HJDSS/STM32-SmartHome-Security/FIX_REPORT.md

# 论文-代码差距修复报告

> **日期:** 2026-05-18  
> **基准版本:** M1.14a → **修复后版本:** M1.15  
> **分支:** rescue/auto-rollback-20260427-0000  
> **修复方式:** 14个子Agent分3批并行修复，主Agent调度+审查+提交

---

## 修复统计

| 类别 | 数量 | 说明 |
|---|---|---|
| 🔴 严重问题已修复 | 14 | 13个代码问题 + 1个外部分析结论 |
| 🔴 未修复 | 1 | #14 移动端代码（不在本仓库范围） |
| 修改文件 | 18 | .c / .h 文件 |
| 新增代码行 | ~1200+ | 含宏定义、函数实现、注释 |
| Git提交 | 4 | 1个批次独立 + 3个批次合并 |

---

## 第1批修复 (M1.15a-b, 2 commits)

| # | 问题 | 状态 | 关键变更 |
|---|---|---|---|
| #11 | ESP8266指数退避 | ✅ | `s_backoff_ms` 1200→2400→...→60000ms，成功重置 |
| #3 | 指纹解锁接入 | ✅ | Task_Log中200ms周期调用AS608_Find_Fingerprint，匹配→开锁 |
| #1 | IPC机制 | ✅ | Queue(8)+EventGroup(3bits)+BinarySemaphore+Mutex，全局变量保护 |
| #12-13 | 蜂鸣器分级 | ✅ | beep_pattern_t五模式+软件BEEP_Tick10ms引擎 |
| #10 | AES加密方案 | ✅ | CTR→CBC, CRC16→AES-CBC-MAC(HMAC), 单密钥→双密钥窗口 |

**修改文件18个，+723/-74行**

---

## 第2批修复 (M1.15c, 1 commit)

| # | 问题 | 状态 | 关键变更 |
|---|---|---|---|
| #4 | Task_Log职责 | ✅ | STK:320→1024, PRIO:1→3, T:1000→200ms, 指纹+告警队列+抓拍 |
| #2 | FreeRTOS抓拍 | ✅ | Task_Log中调用Bare_CapturePoll() |
| #6 | MQ-2滤波 | ✅ | 中值(5样本)+滑动平均(8样本)级联 |
| #7-8 | MQ-2阈值+基线 | ✅ | Q8 IIR基线跟踪, 自适应阈值=基线+3σ+40ADC |

**修改文件4个，+143/-39行**

---

## 第3批修复 (M1.15d, 1 commit)

| # | 问题 | 状态 | 关键变更 |
|---|---|---|---|
| #5 | MQ-2温漂补偿 | ✅ | Acomp=Araw-3.2*(T-25), Q8定点, K=819 |
| #16 | MQ-2多浓度标定 | ✅ | 5级分段线性插值(0/300/1000/2000/3000ppm) |
| #9 | 多传感器融合 | ✅ | S=0.5*ePIR+0.3*eCAM+0.2*eACC, S≥0.5高可信 |
| #15 | 性能指标 | ✅ | 11个全局计数器+时间戳+uptime+栈溢出日志修复 |
| #17 | 常量清理 | ✅ | 死常量注释保留，任务参数表与app_rtos.c对齐 |

**修改文件9个，+338/-74行**

---

## 未修复项

| # | 问题 | 原因 |
|---|---|---|
| #14 | 移动端代码缺失 | uni-app为独立项目，不在STM32仓库。论文可注明"移动端代码位于独立仓库" |

---

## 提交记录

```
a3434257 fix(M1.15d): 第3批 — 温漂补偿+多浓度标定+融合评分+性能指标+常量清理
e1464dc6 fix(M1.15c): 第2批 — Task_Log职责+抓拍FreeRTOS+MQ-2滤波+自适应阈值基线
1eba3e32 fix(M1.15b): 第1批 — 指纹接入+IPC+蜂鸣器分级+AES方案修复
ca98cb1d fix(M1.15a): ESP8266重连指数退避 — 论文要求上限60秒
1adbd4c6 docs: VERSION_DOCS 更新至 M1.14a
```

---

## 修复前后对比

| 维度 | M1.14a（修复前） | M1.15（修复后） |
|---|---|---|
| 🔴 严重问题 | 17 | 1 (移动端，不在仓库范围) |
| IPC机制 | 无，全局变量裸访问 | Queue+EventGroup+Semaphore+Mutex |
| 指纹解锁 | 死代码，仅密码通道 | 双通道验证 |
| 蜂鸣器 | 单一GPIO开关 | 5种分级告警模式 |
| AES加密 | CTR+CRC16+单密钥 | CBC+HMAC+双密钥窗口 |
| MQ-2滤波 | 简单8样本平均 | 中值+滑动平均级联 |
| MQ-2阈值 | 固定2400 ADC | 自适应基线+3σ+裕量 |
| MQ-2标定 | 单线性换算 | 5级分段插值 |
| 温漂补偿 | 无 | Q8定点 Acomp=Araw-3.2*(T-25) |
| 融合评分 | 无 | S=0.5*PIR+0.3*CAM+0.2*ACC |
| 抓拍(FreeRTOS) | 损坏 | 可用 |
| Task_Log | 空壳看门狗任务 | 完整的后台任务 |
| 性能测量 | 不可测 | 11项计数器+时间戳+uptime |
| ESP8266重连 | 固定1200ms | 指数退避(上限60s) |
| board_config | 16个死常量 | 清理+任务表对齐 |
