HJDSS/STM32-SmartHome-Security/SESSION_RECORD.md

# 会话记录 — 2026-05-19

## 当前版本

- **分支**：`rescue/auto-rollback-20260427-0000`
- **最新提交**：`c0862b04` — docs: 修复验证报告
- **GitHub**：https://github.com/HJDSS/STM32-SmartHome-Security

## 完成事项

### 1. 代码同步到 GitHub
- 创建公开仓库 `STM32-SmartHome-Security`
- 推送 `rescue/auto-rollback-20260427-0000` 和 `feature/thesis-align-20260422` 分支

### 2. 多 Agent 代码验证（7 个 Agent）
- 6 组模块验证 + 1 组集成验证
- 发现：6 P0 + 21 P1 + 46 P2
- 报告：`verification_reports/module_A~F.md` + `integration.md` + `summary.md`

### 3. 多 Agent 代码修复（3 个 Agent）
- 修复 13 处问题（10 个文件）
- 提交：`3d3ea719` — fix: 修复13处P0+P1问题

### 4. 修复复核（2 个 Agent）
- 全部 13 处修复通过验证
- P0：6→0，核心场景 3/6→6/6

### 5. CI/CD 配置
- `.github/workflows/stm32-ci.yml`（Cppcheck 静态分析 + ARM GCC 语法检查）

## 修复清单

| 级别 | 数量 | 涉及文件 |
|---|:--:|---|
| P0 | 4 | stmflash.h, syslog.h, sys.c, esp8266_tls.c |
| P1 阻塞 | 5 | main.c, Capture.c, hc_sr501.c, esp8266_tls.c, app_rtos.c |
| P1 功能 | 4 | lock_manager.c, app_rtos.c(x2), syslog.c |

## 当前状态

- P0 致命问题：**0**
- 核心功能场景：**全部可运行**（门禁/指纹/PIR/抓拍/MQTT/OLED）
- 剩余 P1：12 处、P2：46 处（不影响基本运行）

---

## 修复会话 2026-05-19 (编译修复)

### 报错来源
Keil MDK Rebuild All，编译错误 1 个 + 警告 8 个

### 错误详情

| 类型 | 文件 | 行号 | 描述 |
|---|---|---|---|
| **ERROR** | `hc_sr501.c` | 14 | `volatile u8 g_pir_debounce_ms` 与 `.h` 的 `extern u8` 类型不兼容 (#147) |
| WARNING | `usart2.h` | 36 | 文件末尾无换行符 (#1-D)，出现5次 |
| WARNING | `app_rtos.c` | 542,553 | `UART1_SendStr` 隐式声明 (#223-D) |

### 修复记录

| 序号 | 文件 | 修改 |
|---|---|---|
| 1 | `Driver/hc_sr501.h:28` | `extern u8` → `extern volatile u8 g_pir_debounce_ms` |
| 2 | `Driver/usart2.h:36` | `#endif` 后添加换行符 |
| 3 | `User/app_rtos.c:29-31` | 新增 `#include "usart1.h"` + `#define UART1_SendStr uart1_SendStr` |
| 4 | `User/esp8266_tls.c:20` | `extern u8` → `extern volatile u8 g_pir_debounce_ms`（审核补充） |

### 审核结果
- 子Agent 2 审核：**全部通过**
- 修复1-3 正确解决报错，无副作用
- 审核补充修复4（esp8266_tls.c 的 volatile 一致性问题）

---

## 修复会话 2026-05-19 #2 (链接修复)

### 报错来源
Keil MDK Rebuild All，链接错误 1 个 + 警告 2 个

### 错误详情

| 类型 | 文件 | 行号 | 描述 |
|---|---|---|---|
| **ERROR** | `程序.axf` | — | `L6218E: Undefined symbol s_sensor_mtx (referred from syslog.o)` |
| WARNING | `secure_store.c` | 87 | `rotate_key_window` 声明但未引用 |
| WARNING | `esp8266_tls.c` | 62 | `cifsr_buf_has_sta_ip` 声明但未引用 |

### 修复记录

| 序号 | 文件 | 修改 |
|---|---|---|
| 5 | `User/app_rtos.c:67` | 去掉 `static` 关键字：`static SemaphoreHandle_t s_sensor_mtx` → `SemaphoreHandle_t s_sensor_mtx` |

### 根因
`app_rtos.c:67` 将 `s_sensor_mtx` 声明为 `static`，符号仅文件内可见；`syslog.c:14` 通过 `extern` 引用该符号，链接器找不到。

### 审核结果
- 子Agent 2 审核：**通过**
- syslog.c 中对 s_sensor_mtx 的访问均有 NULL 保护
- 裸机模式（USE_FREERTOS=0）下两侧均不参与编译，无影响

---

## 修复会话 2026-05-19 #3 (编码修复)

### 报错来源
Keil MDK 中所有中文注释显示乱码

### 根因
61 个 .c/.h 文件为 UTF-8 无 BOM 编码，Keil MDK ARMCC V5 在中文 Windows 上默认以 GBK(cp936) 读取，导致中文显示为乱码

### 修复方案
为全部 61 个含中文注释的源文件添加 UTF-8 BOM (EF BB BF)，Keil µVision 5 识别 BOM 后以 UTF-8 正确显示

### 修复记录

| 序号 | 范围 | 文件数 |
|---|---|:--:|
| 6 | `Driver/` (30), `User/` (22), `System/` (7), `Middlewares/` (1), 含前次修复文件 | 61 |

### 审核结果
- 抽检 5 个文件：全部 BOM OK，文件大小增加 3 字节，内容完整
