HJDSS/STM32-SmartHome-Security/biye/代码完善提示词_含版本管理.md

# 用于完善 `biye` 代码的提示词（含版本管理，2026-04 更新版）

以下内容可直接复制到 Cursor / Copilot / ChatGPT（代码模式）中执行。

---

你现在是“广东工业大学测控技术与仪器本科毕设工程实现助手”。  
请基于我的论文实现和现有工程代码，对 `biye` 项目做**功能补全与一致性修正**，并严格执行版本管理流程。

## 1) 项目背景与总目标（最新版）

- 论文主题：家用安防与智能家居联动系统（STM32F103RCT6）
- 工程形态：以 `board_config.h` 为硬件配置基线，支持裸机调试路径，并保留 FreeRTOS 论文描述对应实现
- 目标：让代码与论文中的硬件接口、功能逻辑、测试指标、异常处理策略保持一致，形成可编译、可联调、可验收版本
- 关键新增要求：摄像头抓拍时**必须本地落盘一份到 SD 卡**（云端查看与本地留存双通道）

## 2) 必须遵循的全局约束

1. **不改变核心硬件选型与引脚事实**（以 `biye/代码/User/board_config.h` 为准）
2. **不删除现有可用功能**，仅做补全、修复、对齐
3. **所有改动必须可追踪**：按功能拆分提交，提交信息清晰，禁止一次性大杂烩提交
4. **代码风格统一**：沿用当前工程风格（标准外设库/HAL兼容方式、命名风格、注释风格）
5. **优先保证稳定性**：先修编译与关键链路，再做增强

## 3) 与论文和历史记录对齐的功能清单（按优先级）

### P0（必须完成）

1. **ESP-01S 通信链路对齐**
   - USART3: PB10/PB11
   - EN/CH_PD: PC9
   - 默认波特率与联网参数走 `board_config.h` 宏
   - 启动流程：AT连通性检查 -> 入网 -> MQTT会话
   - 异常：重连、超时、状态回执

2. **SD 卡模块对齐**
   - SPI2: PB13/PB14/PB15，CS=PB12
   - FatFs 挂载流程与容错参数按 `board_config.h`
   - 仅在 `EN_FATFS_SD` 启用时生效
   - 挂载成功后再开放 BMP/日志写入，避免未就绪访问
   - 抓拍触发时执行：`OV7670/FIFO取帧 -> BMP编码 -> SD本地落盘`
   - 网络在线：上报图片地址/抓拍时间；网络离线：本地缓存待上报记录，重连后补传
   - 写卡失败不得阻塞本地安防告警动作（降级但不中断安全链路）

3. **DHT 与 MQ-2 对齐**
   - DHT 引脚 PC5，按 `BOARD_DHT_SENSOR_TYPE` 区分 DHT11/DHT22
   - MQ-2 ADC: PB0 / ADC_Channel_8
   - 采样、滤波、阈值判定逻辑与论文一致
   - 处理传感器失效/超时/悬空边界
   - 传感器离线检测与恢复：
     - DHT：连续超时/校验失败置离线，指数退避重试，连续成功自动恢复
     - MQ-2：长时间恒定或越界置异常，异常期间禁止触发应急关阀误动作
     - PIR：非布防高频触发进入抑制窗口并记日志

4. **执行器链路对齐**
   - 门锁 PC6，燃气阀 PC7，蜂鸣器 PC10
   - 蜂鸣器触发极性由 `BOARD_BEEP_ACTIVE_HIGH` 控制
   - 异常状态进入安全态（尤其复位后）
   - 看门狗复位后：执行器默认安全态（关阀、门锁默认态、蜂鸣器关闭）

### P1（建议完成）

5. **异常工况机制补全**
   - 断网离线可运行
   - 传感器故障降级
   - 电源波动/重启恢复
   - 强干扰下去抖与恢复
   - 重连幂等：下行命令基于 `cmdId+ts` 去重，避免重复执行

6. **日志与诊断**
   - 关键链路增加统一日志标签（NET/SD/SENSOR/ACT）
   - 支持简洁日志与详细调试日志开关（宏控制）
   - 必须可追踪以下事件：挂载成功/失败、抓拍开始/结束、BMP落盘成功/失败、重连开始/成功、离线/恢复

7. **参数集中化**
   - 将可调阈值、超时、重试次数集中到配置头文件
   - 杜绝魔法数字散落

### P2（可选增强）

8. **论文测试映射辅助**
   - 导出/打印便于统计的关键计数器（成功率、重试、异常次数）
   - 为第6章测试复现提供最小脚本或操作说明
   - 支持导出以下统计字段：误报率计数、重连次数、补传次数、SD写入失败次数、72h运行异常次数

## 4) 具体实施步骤（请按顺序执行）

1. 阅读并建立“事实清单”
   - 重点文件：`User/board_config.h`
   - 补充读取：ESP、SD、DHT、MQ2、执行器相关驱动与业务文件
   - 产出：当前实现与论文要求的差异列表

2. 分模块改造（每个模块独立提交）
   - `feat/net-esp01s-align`
   - `feat/sd-spi2-fatfs-align`
   - `feat/sensor-dht-mq2-align`
   - `feat/actuator-safety-align`
   - `feat/abnormal-recovery`
   - `feat/capture-sd-local-retention`

3. 每次改动后执行最小验证
   - 编译通过
   - 关键路径无回归
   - 日志可证明功能生效

4. 产出最终文档
   - 变更摘要（改了什么、为什么）
   - 测试记录（如何测、结果如何）
   - 与论文章节对应关系（第3/4/6章）
   - 关键闭环说明（抓拍->本地落盘->上报/补传）

## 5) Git 版本管理要求（严格执行）

1. **新建功能分支**
   - 分支命名：`feature/thesis-align-YYYYMMDD`

2. **提交粒度**
   - 一个功能点一个 commit
   - 提交信息格式：
     - `feat(sd): align SPI2 pin mapping and mount flow with board_config`
     - `fix(esp): enforce EN/CH_PD boot sequence and reconnect handling`
     - `refactor(sensor): centralize DHT/MQ2 thresholds and retry params`

3. **禁止操作**
   - 禁止 `git reset --hard`
   - 禁止覆盖他人未确认改动
   - 禁止一次提交改几十个不相关文件

4. **里程碑标签**
   - 完成 P0 后打 tag：`v0.9-thesis-align-core`
   - 完成 P1 后打 tag：`v1.0-thesis-align-stable`
   - 完成“抓拍本地留存闭环”后可选 tag：`v1.1-capture-sd-retention`

5. **交付前检查**
   - `git status` 干净
   - 构建通过
   - 变更说明文档已更新
   - 抓拍触发后能在 SD 中检索到对应 BMP 文件（含时间戳）

## 6) 验收标准（必须全部满足）

1. 编译通过，无新增严重告警/错误  
2. ESP、SD、DHT/MQ2、执行器链路与 `board_config.h` 一致  
3. 关键异常场景可复现并有容错表现  
4. 提交历史清晰，能看懂每一步改动目的  
5. 代码行为与论文第3章（硬件）、第4章（软件）、第6章（测试）不冲突  
6. 抓拍场景下“云端可见 + SD本地可查”双通道同时成立  
7. 离线场景下至少保证“本地告警 + SD留存”可用

## 7) 输出格式要求（让助手按此返回）

请按以下结构输出你的工作结果：

1. 差异分析（现状 vs 目标）  
2. 改动计划（按P0/P1/P2）  
3. 实际改动文件清单  
4. 每个 commit 的摘要  
5. 验证结果与遗留问题  
6. 下一步建议

---

如果你发现论文描述与 `board_config.h` 冲突，**以代码硬件事实为准**，并在变更说明中标注“论文待同步项”。
