HJDSS/STM32-SmartHome-Security/biye/硬件/PCB硬件连线说明.md

# PCB 硬件连线说明（用于画板/对照程序）

**文档目的**：给 PCB 设计/接线使用，列出工程涉及的**全部硬件功能**（含当前未启用/未实现但已预留的功能），并确保与程序的**实际引脚分配与逻辑**一致。  
**引脚权威来源**：`biye\代码\User\board_config.h`（最终以该文件为准）。  
**行为约束来源**：`biye\代码\User\main.c`、`biye\代码\Driver\gpio.h/.c`、`biye\代码\User\linkage.*`、`biye\代码\System\usart\usart1.c` 等。

---

## 1. 核心信息（必须先看）

- **MCU**：STM32F103RCT6（LQFP64，3.3V 逻辑电平，72MHz 典型配置）
- **调试下载口**：**SWD 固定占用 PA13/PA14**；程序会**关闭 JTAG、保留 SWD**（见 `main.c` 的 `GPIO_PinRemapConfig(GPIO_Remap_SWJ_JTAGDisable, ENABLE)`）。
- **摄像头固定启用**：`board_config.h` 中 `EN_OV7670_LOCAL` 在全功能与密码调试模式都为 1（键盘 Y3/Y4 固定 PB1/PB2，且 **PA0~PA7 被 OV 数据总线占用**）。
- **关键冲突点（设计时必须二选一）**：
  - **PC8**：默认被配置成 **printf 软件串口 TX**（`BOARD_PRINTF_SOFTUART_PC8=1`，见 `usart1.c`），此时**照明继电器功能会被屏蔽**（`linkage.c` 中 `#if !BOARD_PRINTF_SOFTUART_PC8` 才驱动灯继电器）。
  - **USART1（PA9/PA10）**：既连接 **AS608 指纹模块**，又可能承载调试串口（`uart1_SendStr/printf`）。硬件上允许并联 USB‑TTL，但实际使用建议分时，避免干扰。

---

## 2. 供电与电气约束

- **3.3V 供电**：STM32、OLED、OV7670、SD（部分卡可 3.3V）、ESP8266（多数模块需稳定 3.3V、大电流峰值）、AS608、传感器等建议统一 3.3V 域。
- **5V 模块注意**：若 PIR/MQ2/继电器板为 5V，需确认其 IO 电平是否可直接与 3.3V MCU 兼容；不兼容时必须做电平转换/三极管隔离。
- **共地**：所有模块必须与 MCU **GND 共地**（外接 USB‑TTL/独立电源也必须共地）。
- **继电器/蜂鸣器驱动**：PCB 上建议预留**三极管/MOS 驱动 + 续流二极管**（若模块已带驱动则可直连信号）。

---

## 3. 接口分区与信号列表（按功能分组）

> 说明：下表中的“方向”是相对 MCU；“默认状态”是上电初始化后的预期（与驱动代码一致）。

### 3.1 下载与保留引脚

| 功能 | MCU 引脚 | 方向 | 备注 |
|---|---|---|---|
| SWDIO | PA13 | 双向 | **必须保留**，不要接外设 |
| SWCLK | PA14 | 输入 | **必须保留**，不要接外设 |
| NRST | NRST | 输入 | 建议引出到调试接口；可加 RC/按键复位 |
| BOOT0 | BOOT0 | 输入 | 建议预留跳帽/电阻位，便于量产/救砖 |

补充说明：

- **USART2（PA2/PA3）在本工程未初始化**，且 **PA0~PA7 已被 OV 数据口占用**（因此不要规划 PA2/PA3 作外设 UART）。
- **USB 功能不在本工程使用范围**：摄像头占用 **PA12**（在很多资料里 PA12 常与 USB D+ 相关），此工程以 OV 采集为主。

### 3.2 OLED 显示（I2C，软件模拟）

| 功能 | MCU 引脚 | 方向 | 连接对象 | 备注 |
|---|---|---|---|---|
| I2C_SCL | PB8 | 输出/开漏（软件） | OLED SCL | 模块必须是 **I2C 四线款**（VCC/GND/SCL/SDA） |
| I2C_SDA | PB9 | 双向/开漏（软件） | OLED SDA | 建议上拉（常用 4.7k~10k 到 3.3V，部分模块自带） |

### 3.3 4×4 矩阵键盘

**扫描方式**：行 X 上拉输入、列 Y 推挽输出（见 `board_config.h` 注释）。长杜邦线建议列端上拉并适当去抖（固件已对长线做了更保守的时序参数）。

| 键盘信号 | MCU 引脚 | 方向 | 建议 |
|---|---|---|---|
| X1 | PC0 | 输入 | 行线建议上拉；避免与强干扰走线并行 |
| X2 | PC1 | 输入 | 同上 |
| X3 | PC2 | 输入 | 同上 |
| X4 | PC3 | 输入 | **不要误接到 PC10（蜂鸣器）**；也不要接 PC13（部分核心板 LED） |
| Y1 | PC11 | 输出 | 列端建议并 4.7k~10k 上拉到 3.3V（长线抗干扰） |
| Y2 | PC12 | 输出 | 同上 |
| Y3 | PB1 | 输出 | **固定**；与 OV 数据总线无冲突 |
| Y4 | PB2 | 输出 | **固定**；与 OV 数据总线无冲突 |

### 3.4 蜂鸣器

| 功能 | MCU 引脚 | 方向 | 默认状态 | 备注 |
|---|---|---|---|---|
| BEEP | PC10 | 输出 | 默认关闭 | **低电平触发**（`BOARD_BEEP_ACTIVE_HIGH=0`：IO 拉低响） |

### 3.5 门锁继电器（电磁锁/电机锁控制）

| 功能 | MCU 引脚 | 方向 | 默认状态 | 备注 |
|---|---|---|---|---|
| DOOR_LOCK_RELAY | PC6 | 输出（开漏） | 默认关闭（上电 `GPIO_ResetBits`，逻辑以 `RELAY` 宏为准） | `gpio.h` 强制 `RELAY=PCout(6)`；**PB12 仅能做 SD_CS，不能再做门锁** |

> 继电器驱动与触点：按你的锁类型选择常开/常闭；建议预留 TVS/RC 吸收与端子。

### 3.6 燃气阀继电器（应急关阀）

| 功能 | MCU 引脚 | 方向 | 默认状态 | 备注 |
|---|---|---|---|---|
| GAS_VALVE_RELAY | PC7 | 输出 | 默认“开阀/通气” | 触发燃气报警时会**关阀**（见 `Emergency_IO_Init`/`MQ2_Emergency_Run`） |

### 3.7 照明继电器（联动）

| 功能 | MCU 引脚 | 方向 | 默认状态 | 备注 |
|---|---|---|---|---|
| LIGHT_RELAY | PC8 | 输出 | 默认关闭 | **仅当 `BOARD_PRINTF_SOFTUART_PC8=0` 时才启用照明继电器**（否则 PC8 被软件串口 TX 占用） |

### 3.8 PIR 人体红外（HC-SR501）

| 功能 | MCU 引脚 | 方向 | 备注 |
|---|---|---|---|
| PIR_OUT | PC4 | 输入 | 支持 EXTI4（程序可用中断/轮询，当前默认中断确认 + 兜底连续高电平判定） |

### 3.9 温湿度传感器（DHT11/DHT22 单总线）

| 功能 | MCU 引脚 | 方向 | 备注 |
|---|---|---|---|
| DHT_DATA | PC5 | 双向 | `board_config.h` 默认 `BOARD_DHT_SENSOR_TYPE=22`（按 DHT22 时序读） |

### 3.10 燃气/烟雾（MQ-2 模拟量）

| 功能 | MCU 引脚 | 方向 | 备注 |
|---|---|---|---|
| MQ2_AO (ADC1_IN8) | PB0 | 输入（模拟） | `ADC_Channel_8`；若 PB0 悬空会漂移误报，固件含预热/确认策略（`main.c`） |

### 3.11 SD 卡（SPI2）

| 功能 | MCU 引脚 | 方向 | 备注 |
|---|---|---|---|
| SD_CS | PB12 | 输出 | **专用**；不要复用为门锁等 |
| SPI2_SCK | PB13 | 输出 | SPI2 |
| SPI2_MISO | PB14 | 输入 | SPI2 |
| SPI2_MOSI | PB15 | 输出 | SPI2 |

### 3.12 ESP8266 WiFi（USART3 + EN）

| 功能 | MCU 引脚 | 方向 | 连接对象 | 备注 |
|---|---|---|---|---|
| ESP_TXD（MCU→ESP_RX） | PB10 | 输出 | ESP8266 RX | USART3，默认 115200 |
| ESP_RXD（ESP_TX→MCU） | PB11 | 输入 | ESP8266 TX | USART3，默认 115200 |
| ESP_EN / CH_PD | PC9 | 输出 | EN/CH_PD | 若用 NodeMCU 开发板可不由 MCU 控制（`BOARD_WIFI_USE_NODEMCU`） |

### 3.13 指纹模块 AS608（USART1 + 状态脚）

| 功能 | MCU 引脚 | 方向 | 连接对象 | 备注 |
|---|---|---|---|---|
| USART1_TX | PA9 | 输出 | AS608 RX | 默认 57600（`uart1_Init(57600)`） |
| USART1_RX | PA10 | 输入 | AS608 TX | 同上 |
| PS_Sta | PA8 | 输入 | AS608 PS_Sta | 状态检测脚（程序会初始化并读取） |

### 3.14 摄像头 OV7670 + FIFO（本地采集）

**数据总线**（占用 PA0~PA7）：

| 功能 | MCU 引脚 | 方向 | 备注 |
|---|---|---|---|
| OV_D0~D7 | PA0~PA7 | 输入 | **PA0~PA7 专用**，不要再分配给其它外设 |

**时序与 FIFO 控制**：

| 功能 | MCU 引脚 | 方向 | 备注 |
|---|---|---|---|
| VSYNC | PA11 | 输入 | 帧同步 |
| RCK | PA12 | 输出 | 读时钟（注意与 USB D+ 复用：本工程以摄像头为主） |
| WRST | PB3 | 输出 | FIFO 写复位；JTAG 已关闭所以 PB3 可用 |
| RRST | PB4 | 输出 | FIFO 读复位；JTAG 已关闭所以 PB4 可用 |
| WREN | PB5 | 输出 | FIFO 写使能 |
| OE | PB6 | 输出 | FIFO 输出使能 |

**SCCB（类似 I2C，用于配置 OV 寄存器）**：

| 功能 | MCU 引脚 | 方向 | 备注 |
|---|---|---|---|
| SCCB_SCL | PD2 | 输出/开漏（软件） | 刻意与 OE(PB6) 分离，避免复用冲突 |
| SCCB_SDA | PB7 | 双向/开漏（软件） | 建议上拉 4.7k~10k 到 3.3V（若模块未带） |

---

## 4. “功能开关/未实现功能/预留接口”清单（画板要预留）

### 4.1 已实现但可能在默认宏下关闭的功能

- **ESP8266/OneNET 云端**：硬件必须按 §3.12 预留；软件通过 `EN_ESP8266_ONENET` / `DEBUG_PASSWORD_ESP8266_ENABLE` 控制是否启用。
- **MQ-2 超限应急联动**：硬件必须预留 PB0（ADC）与 PC7（燃气阀）；软件通过 `BOARD_MQ2_ALARM_ENABLE` 控制（在密码调试模式强制为 1）。
- **照明继电器联动**：硬件可预留 PC8 继电器，但要注意与 PC8 软件串口冲突（见 §1）。

### 4.2 预留但当前版本“不包含/未分配”的功能（建议 PCB 预留扩展位）

- **通风继电器**：`board_config.h` 明确写了“本版不包含通风、空调继电器”（无引脚分配）。
- **空调继电器**：同上。
- **语音模块串口**：`linkage.h` 仅做了 `VOICE_UART_SEND_STR` 映射到 `uart1_SendStr`，没有独立 UART 引脚分配；若要加独立语音模块，建议 PCB 预留一组 UART（比如 USART2/其它 IO 软串口）与电源/音频接口。

---

## 5. PCB 设计建议（与程序强相关）

- **键盘列 Y 上拉**：若键盘走线/杜邦较长，列端（Y1~Y4）建议加 4.7k~10k 到 3.3V，上电更稳定、丢键更少（固件也启用了更保守的去抖与建立时间）。
- **PC8 冲突处理**（重要）：
  - 若你要 **照明继电器**：把 `BOARD_PRINTF_SOFTUART_PC8` 置 0（软件侧），PCB 上 PC8 接继电器驱动。
  - 若你要 **稳定调试串口输出（不占 USART1）**：保持 `BOARD_PRINTF_SOFTUART_PC8=1`，PCB 上 PC8 出一针做 **SoftUART TX**（接 USB‑TTL RX），同时 **不要把 PC8 用作继电器**（即使接了也不会被驱动）。
- **USART1 共用**：AS608 与调试串口共用同一 UART 时，PCB 上建议：
  - 给 AS608 留专用 4P/6P 插座；
  - 给 USB‑TTL 留测试点（TX/RX/GND），并在使用上注明“与指纹分时/避免同时占用”。
- **ESP8266 供电与地回流**：ESP 供电峰值电流大，PCB 走线与去耦要足，EN/CH_PD 建议上拉并可由 PC9 控制。
- **模拟量 PB0（MQ2）**：走线短、远离 SPI/UART/继电器；建议 RC 滤波/保护；模块 AO 输出需在 0~3.3V 范围。

---

## 6. 快速核对（画板后自检用）

- OLED：PB8=SCL、PB9=SDA（I2C 款屏），3.3V/GND 正确。
- 键盘：PC0~PC3 为行、PC11/PC12/PB1/PB2 为列（行列接反会完全无键）。
- 门锁：PC6；燃气阀：PC7；蜂鸣器：PC10（低电平响）。
- PIR：PC4；DHT：PC5；MQ2 AO：PB0(ADC1_IN8)。
- SD：PB12~PB15（SPI2）；ESP：PB10/11（USART3）+ PC9(EN)。
- 摄像头：PA0~PA7 + PA11/PA12 + PB3~PB7 + PD2。

---

## 7. 版本记录

- **生成依据**：`board_config.h` 的引脚分配 + `main.c/gpio/linkage/usart1` 的实际使用路径整理。
