HJDSS/STM32-SmartHome-Security/论文相关/答辩交付包/论文.pdf

# 本科毕业设计（论文）

# 家用安防与智能家居联动系统设计

学 | 院： | 机电工程学院
专 | 业： 测控技术与仪器
年级班别： | 2022 级（2）班
学 | 号： | 3122000256
学生姓名： | 何俊达
指导教师： | 张巧芬

2026 年 4 月

目录

摘要

英文摘要

1 绪论 | 1
2 系统总体方案设计 | 4

3 系统硬件设计 | 10
4 系统软件设计 | 30

5 移动端交互设计与实现 | 47
6 系统测试与结果分析 | 51

7 总结与展望 | 64
参考文献 | 67
致谢 | 70

附录 A 附录 | 71

摘要

面向家庭场景中门禁失效、入侵行为、燃气泄漏和环境异常等典型风险，本文设计

并实现了一套基于 STM32F103RCT6 的家用安防与智能家居联动系统。系统采用“感知

层-控制层-通信层-应用层”四层架构，硬件侧集成 AS608 指纹识别、HC-SR501 人体红

外、DHT 温湿度、MQ-2 可燃气体、OV7670+FIFO 图像采集、SD 卡存储及门锁/燃气

阀/蜂鸣器执行单元；软件侧构建可切换的“裸机调试模式 +FreeRTOS 运行模式”，实现

门禁认证、布撤防管理、入侵报警、燃气应急、日志记录与状态上报。系统通过 ESP8266

接入 OneNET，基于 MQTT 完成状态上报与远程控制，并采用 AES-128 本地加密及 TLS

传输加固策略。

系统测试按照“单元功能-系统联动-性能指标-稳定性”四个层次开展。结果表明：

门禁识别准确率为 98.0%，入侵检测误报率为 3.2%，本地告警平均时延为 620 ms，远程

控制平均时延为 1850 ms，图像上传成功率为 96.5%，72 h 连续运行无死机与任务阻塞。

研究表明，单芯片集中控制方案能够在毕业设计规模下兼顾实时性、可靠性、成本与可

扩展性，可为低成本家庭安防联动系统提供可复用的工程参考。

关键词智能家居，家庭安防，STM32F103RCT6，FreeRTOS，MQTT

课题来源企、事业单位委托项目

### Abstract

With increasing demands for integrated home protection, environment awareness, and re-

mote interaction, traditional isolated security devices are no longer sufficient for practical house-

hold scenarios. This thesis investigates and implements a home security and smart home linkage

system based on a practical engineering implementation, and proposes an integrated hardware-

software solution centered on a single-chip STM32F103RCT6 architecture.

At the hardware level, the system integrates AS608 fingerprint access, PIR intrusion sens-

ing, DHT temperature-humidity acquisition, MQ-2 gas monitoring, OV7670+FIFO local image

capture, SD-card storage, and actuator modules for door lock, gas valve, and buzzer, form-

ing a local closed-loop chain of sensing, decision, execution, and feedback. At the software

level, a switchable architecture between bare-metal debugging mode and FreeRTOS runtime

mode is designed to support access control, arming/disarming, intrusion alarm, gas emergency

response, logging, and serial JSON status output. For networking, ESP8266 over USART3

connects to OneNET MQTT services for telemetry upload and remote command interaction.

Security enhancement is implemented through AES-based local sensitive data protection and

optional TLS-secured communication paths.

System validation follows a layered test strategy covering unit function, scenario linkage,

performance metrics, and long-term stability. Results show that the prototype reliably supports

both local autonomous protection and remote collaborative control in representative household

conditions, while maintaining expected response behavior on critical paths and stable operation

in continuous tests. The study demonstrates that a single-controller design can balance imple-

mentation complexity, debugging efficiency, and extensibility at undergraduate project scale,

and provides a practical engineering reference for low-cost, reusable home security linkage

systems.

Key wordssmart home, home security, STM32F103RCT6, FreeRTOS, MQTT

1 绪论

1.1 研究背景与意义

家庭安防需求增长已具备明确的数据基础。一方面，终端用户规模持续扩大。CNNIC

第 54 次统计报告显示，截至 2024 年 6 月，我国网民规模达到 10.9967 亿，互联网普及

率为 78.0%，其中通过智能家居设备上网的用户占比为 21.9%[1]。另一方面，家庭场景

安全事件具有高频与高风险特征。国家消防救援局通报显示，2024 年全国共接报火灾

90.8 万起，其中建构筑物火灾 39.1 万起；在建构筑物火灾中，居住场所火灾 30.9 万起，

占比 79%[2]。上述数据表明，家庭端“智能化需求增长”与“安全风险常态化”并存，安

防系统设计必须兼顾可用性与可靠性。

现有家庭安防产品在工程应用中仍存在三类典型痛点：其一，设备异构导致跨模块

联动弱，身份识别、环境感知与执行控制常为分散子系统；其二，系统对云端依赖较高，

弱网或断网条件下关键安防链路易降级；其三，异常处理多停留在单点告警，缺少“检

测-判定-执行-反馈”的闭环机制。针对上述问题，本课题聚焦于单芯片多源融合与本地

自治闭环，实现“本地安全动作优先、远程协同增强”的家用安防与智能家居联动系统。

结合测控技术与仪器专业培养目标，本课题的研究价值主要体现在三个方面：一是

体现传感检测、嵌入式控制、通信与系统集成的综合运用能力；二是通过可量化指标与

可复现实验验证工程设计有效性；三是形成可迁移的低成本技术方案，为中小规模家庭

场景提供工程参考。

1.2 国内外研究现状

现有研究可归纳为“云平台主导型”和“边缘控制增强型”两类路径。云平台主导

型方案在跨设备互联、可视化管理和生态扩展方面具有明显优势，尤其在多协议接入与

远程运维方面成熟度较高[3-5]；但其核心短板在于关键安防动作对网络质量与平台可用

性依赖较强，弱网场景下时延抖动和控制失配风险上升。边缘控制增强型方案强调本地

决策与快速响应，在门禁、入侵和燃气应急等实时链路上更具确定性[6-8]；但其不足在

于多模块并发管理复杂、协议扩展性有限，且在安全机制与工程维护上容易出现碎片化

设计。

进一步对比可见，国内外研究普遍在单点功能上取得较好效果，如多模态身份认证、

远程联动控制、气体泄漏监测与告警[9-12]；然而面向本科工程设计可落地场景，仍存在

三项共性缺口：其一，缺少“本地自治优先 + 远程协同”的统一架构；其二，缺少面向

弱网和异常工况的系统级容错闭环；其三，缺少与测试指标一一对应的量化设计与验证

链路。基于上述缺口，本文提出以 STM32F103RCT6 为核心的单芯片集中控制方案，通

过 FreeRTOS 任务化调度与 MQTT 远程协同实现“关键路径本地闭环、非关键路径网络

增强”的工程实现思路。

1.3 研究目标与主要内容

本研究的总体目标是构建一套面向家庭场景的安防联动系统，实现门禁认证、入侵

检测、环境监测、燃气应急和远程控制的系统级闭环，并在资源受限条件下兼顾实时性、

可靠性与可维护性。为保证目标可验证，本文定义如下量化指标，并在第 6 章进行逐项

测试验证：

1、门禁识别准确率 ≥ 95.0%；

2、入侵检测误报率 ≤ 5.0%；

3、本地告警响应时延 ≤ 1000 ms；

4、远程控制响应时延 ≤ 2500 ms；

5、空闲功耗 ≤ 600 mW，告警状态功耗 ≤ 1200 mW；

6、图像上传成功率 ≥ 90.0%；

7、系统连续稳定运行 72 h 无死机和任务阻塞。

围绕上述目标，本文主要研究内容与技术路线如下：首先，完成需求分解与四层架构

设计，明确“本地自治优先、远程协同增强”的系统原则；其次，完成以 STM32F103RCT6

为核心的硬件实现，建立多源传感与执行链路；然后，构建裸机/FreeRTOS 双模式软件

架构，通过任务调度与状态机实现关键业务逻辑；进一步，设计串口与 MQTT 通信协议

并实现 AES-128 与 TLS 分层安全机制；最后，建立“单元-联动-性能-稳定性”的测试

体系，形成指标闭环验证。该路线实现了“需求-设计-实现-验证”的完整工程链条。

1.4 论文结构安排

全文共 7 章，结构安排如下：第 1 章阐述研究背景、现状对比、研究目标与技术路

线；第 2 章给出系统需求、总体架构与关键技术选型；第 3 章说明硬件模块设计、接口

分配与实现要点；第 4 章说明软件架构、核心控制逻辑、通信协议与安全机制；第 5 章

介绍移动端交互与远程控制实现；第 6 章开展分层测试并对关键指标进行量化评估；第

7 章总结研究结论，分析不足并提出后续改进方向。

## 2 系统总体方案设计

2.1 系统需求分析

系统总体方案设计遵循“需求可量化、架构可实现、指标可验证”的工程原则。结

合家庭门厅、客厅和厨房等典型场景，系统需同时应对身份鉴别、入侵检测、环境异常

和执行联动四类任务，并在弱网条件下保持关键安防能力可用。为保证方案可落地，需

求分析从功能需求、性能需求和工程约束三个维度展开。

2.1.1 功能需求

在功能层面，系统应至少覆盖以下业务闭环：

1、门禁闭环：完成指纹采集、身份比对、开锁执行与日志记录；

2、入侵闭环：在布防状态下完成 PIR 触发、告警执行、抓拍与状态上报；

3、燃气应急闭环：完成 MQ-2 异常判定、燃气阀切断、蜂鸣器告警和持续上报；

4、远程控制闭环：移动端下发控制指令后，设备完成执行并回传状态确认。上述功能

要求系统具备多事件并发处理能力，且本地关键动作不依赖云端可达性。

2.1.2 性能需求

在性能层面，系统指标与第 6 章测试指标保持一一对应关系，具体如下：

1、门禁识别准确率 ≥ 95.0%；

2、入侵检测误报率 ≤ 5.0%；

3、本地告警响应时延 ≤ 1000 ms；

4、远程控制响应时延 ≤ 2500 ms；

5、空闲功耗 ≤ 600 mW，告警状态功耗 ≤ 1200 mW；

6、图像上传成功率 ≥ 90.0%；

7、连续运行 72 h 无死机与任务阻塞。上述指标用于约束硬件选型、软件调度策略与通

信机制，避免方案设计与测试验证脱节。

2.1.3 工程约束

工程约束主要来自资源、环境和成本三方面：

1、资源约束：单芯片平台需同时承载多传感采集、执行控制、串口通信与日志管理；

2、环境约束：家庭环境存在温湿波动、电磁干扰和网络抖动，要求系统具备容错与降

级机制；

3、成本约束：在毕业设计预算下优先选择成熟器件与通用开发工具，控制系统复杂度

与维护成本。因此，系统总体方案需在“实时性、可靠性、可扩展性、成本”之间进行

综合平衡。

2.2 系统总体架构

为满足上述需求，系统采用“感知层-控制层-通信层-应用层”四层架构。

1、感知层：由 AS608、HC-SR501、DHT、MQ-2 及 OV7670+FIFO 组成，负责状态采集

和事件触发；

2、控制层：由 STM32F103RCT6 实现数据融合、状态机判定与执行器控制；

3、通信层：由本地串口链路与 ESP8266-MQTT 链路组成，负责调试、上报与命令传输；

4、应用层：由 OneNET 与移动端界面组成，提供状态展示、告警提示与远程控制入口。

该架构形成“自底向上的状态数据流”和“自顶向下的控制命令流”，并通过本地控制

优先策略确保关键路径实时性。系统总体结构如图2.1所示。


图 2.1 系统总体架构

2.3 单芯片控制架构设计

针对多模块并发和资源受限条件，系统采用单芯片集中控制架构。与多控制器分布

式方案相比，该架构可减少板间通信、协议同步和联调复杂度，更适合本科毕业设计周

期内的实现与验证。

2.3.1 功能分工

单芯片侧统一完成网络通信、数据融合、规则匹配、告警上报与外设驱动控

制。门锁/燃气阀/蜂鸣器执行链路、PIR/DHT/MQ-2 采样链路、AS608 认证链路以及

OV7670+FIFO 抓拍链路均由同一控制器协调管理，从而降低接口边界不一致导致的状

态冲突风险。

2.3.2 资源分配

资源分配遵循“关键安全任务优先、网络服务任务次优先、展示任务低优先”的原

则。入侵判定、门禁控制与燃气应急在本地直接执行；网络上报、日志整理和界面刷新

在后台任务中调度。该分配策略可在网络异常时保持基础安防功能可用，并减少非关键

任务对关键时延的干扰。

2.4 系统工作流程

系统工作流程覆盖上电初始化、状态监控、事件处理、联动执行与反馈上报五个阶

段。流程化设计用于明确模块协作时序，降低并发条件下的状态竞争与误动作风险。

2.4.1 上电启动流程

系统上电后先完成时钟、GPIO、串口、定时器、ADC 和外部中断初始化，再按配

置进入裸机或 FreeRTOS 模式。调试阶段优先验证本地门禁与安防链路；全功能模式下

启动采集、通信、抓拍、联动和告警任务，实现完整业务闭环。

2.4.2 居家/布防/应急流程

系统支持居家、布防与应急三类典型场景。居家模式强调低干扰与状态监测；布防

模式强化入侵检测与告警联动；应急模式在气体超阈值或高风险事件触发时优先执行关

阀、蜂鸣和状态上报，形成快速闭环处置机制。

系统工作流程如图2.2所示。

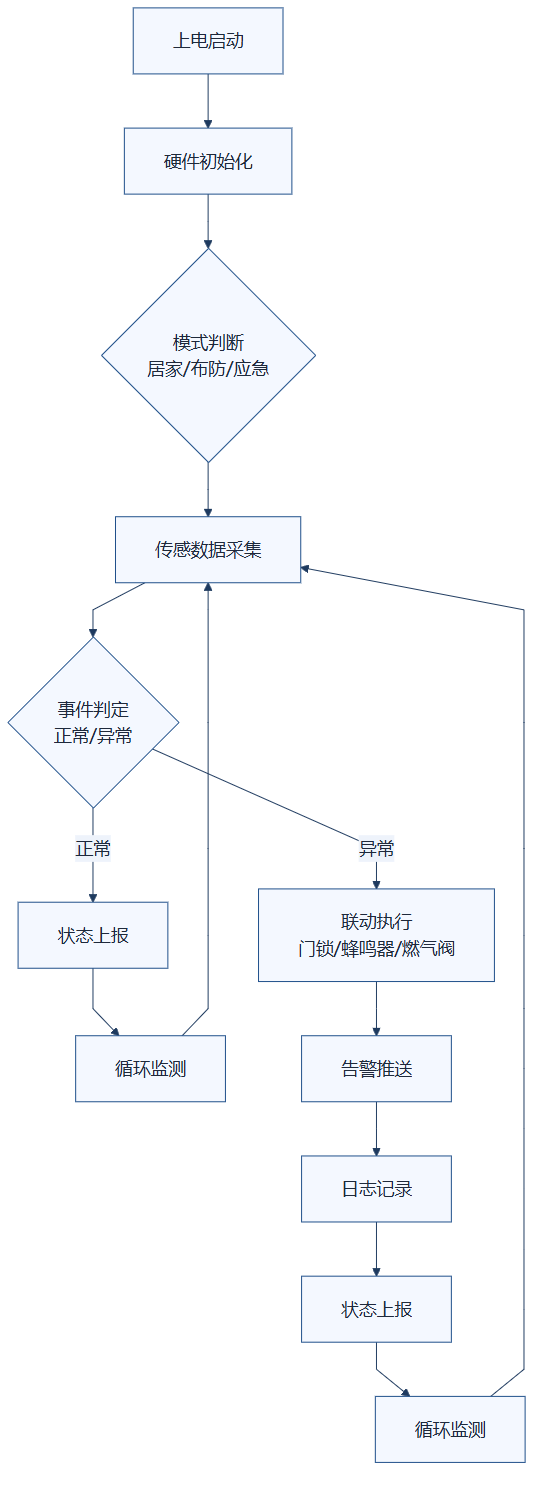
[picture p50: figure]

图 2.2 系统工作流程

2.5 关键技术选型

关键技术选型以“指标达成优先、工程落地优先、成本可控优先”为原则，从控制

器、调度机制、通信协议和安全机制四个维度进行论证。关键技术选型对比如图2.3所

示。

图 2.3 关键技术选型矩阵

2.5.1 控制器：STM32F103RCT6

控制器需满足多 GPIO 占用、并口摄像头采集、多串口通信及定时中断并发等要求，

同时兼顾开发生态成熟度与器件可获得性。综合比较后，本设计选择 STM32F103RCT6

作为控制核心，以满足当前外设规模和后续功能扩展需求[13-14]。

2.5.2 系统：FreeRTOS

系统调度层需支持多任务并发、优先级抢占、任务通信和超时管理，保障告警链路

实时响应与通信链路稳定运行。相较纯裸机超循环，FreeRTOS 在并发控制和可维护性

方面更具优势，因此本文采用 FreeRTOS 实现任务化调度[15-16]。

2.5.3 通信：MQTT

远程链路需满足低带宽开销、弱网可用和异步消息分发要求。对比 HTTP 轮询方案，

MQTT 在报文开销、连接保持和发布/订阅解耦方面更适合物联网终端，因此本文采用

MQTT 作为设备与移动端之间的核心通信协议[17-18]。

2.5.4 加密：AES-128、TLS

系统安全需同时覆盖本地存储与公网传输。考虑 MCU 资源约束，本文采用 AES-128

实现本地敏感数据加密，并在 MQTT 链路上配置 TLS 传输加密，形成“本地数据保护

+ 网络链路保护”的双层安全机制[19-21]。

2.6 本章小结

本章完成了系统需求分解、四层架构设计、单芯片控制策略与关键技术选型，明确

了系统“感知-判定-执行-反馈”的工程闭环。通过量化指标约束与技术路线匹配，形成

了可验证、可复现的总体方案，为第 3 章硬件实现和第 4 章软件实现提供了设计依据。

## 3 系统硬件设计

3.1 硬件总体设计

硬件总体设计遵循“功能闭环、接口清晰、参数可计算、调试可复现”的工程原则，

以 STM32F103RCT6 为控制核心，集成感知、执行、通信和存储单元。系统在结构上采

用单板集中控制，减少跨板连接和协议同步带来的联调风险；在电气上采用分域供电与

驱动隔离策略，降低继电器和无线发射等大扰动负载对采样与控制链路的影响。硬件总

体方案同时满足测控系统的三项基础要求：测量链路稳定、控制链路可靠、异常工况可

恢复。硬件总体连接关系如图3.1所示。


图 3.1 硬件总体连接框图

表 3.1 系统硬件模块组成与功能

模块类别 | 核心器件 | 主要功能 | 备注
主控模块 | STM32F103RCT6（单 芯片） | 任务调度、网络 通信、联动决策 | 裸机/FreeRTOS 可切换
门禁模块 | AS608 | 指纹采集与身份 验证 | UART
安防检测模块 | HC-SR501 | 人体移动检测 | GPIO 中断
环境监测模块 | DHT11/22、MQ-2 | 温湿度/气体采集 周期采样
图像采集模块 | OV7670+FIFO | 异常抓拍与图像 缓存 | 并口
执行模块 | 门锁/燃气阀继电器、 蜂鸣器 | 设备联动与本地 报警 | 驱动隔离
存储模块 | SD 卡（SPI2） | 抓拍 BMP 与容 量统计 | FatFs

3.2 主控最小系统设计

主控最小系统基于 STM32F103RCT6 构建，包含时钟、复位、调试下载和电源去

耦四个基础电路，设计目标是保证 72 MHz 主频下稳定运行并具备抗瞬态扰动能力。时

钟电路采用外部晶振 +PLL 方案，满足串口通信和定时采样精度要求；复位电路采用上

电复位与按键复位并行设计，防止电压爬升缓慢导致的启动异常；调试接口采用 SWD

（PA13/PA14），在保留在线调试能力的同时释放 JTAG 引脚资源。主控最小系统原理结

构如图3.2所示。

图 3.2 主控最小系统原理图


图 3.3 STM32F103RCT6 主控最小系统原理图（原理图）

表 3.2 主控最小系统关键参数

参数项 | 配置 | 说明
系统时钟 | 72MHz | 外部晶振 +PLL
工作电压 | 3.3V | 稳压供电
下载调试接口 | SWD （PA13/PA14） | 关闭 JTAG，保留 SWD
主要串口 | USART1 +
| USART3 | USART1 用于 AS608/调试， USART3 用于 ESP8266
核心外设占用 | OV 并口 +SPI2+ 多 GPIO | 支持摄像头、SD、传感与执行器并 发

3.2.1 主控去耦与时钟稳定设计

针对主控高速切换电流，电源引脚按“就近、小容值高频旁路 + 中容值储能”配置

去耦网络：每组 VDD/VSS 邻近放置 0.1 µF 陶瓷电容，并在电源入口配置 10 µF 电解/钽

电容。其设计依据为

C ≥

Istep · ∆t
∆V

(3.1)

其中，Istep 为瞬态电流，∆t 为电流跃迁持续时间，∆V 为允许电压跌落。按 Istep = 60 mA、

∆t = 1 µs、∆V = 0.1 V 估算，最小电容约为 0.6 µF，结合多点分布和 ESR 因素采用“多

颗 0.1 µF 并联 +10 µF 储能”配置。时钟支路通过短走线、对称布线和地参考完整性控

制降低时钟抖动与串扰。

3.3 感知层模块设计

感知层承担多源信息采集任务，是系统实现智能判定的输入基础。各传感模块按信

号类型分为数字量触发链路（AS608、PIR、DHT）和模拟量采样链路（MQ-2），并在控

制层完成时间同步、阈值判定和事件融合，再通过串口 JSON 或 MQTT 上报[22-26]。感知

层各传感器接线关系如图3.4所示。


图 3.4 传感器模块接线示意

3.3.1 AS608 指纹模块

门禁识别模块选型重点是识别准确率、模板容量、接口复杂度和供电兼容性。AS608

支持 UART 通信和模板管理，驱动实现复杂度低于 SPI 并行方案，且与 3.3 V 控制域兼

容，满足“低改造成本 + 可快速联调”的设计需求。综合比较中，AS608 在本项目规模

下优于仅支持小容量模板的低端模块。

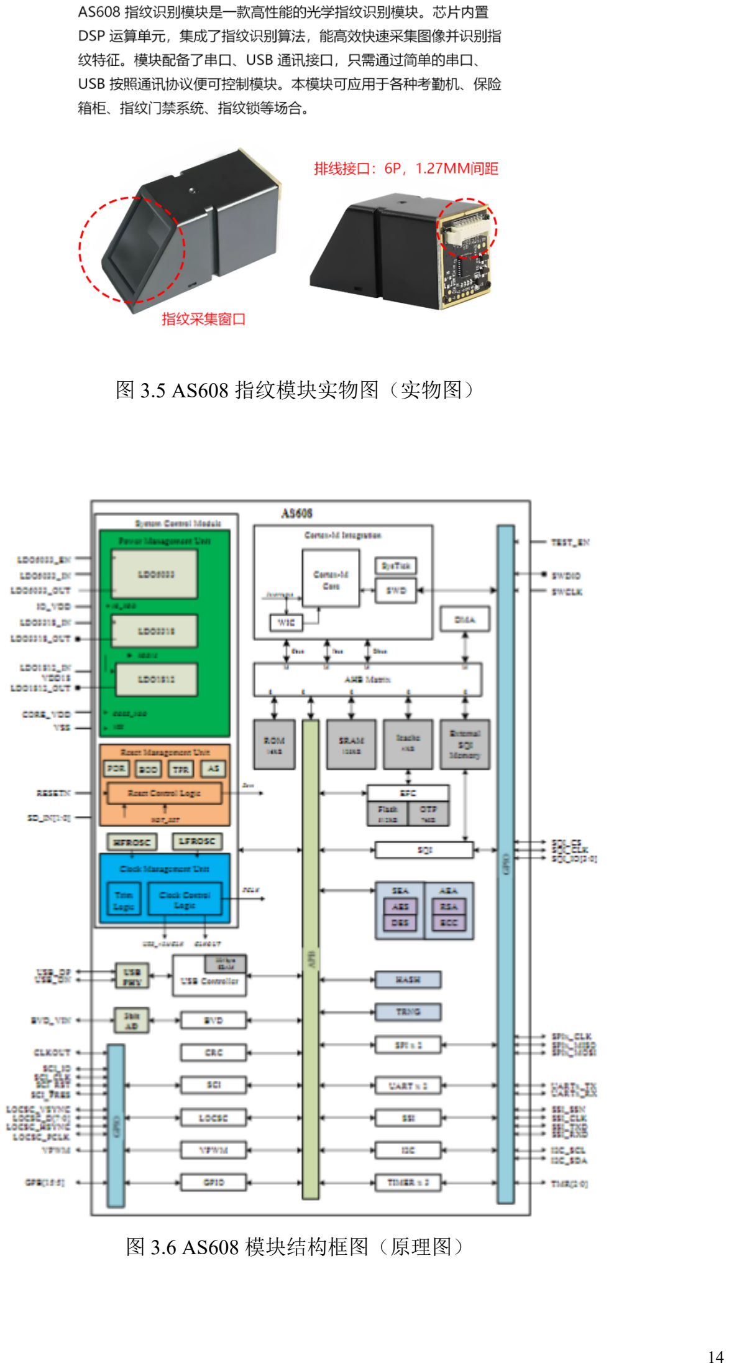
[picture p51: page 22]

图 3.5 AS608 指纹模块实物图（实物图）

图 3.6 AS608 模块结构框图（原理图）

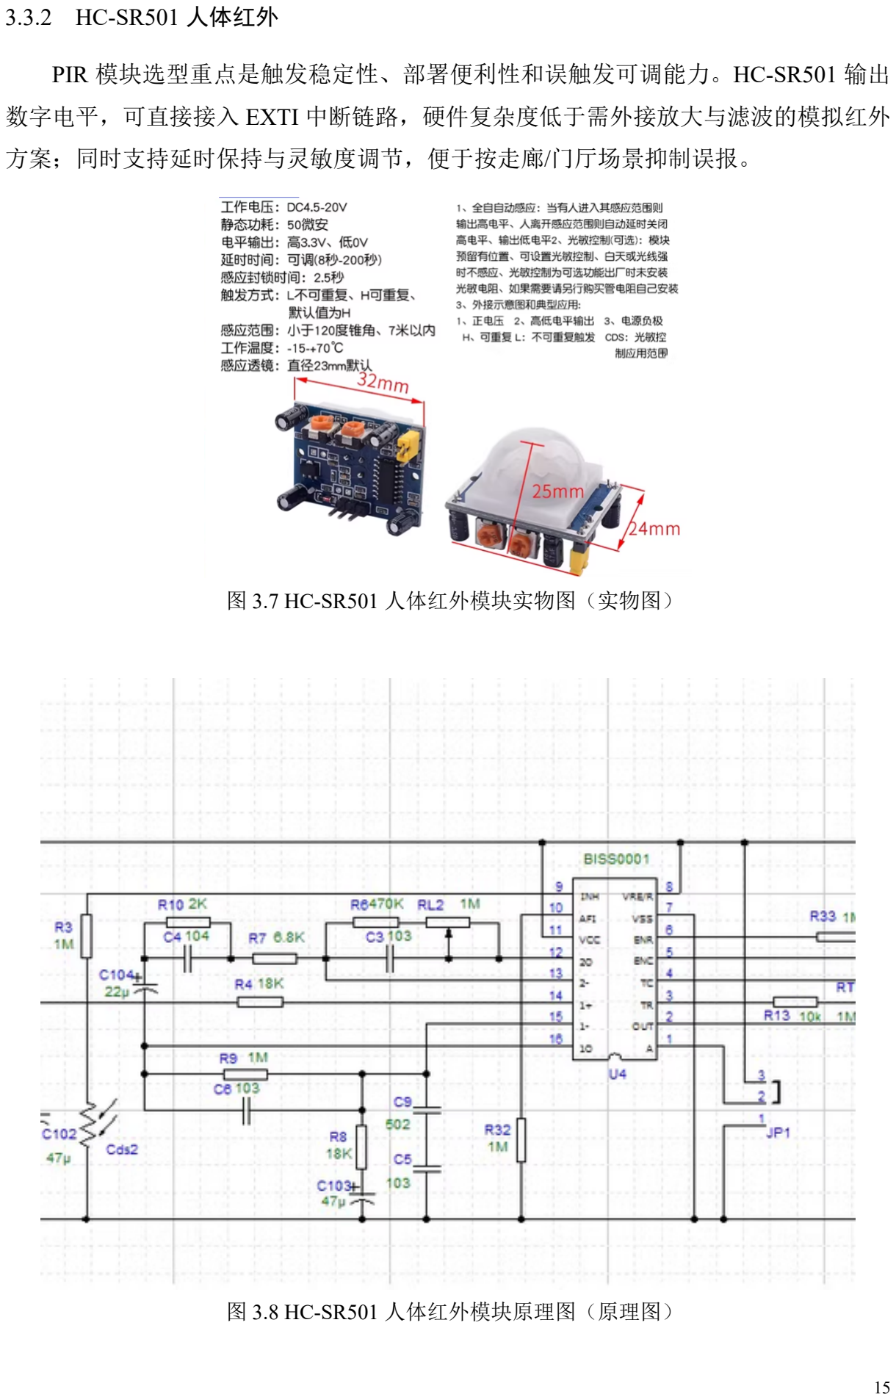
[picture p52: page 23]

3.3.2 HC-SR501 人体红外

PIR 模块选型重点是触发稳定性、部署便利性和误触发可调能力。HC-SR501 输出

数字电平，可直接接入 EXTI 中断链路，硬件复杂度低于需外接放大与滤波的模拟红外

方案；同时支持延时保持与灵敏度调节，便于按走廊/门厅场景抑制误报。

图 3.7 HC-SR501 人体红外模块实物图（实物图）

图 3.8 HC-SR501 人体红外模块原理图（原理图）

3.3.3 DHT11/22 温湿度

温湿度模块选型重点是精度、时序实现成本与维护可替换性。DHT22 相较 DHT11

具备更高测量精度和更宽量程，因此默认采用 DHT22；同时保留 DHT11 兼容接口以降

低器件替换成本。单总线数字输出减少了模拟调理电路需求，符合毕业设计阶段的可实

现性约束[24]。


图 3.9 DHT11 温湿度模块实物图（实物图）


图 3.10 DHT22 温湿度模块实物补充图（实物图）

温湿度传感器校准实验

为保证环境监测数据精度，本系统对 DHT22 温湿度传感器进行实验室校准。校准

在恒温恒湿箱中完成，环境稳定 30 min 后记录数据，参考仪表选用 Rotronic HC2-S（精

度 ±0.1

◦C/ ± 0.8% RH）[27]。校准对照原始数据如表3.3所示。

表 3.3 DHT22 温湿度校准对照原始数据

序号 | 标准温度 ( ◦C) | DHT22 读 数 ( ◦C) | 温度误差 ( ◦C) | 标准湿度 (%RH) | DHT22 读 数 (%RH) | 湿度误差 (%RH)
1 | 20.0 | 20.2 | +0.2 | 40.0 | 41.1 | +1.1
2 | 25.0 | 25.1 | +0.1 | 50.0 | 51.5 | +1.5
3 | 25.0 | 25.0 | 0.0 | 60.0 | 61.3 | +1.3
4 | 25.0 | 25.2 | +0.2 | 70.0 | 71.8 | +1.8
5 | 30.0 | 30.3 | +0.3 | 50.0 | 51.6 | +1.6
6 | 35.0 | 35.4 | +0.4 | 60.0 | 61.9 | +1.9

由表3.3可见，DHT22 温度误差不超过 ±0.4

◦C，湿度误差不超过 ±2% RH，满足本

系统环境监测需求。后续通过第 4 章给出的线性补偿模型与滤波策略可进一步提升数据

一致性。

3.3.4 MQ-2 烟雾

MQ-2 模块用于可燃气体与烟雾异常检测，选型依据为可获得性高、响应快且支持

模拟量连续采样。与仅输出开关量的简化烟雾模块相比，MQ-2 可提供 ADC 趋势数据，

便于实现“阈值触发 + 变化率辅助判定”的双判据逻辑。


图 3.11 MQ-2 烟雾/可燃气体模块实物图（实物图）

在信号调理方面，MQ-2 输出经分压后接入 ADC1_IN8（PB0）。分压关系为

VADC = Vin ·

R2
R1 + R2

(3.2)

为保证 VADC ≤ 3.3 V，在传感器侧最高输出按 5 V 估算时取 R1 = 10 kΩ、R2 = 20 kΩ，则

VADC,max ≈ 3.33 V。工程实现中进一步通过 ADC 满量程校准和软件限幅避免过压采样。

模拟支路增加 RC 低通（典型 R = 1 kΩ，C = 0.1 µF）抑制高频噪声，其截止频率

fc =

1
2πRC
≈ 1.59 kHz | (3.3)

满足低速环境量采样需求。

气体传感器标定实验

MQ-2 烟雾/可燃气体传感器采用 STM32F103RCT6 内置 12 位 ADC 采集模拟量，系

统供电 5.0 V，负载电阻 RL = 10 kΩ，传感器预热 30 min 至稳定后进行标定[28]。标定点

原始数据如表3.4所示。

表 3.4 MQ-2 传感器标定点原始数据

等级 | 含义 | 参考浓度 (ppm) | MQ-2 输出 电压 (V) | STM32 ADC 读数
0 | 洁净空气 | 0 | 0.18∼0.25 | 145∼205
1 | 轻微油烟/泄 漏 | ∼300 | 0.45∼0.65 | 365∼530
2 | 明显烟雾/燃 气 | ∼1000 | 0.90∼1.30 | 735∼1060
3 | 高浓度告警 | ∼2000 | 1.60∼2.10 | 1310∼1720
4 | 危险浓度 | ≥3000 | ≥2.40 | ≥1960

ADC 值到传感器输出电压的转换公式为

VAO =

ADC
4095
× 5.0 | (3.4)

传感器等效电阻计算公式为

RS = RL ×

VCC − VAO

VAO

(3.5)

其中 RL = 10 kΩ，VCC = 5.0 V。通过标定可建立 ADC 读数与气体浓度等级映射关系，

实现家用场景下烟雾/可燃气体分级检测与告警。

3.3.5 OV7670 摄像头 +FIFO

图像采集链路选型重点是接口匹配性、带宽压力和抓拍确定性。OV7670 本体数据吞

吐较高，若直接由 MCU 实时搬运将显著占用总线与 CPU 时间；因此采用 OV7670+FIFO

方案，通过硬件缓存解耦采集与读取时序，保障告警任务优先执行[26]。

3.4 执行层驱动设计

执行层负责将控制策略转化为物理动作，实现“检测-控制-反馈”闭环。执行单元

驱动设计强调三点：电气隔离、反灌防护和可重复动作可靠性。执行器驱动电路关系如

图3.12所示。


图 3.12 执行器驱动电路示意

3.4.1 继电器（门锁/燃气）

继电器驱动模块需满足低压控制高压负载、触点容量匹配和反向电动势抑制。项目

实现包含门锁继电器（PC6）与燃气阀继电器（PC7），照明联动位可复用 PC8。驱动电

路采用 NPN 三极管低端开关 + 续流二极管 + 可选光耦隔离。


图 3.13 继电器执行模块实物图（实物图）

以 5 V 继电器线圈电流 IC = 70 mA 为例，三极管强迫放大倍数取 βf = 10，则基极

电流

IB ≥

IC
βf
= 7 mA | (3.6)

在 GPIO 输出 3.3 V、VBE ≈ 0.7 V 条件下，基极电阻取

RB =

VGP IO − VBE
IB

≈

3.3 − 0.7
7 mA
≈ 371 Ω | (3.7)

工程上选用 390 Ω 标准阻值，兼顾饱和裕量与 GPIO 驱动能力。续流二极管选用

1N4148/1N4007 并联在线圈两端，抑制关断尖峰，降低对 MCU 地参考的冲击。

3.4.2 蜂鸣器报警

蜂鸣器模块需满足 3.3 V 兼容、声压可感知和节奏可编程要求。系统采用有源蜂鸣

器低电平触发方案，通过定时器调制鸣叫占空比，实现入侵、燃气和门禁异常的差异化

提示，避免单一长鸣导致用户判别困难。


图 3.14 蜂鸣器驱动原理图（原理图）


图 3.15 蜂鸣器模块实物图（实物图）

3.5 板内接口与串口通信设计

系统不采用主从板间串口协议，而是采用“板内多外设接口 + 外联串口通信”方

案。核心串口分工为：USART1 用于 AS608 及调试打印，USART3 用于 ESP8266 联网，

二者在软硬件上解耦，提升联调稳定性。串口与外设数据流向如图3.16所示。

图 3.16 串口与外设数据流向图

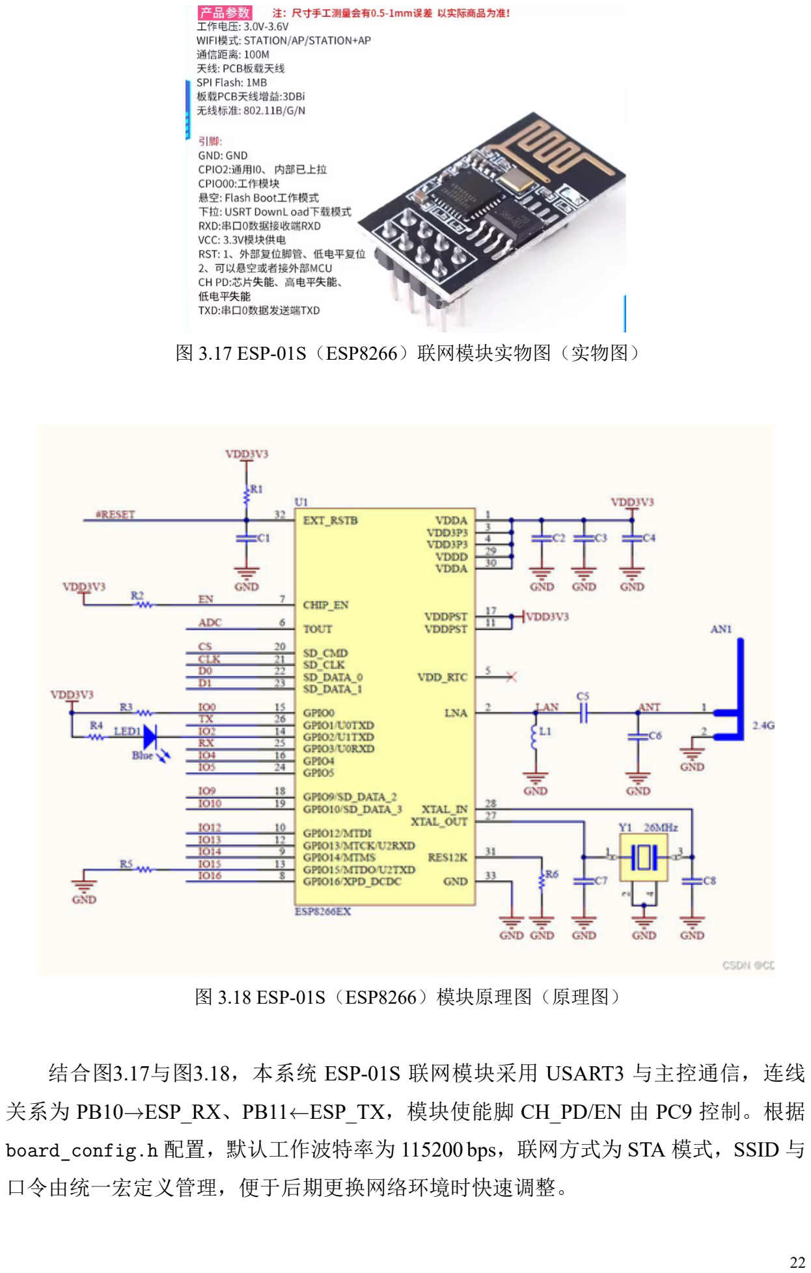
[picture p53: page 30]

图 3.17 ESP-01S（ESP8266）联网模块实物图（实物图）

图 3.18 ESP-01S（ESP8266）模块原理图（原理图）

结合图3.17与图3.18，本系统 ESP-01S 联网模块采用 USART3 与主控通信，连线

关系为 PB10→ESP_RX、PB11←ESP_TX，模块使能脚 CH_PD/EN 由 PC9 控制。根据

board_config.h 配置，默认工作波特率为 115200 bps，联网方式为 STA 模式，SSID 与

口令由统一宏定义管理，便于后期更换网络环境时快速调整。

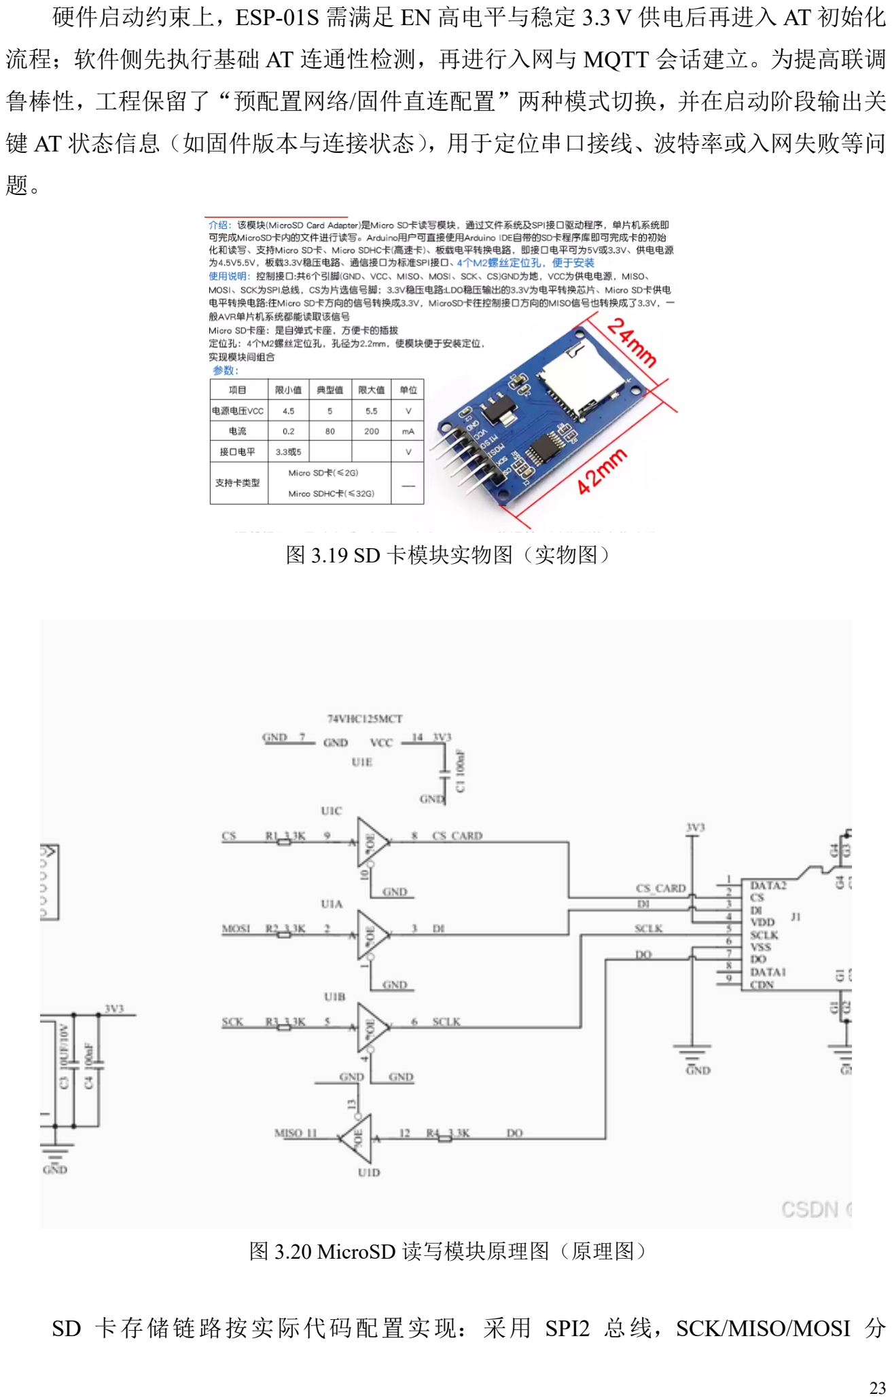
[picture p54: page 31]

硬件启动约束上，ESP-01S 需满足 EN 高电平与稳定 3.3 V 供电后再进入 AT 初始化

流程；软件侧先执行基础 AT 连通性检测，再进行入网与 MQTT 会话建立。为提高联调

鲁棒性，工程保留了“预配置网络/固件直连配置”两种模式切换，并在启动阶段输出关

键 AT 状态信息（如固件版本与连接状态），用于定位串口接线、波特率或入网失败等问

题。

图 3.19 SD 卡模块实物图（实物图）

图 3.20 MicroSD 读写模块原理图（原理图）

SD 卡存储链路按实际代码配置实现：采用 SPI2 总线，SCK/MISO/MOSI 分

别为 PB13/PB14/PB15，片选 CS 为 PB12（见 board_config.h） 。文件系统使用

FatFs，功能受 EN_FATFS_SD 编译开关控制：全功能模式默认为 1；调试模式下仅在

DEBUG_PASSWORD_ONLY=1 时保留 SD 功能。为提升差卡与长杜邦线场景兼容性，初始化

流程使用“上电稳定延时 +80 字节空时钟 +ACMD41 轮询重试”的保守参数，确保挂

载稳定后再进入抓拍 BMP 落盘与容量统计流程。

表 3.5 关键硬件接口分配与电气说明

功能模块 | MCU 引脚 | I/O 类型 | 电气特性 | 设计说明
AS608 指纹 | PA9/PA10
| (USART1) | UART | 3.3 V TTL，
| | | 57600 bps | 指纹采集、模板比对
| | | | 与串口调试复用
ESP8266 联 网 | PB10/PB11
| (USART3) | UART | 3.3 V TTL，
| | | 115200 bps | MQTT 上报与下行控
| | | | 制解耦
PIR 红外 | PC4 | EXTI | 数字输入，上
| | | 拉，边沿触发 | 入侵事件中断触发，
| | | | 降低轮询负担
DHT11/22 | PC5 | GPIO | 单总线，
| | | 4.7 kΩ 上拉 | 温湿度周期采样，时
| | | | 序软件校验
MQ-2 | PB0(ADC1_IN8)ADC | 0–3.3 V 输入，
| | | 12 位 ADC | 分压 +RC 滤波后采样
| | | | 气体变化趋势
SD 卡（SPI2）
PB13/PB14/PB15
| PB12(CS) | SPI | 3.3 V SPI，
| | | 512B 扇区 | FatFs 挂载、BMP 抓拍
| | | | 存储与容量统计
门锁/燃气阀 | PC6/PC7 | GPIO 输
| | 出 | 三极管驱动，
| | | 继电器隔离 | 本地执行链路，支持
| | | | 失网应急动作
蜂鸣器 | PC10 | GPIO/PWM 3.3 V 驱动，
| | | 限流保护 | 告警分级声提示与静
| | | | 音恢复

3.6 电源管理系统设计

本系统实际采用 DCP3512 四路电源模块作为集中供电单元，输入为 VIN 6–30 V，

板载电源开关控制总上电。模块提供四路输出：3.3 V、5 V、12 V 及一路可调输出（约

0.9–29.7 V），其中 3.3 V 为 STM32 与数字传感链路供电，5 V 为部分外设与通信模块供

电，12 V 用于门锁/阀体等执行器支路，可调路用于实验阶段外设兼容与电压验证。

为减少执行器负载变化对采样精度影响，电源分配采用“数字/模拟/执行器分支”

布线策略：ADC 相关传感器优先接入 3.3 V 低噪声分支，继电器与门锁等冲击负载独立

走线并就近回流，降低公共回路压降耦合。关键采样点维持“0.1 µF+1 µF”局部去耦，

执行器电源端增设 47 µF 储能电容以抑制瞬态跌落。

工程调试中通过逐路上电与分支电压复核（3.3 V/5 V/12 V）确认模块输出稳定，再

进行整机联调；当可调路参与实验供电时，先空载设定目标电压再接入负载，避免误调

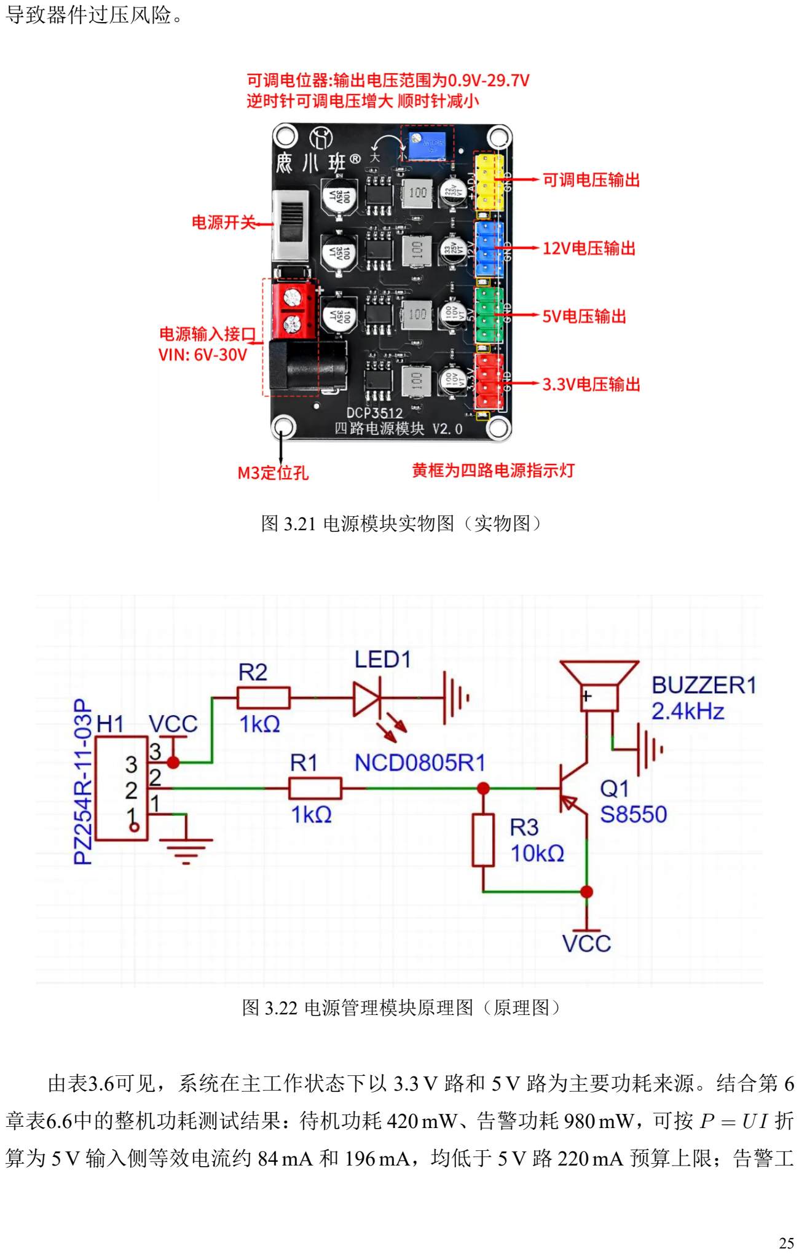
[picture p55: page 33]

导致器件过压风险。

图 3.21 电源模块实物图（实物图）

图 3.22 电源管理模块原理图（原理图）

由表3.6可见，系统在主工作状态下以 3.3 V 路和 5 V 路为主要功耗来源。结合第 6

章表6.6中的整机功耗测试结果：待机功耗 420 mW、告警功耗 980 mW，可按 P = UI 折

算为 5 V 输入侧等效电流约 84 mA 和 196 mA，均低于 5 V 路 220 mA 预算上限；告警工

表 3.6 电源分配与最大电流预算表

电源路 | 主要负载 | 典型电流
(mA)

最大预算
(mA)

备注

3.3 V 路 STM32F103、
DHT22、MQ-2 采样
侧、AS608 逻辑接
口
95 | 180 | 数字与采样主
供电
5 V 路 | ESP8266 模块、PIR
模块、部分外围接
口
60 | 220 | 联网与外设供 电
12 V 路 | 门锁执行器、燃气
阀驱动支路（继电
器控制）
0（待机） /120（动作） | 450 | 瞬态冲击按动 作峰值预留

可调路
（0.9–
29.7 V）

实验阶段外设兼容
验证与临时负载
0–40 | 150 | 正式运行默认 不带载

况下 12 V 支路短时动作电流叠加后仍在整体预算范围内，说明电源分配与功耗测试数

据一致，满足工程冗余要求。

3.7 硬件调试

硬件调试按照“问题发现-定位分析-方案修复-复测验证-稳定确认”的闭环流程推

进。调试阶段先完成电源与时钟基线检查，再开展接口分项联调，最后进行系统级联动

验证。

为体现嵌入式工程调试能力，本文整理了与本系统模块完全匹配的典型调试闭环案

例（问题现象 → 排查过程 → 解决方法 → 验证结果），用于说明硬件调试的可复现路径

与工程落地细节。

典型调试闭环案例

1、案例 A：继电器动作引起 MQ-2 采样抖动偏大

(1) 问题现象：继电器吸合/释放瞬间，MQ-2 ADC 采样出现尖峰跳变，导致短时误

触发风险上升。

(2) 排查过程：示波器分别观测 3.3 V 数字电源与 ADC 参考点波形，并对继电器线

圈两端关断瞬态进行抓波，发现尖峰与采样异常同步；同时排查接地回流路径，确认执

行器回流与模拟采样地存在耦合。

(3) 解决方法：对 MQ-2 采样支路增加 RC 低通（与第 3 章信号调理一致），执行器与

模拟采样进行电源分区与单点汇接；继电器线圈增加续流二极管并优化布线回流路径。

(4) 验证结果：复测中 ADC 尖峰明显收敛，阈值判定稳定性提升；系统级联动测试

未出现由继电器动作引起的误报样本（与第 6 章误报率统计结论一致）。

2、案例 B：DHT11/22 单总线采样偶发超时

(1) 问题现象：温湿度采样在部分时刻返回超时或校验失败，导致状态上报中断。
(2) 排查过程：使用逻辑分析仪抓取单总线时序，检查起始信号宽度、应答窗口与

数据位脉宽；对比不同任务负载下的采样时序，发现高负载时中断/任务切换造成微小

抖动。

(3) 解决方法：将 DHT 采样放入固定周期任务并在采样临界段短暂屏蔽高频中断

（控制窗口在微秒级）；增加一次重试与 CRC 校验失败回退策略；硬件侧保持 4.7 kΩ 上

拉并缩短走线。

(4) 验证结果：连续采样稳定性恢复，单元测试中 DHT 读取成功率达到 100%（见

表6.3）。

3、案例 C：PIR（HC-SR501）偶发误触发

(1) 问题现象：布防状态下出现“无人经过但触发”的偶发告警候选事件。
(2) 排查过程：检查 PIR 输出波形，发现存在窄脉冲毛刺；同时复核安装高度、朝

向与电源噪声；对触发日志进行时间关联，定位部分样本与电源瞬态/强光干扰相关。

(3) 解决方法：硬件侧保证输入上拉与地参考稳定；软件侧引入最小持续时间门限

Tmin 与锁定窗口 Tlock（见第 4 章相关描述），并采用“PIR 触发 + 抓拍复核”联合判定，

避免毛刺直接升级告警。

(4) 验证结果：系统级测试入侵误报率维持在 3.2%（表6.6），满足 ≤ 5.0% 目标。

4、案例 D：ESP8266 重连阶段串口丢帧/粘包

(1) 问题现象：网络波动后重连期间，云端命令偶发解析失败或执行回执丢失。
(2) 排查过程：抓取 USART3 收发日志与 AT 返回信息，发现重连阶段返回报文密

集且存在分片；同时检查串口接收缓存，定位为接收溢出与帧边界丢失导致解析失败。

(3) 解决方法：统一波特率与串口配置；接收侧采用 DMA/环形缓冲（或等价的软件

环形缓冲）并按行/关键字分帧；解析层加入超时与重试、命令幂等去重与回执确认机

制。

(4) 验证结果：远程控制成功率维持在高水平（见第 6 章联动测试），弱网样本主要

表现为时延增加而非逻辑失效。

5、案例 E：执行器驱动“吸合但 MCU 复位”

(1) 问题现象：在蜂鸣器/继电器高频动作时，偶发出现 MCU 复位或程序跑飞。
(2) 排查过程：示波器观测 3.3 V 电源跌落与地弹噪声，发现执行器动作导致瞬态压

降；检查去耦电容与供电走线，确认局部储能不足与回流干扰。

(3) 解决方法：在执行器电源端增加储能电容并优化去耦布局；执行器动作节奏改

为“分段驱动 + 限频”，避免瞬态叠加；软件侧引入看门狗与异常复位恢复机制（第 4

章给出）。

(4) 验证结果：连续运行测试未再出现异常复位，72 h 稳定性测试通过（表6.8）。

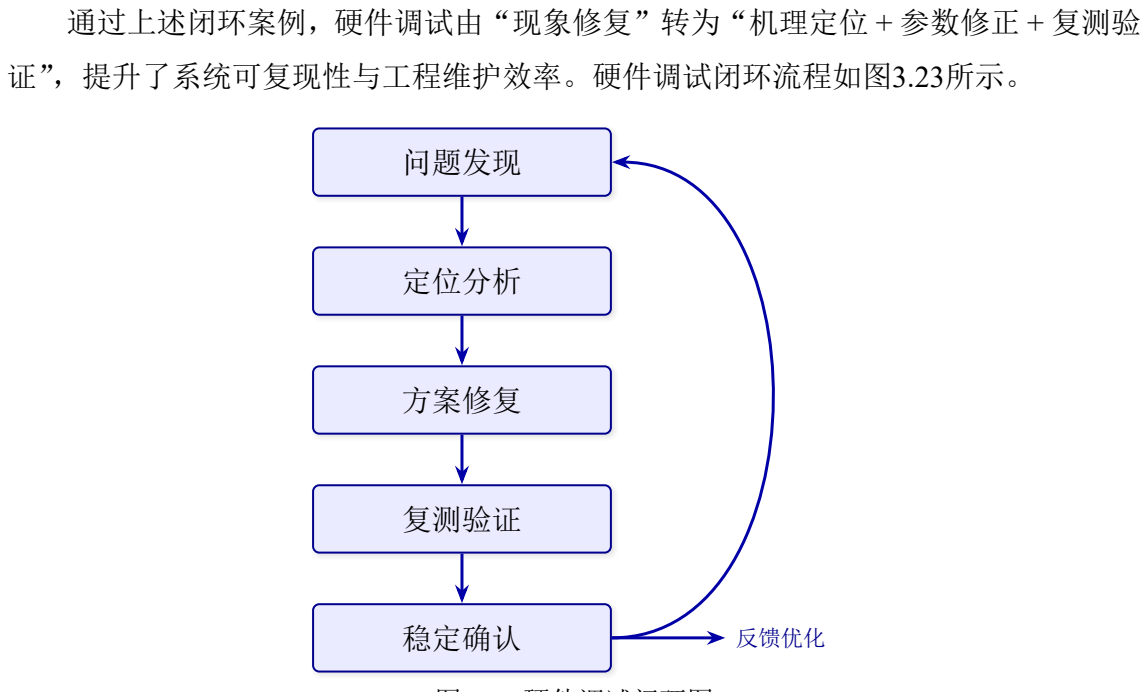
[picture p56: figure]
通过上述闭环案例，硬件调试由“现象修复”转为“机理定位 + 参数修正 + 复测验; 证”，提升了系统可复现性与工程维护效率。硬件调试闭环流程如图3.23所示。; 问题发现; 定位分析; 方案修复; 复测验证; 稳定确认; 反馈优化

图 3.23 硬件调试闭环图

系统实物搭建结果如图3.24所示。


图 3.24 系统实物图

3.8 本章小结

本章围绕主控最小系统、传感信号调理、执行驱动与隔离、电源管理、接口分配和

调试闭环完成了硬件系统化设计。通过参数计算、器件选型对比和抗干扰细节落实，方

案在实时性、可靠性和可维护性之间实现了工程平衡。硬件实现结果表明，单板集中架

构能够支撑多外设并发接入并满足后续软件调度与联动控制需求，为第 4 章软件实现和

第 6 章测试验证提供了稳定硬件基础。

## 4 系统软件设计

4.1 软件开发环境

根据嵌入式软件实现要求，开发环境应满足“可稳定编译下载、可在线调试、可快

速定位外设问题、可支持多模块协同开发”等条件。项目实际采用 Keil MDK + STM32

标准外设库构建固件；系统可在裸机与 FreeRTOS 两种模式间切换，便于分阶段调试；联

调阶段结合串口调试助手与日志命令提升问题定位效率。远程侧采用 ESP8266+OneNET

MQTT 链路，形成“嵌入式端-云平台-移动端”的通信链路。

表 4.1 软件开发环境与版本

软件/平台 | 版本 | 用途
Keil MDK | 5.x | 单芯片固件开发与调试
STM32 固件库 | 标准库/HAL | 外设驱动接口支持
FreeRTOS | V9.x | 全功能模式多任务调度
OneNET MQTT | 3.1.1 协议 | 云端消息中间件服务
串口调试工具 | 任意串口助手 JSON 状态监控与命令调试

4.2 软件架构

软件架构采用“驱动层-服务层-业务层-应用交互层”分层组织，并支持裸机调试与

FreeRTOS 运行两种模式。裸机模式用于单外设联调与时序验证；FreeRTOS 模式用于多

任务并发运行和完整业务闭环。分层后，底层驱动仅提供统一硬件抽象接口，业务逻辑

通过消息与事件驱动服务层，从而降低模块耦合并提升可维护性[15-16]。软件架构与任务

关系如图4.1所示。


图 4.1 软件架构与任务关系图

表 4.2 FreeRTOS 任务划分与资源配置

任务名称 | 优先级 值 | 堆栈 （word） | 周期/触发 | 主要职责
安防告警任务 | 5 | 512 | 周期 + 事 件 | 安防报警与应急处理 （硬实时）
网络通信任务 | 4 | 640 | 100 ms 周 期 | ESP8266 维护、MQTT 解析与重连
指纹识别任务 | 3 | 512 | 50 ms 周期 | 指纹识别、权限判定 与重试管理
传感采集任务 | 3 | 384 | 200 ms 周 期 | DHT、PIR、MQ-2 采 样与滤波
图像抓拍任务 | 2 | 768 | 事件触发 | 抓拍队列消费与 SD 写 BMP
系统监测任务 | 1 | 320 | 2 s 周期 | JSON 状态上报与资源 监测

堆栈分配依据采用“静态估算 + 高水位校核”方法：先按任务局部变量、调用深度和通

信缓冲区估算初值，再通过 uxTaskGetStackHighWaterMark() 在线观测，保证最小剩

余栈空间大于 20%。

4.2.1 任务堆栈大小的估算依据

以 Cortex-M3 为例，任务堆栈需求可近似拆分为“上下文保存 + 函数调用深度 + 局

部变量与缓冲区 + 安全裕量”。工程上采用下式给出初始估算：

Sword ≥

Sctx + Scall + Slocal + Sbuf
4
- (1 + η) | (4.1)

其中 Sctx 为任务切换上下文开销字节数，Scall 为最大调用深度对应的栈帧开销，Slocal 与

Sbuf 分别为局部变量和通信缓冲区开销，η 为裕量系数（工程建议 η ≥ 0.2）。初值配置

后通过高水位统计进行校核并迭代收敛，避免“堆栈过小导致 HardFault”与“过大挤占

RAM”两类问题。

4.2.2 任务间通信与同步机制

系统任务通信采用“队列 + 事件组 + 互斥锁”的组合机制：

1、队列（Queue）：用于跨任务传递传感采样帧和告警事件，典型队列深度为 8，消息结

构体固定长度，避免堆碎片；

2、事件组（EventGroup）：用于布防状态变化、网络在线状态、抓拍触发等位标志同步；

3、二值信号量（Binary Semaphore）：用于中断到任务的快速唤醒，如 PIR 触发后唤醒

安防告警任务；

4、互斥锁（Mutex）：用于共享资源保护，如串口发送缓存和日志文件写入，防止并发

写冲突。

硬实时任务响应保障采用三项措施：中断仅置位事件不做耗时处理；安防告警任务

优先级最高并禁止阻塞式长延时；网络与日志任务采用分片执行，避免抢占关键执行窗

口。

4.2.3 临界区保护与 ISR 安全接口

系统共享资源（如串口发送缓冲、日志文件、状态快照）采用“互斥锁优先、临界

区最小化”的保护策略：

1、互斥锁：跨任务访问共享资源优先使用 Mutex，避免长时间关中断；

2、临界区：仅在更新少量共享标志或环形缓冲指针时使用 taskENTER_CRITICAL()/taskEXIT_CRITICAL()，

并严格控制临界区长度；

3、ISR 到任务：中断中使用 xSemaphoreGiveFromISR/xQueueSendFromISR 等 ISR 安全

API，并在需要时触发上下文切换，保证硬实时链路及时唤醒。该策略与本论文“中断

只做快判定、复杂处理下沉任务”的原则一致，可在保证实时性的同时降低死锁与优先

级反转风险。

4.3 裸机轮询与中断路径

在裸机模式配置启用时，系统不启动调度器，而由主循环执行键盘、指纹、安防与

串口控制等逻辑，中断用于 PIR 等快速触发事件。该路径降低了系统复杂度，适合硬件

联调与故障定位；在需要完整联网与并发功能时再切换至 FreeRTOS 模式。

4.4 底层驱动开发

底层驱动开发围绕几个工程目标展开：接口统一、时序可控、异常可恢复、模块

可复用。为减少业务层和硬件实现之间的耦合，驱动层统一采用“初始化-数据收发-

状态查询-异常处理”这一接口范式，覆盖 GPIO、UART、I2C/单总线、定时器和外部

中断等模块。按这个方式组织后，即使后续更换器件或升级模块，上层控制逻辑通常

也不需要大改，兼容性更稳。其中 SD 驱动按 board_config.h 实施为 SPI2 专用通道

（PB13/PB14/PB15+PB12 片选），并将初始化过程显式分为“上电稳定等待 → 发送 80 字

节空时钟 →CMD/ACMD 握手 →FatFs 挂载”四步。针对低质量卡或线缆寄生影响，驱

动中保留较宽松的命令等待和 ACMD41 重试参数（如 200 ms 命令等待窗口、600 次轮

询上限），优先保证挂载成功率；仅在挂载成功后开放抓拍文件写入与容量查询接口，避

免业务层在未就绪状态下访问存储造成异常。

4.5 核心控制逻辑

核心控制逻辑围绕门禁、安防、环境与场景四类业务展开，通过有限状态机（FSM）

与规则引擎实现事件判定和动作调度。系统支持本地自治闭环优先与远程协同增强策

略，在网络不稳定场景下仍保障基础安全功能。门禁与安防核心状态机如图4.2所示。


图 4.2 门禁与安防核心状态机

4.5.1 门禁验证逻辑

门禁状态机定义为 IDLE、ACQUIRE、MATCH、OPEN、LOCKOUT 五个状态。状态转移

条件如下：

1、IDLE→ACQUIRE：检测到触摸/按键触发；

2、ACQUIRE→MATCH：采集成功且质量分大于阈值；

3、MATCH→OPEN：模板匹配成功；

4、MATCH→LOCKOUT：连续失败次数 ≥ Nf（本系统取 Nf = 3）；

5、LOCKOUT→IDLE：锁定计时到期或管理员复位。边界异常处理包括：串口超时重试

（最多 2 次）、模板库访问异常回退到 IDLE 并写错误日志、门锁执行反馈超时触发二次

驱动并上报故障。

4.5.2 安防报警逻辑

安防状态机定义为 DISARMED、ARMED、TRIGGERED、ALARMING、RECOVERY。其中：

1、ARMED→TRIGGERED：PIR 触发并通过最小持续时间门限；

2、TRIGGERED→ALARMING：图像抓拍任务返回有效帧或超时兜底；

3、ALARMING→RECOVERY：用户确认解除或风险消失持续 Tclr。异常边界策略：若抓拍失

败不阻塞本地告警；若云端不可达则保留本地蜂鸣 + 日志；若执行器反馈异常则进入降

级模式并限制高风险动作。

4.5.3 环境监测与联动

系统周期采集温湿度与气体数据，采用“校准补偿 + 数字滤波 + 趋势判定 + 阈值触

发”联合策略。该策略的设计目标是：在家庭环境存在温湿波动、油烟干扰与电磁噪声

的条件下，仍能稳定输出可用于联动控制的测量值，并将误触发控制在第 6 章给出的指

标范围内。

DHT11/22 温湿度校准实验设计与线性拟合补偿

温湿度数据用于环境状态展示与联动阈值判定，因此需要进行现场一致性校准以降

低器件离散性。本文采用“参考仪表对比 + 线性拟合”的校准方法：在不同温湿点（建

议不少于 5 组点位）下同步采集参考仪表读数 (Tref, Href) 与 DHT 读数 (Traw, Hraw)，并在

剔除明显离群样本后对误差进行线性建模：

Tcal = aT Traw + bT , | Hcal = aHHraw + bH | (4.2)

其中，aT , bT , aH, bH 由最小二乘法拟合得到。考虑 STM32 资源约束，运行时仅执行一

次乘加运算；校准系数固化在配置区并支持串口/云端更新，从而保证可复现与可维护。

校准效果评价采用平均绝对误差（MAE）与最大误差（MaxE）：

MAE =

1
N

∑
N

i=1

|xi − xref,i|, MaxE = max
i
|xi − xref,i| | (4.3)

本系统测试阶段的温湿度数据一致性满足第 6 章对“状态展示与联动稳定性”的要求；

校准前后对比的采样与统计口径与第 6 章数据处理流程一致（固定版本、固定参数、重

复试验不少于 30 次）。

MQ-2 标定、ADC 到浓度转换模型与温漂补偿

MQ-2 输出为与气体浓度相关的模拟量，本系统以 ADC 采样值 Ak 作为原始观测

量。结合本科工程实现难度与家庭场景需求，本文采用“两阶段标定”策略：

1、阈值标定：在安全环境下采集稳定基线 Abase，在模拟超限场景下采集 Aalarm，据此确

定阈值 Tgas 与变化率阈值 ∆T；

2、可选浓度换算：在具备标准气源或半定量参考仪表条件时，建立 ADC 与浓度的工程

映射模型，用于更直观的浓度展示与跨环境对比。

在可选浓度换算中，为兼顾可实现性与拟合效果，采用分段线性模型：

C =

k1(A − Abase), | Abase ≤ A < A1

k2(A − A1) + C1, A1 ≤ A < A2

k3(A − A2) + C2, A ≥ A2

(4.4)

其中 ki 由标定点拟合得到，A1, A2 为分段拐点。温漂补偿采用“温湿修正 + 基线跟踪”

组合：一方面对阈值作小幅修正 Tgas(T, H)；另一方面在无报警事件且变化率较小的窗

口内对基线缓慢更新：

Abase(k) = λAbase(k − 1) + (1 − λ)A¯
k, | 0 < λ < 1 | (4.5)

该策略用于抑制预热漂移与长期老化导致的阈值失配，提升长期稳定性（与第 6 章 72 h

稳定性测试结论一致）。

中值滤波/滑动平均滤波实现逻辑与降噪机理

为抑制继电器动作、电源纹波和瞬态干扰引起的尖峰噪声，MQ-2 通道采用“中值

滤波 + 滑动平均”级联结构：先用中值滤波剔除脉冲异常，再用滑动平均降低随机噪声。

中值滤波窗口为 2r + 1：

A˜
k = median{Ak−r, . . . , Ak+r} | | (4.6)

滑动平均为

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
k−i | (4.7)

再计算变化率 ∆Ak = A¯

k − A¯

k−1。当 A¯
k > Tgas 且 ∆Ak > ∆T 时判定为高风险事件。该

实现逻辑与第 6 章“MQ-2 气体检测成功率 94.0%”的单元测试结果一致，滤波与基线

补偿用于降低误触发并提升阈值判定稳定性。

4.5.4 场景联动逻辑

场景联动支持“居家”“离家布防”“夜间安防”等预设模式，并允许通过移动端进

行参数配置。联动逻辑采用条件触发与动作链执行机制，实现设备间自动协同，提高系

统智能化程度。

4.5.5 HC-SR501 距离校准、误触发抑制与联合判定

HC-SR501 作为入侵触发源，其误触发会直接影响系统误报率指标。本文采用“距

离-视场校准 + 软件防抖 + 多条件联合判定”三步抑制误报：

1、距离校准：在走廊/门厅场景设置 1 m、3 m、5 m 等点位，分别统计触发率，确定灵

敏度电位器的工程配置区间，并记录最佳安装高度与朝向；

2、软件防抖：对 PIR 输入采用最小持续时间门限 Tmin 与锁定窗口 Tlock。当高电平持续

时间小于 Tmin 判为毛刺丢弃；触发成立后在 Tlock 内忽略重复触发，避免抖动造成重复

上报；

3、联合判定：在布防状态下，PIR 触发仅作为“候选事件”，需满足附加条件（例如二

次触发、图像抓拍返回有效帧、或在短时间窗内的复核信号）才升级为入侵告警。该策

略与第 6 章入侵检测误报率 3.2% 结果对应，即通过“PIR 触发 + 复核”机制将短时干

扰从告警链路中剔除。

4.5.6 多传感器融合的安防事件判定算法

为进一步降低误报并提升鲁棒性，本文采用基于证据加权的事件融合判定。设在时

间窗 W 内，PIR 触发证据为 epir ∈ {0, 1}，图像有效帧证据为 ecam ∈ {0, 1}，门禁异常

证据为 eacc ∈ {0, 1}，环境异常证据为 eenv ∈ {0, 1}。定义融合评分：

S = wpirepir + wcamecam + wacceacc + wenveenv,

∑wi = 1 | (4.8)

当 S ≥ θ 时判定为高可信事件并进入告警状态；当 S < θ 时仅记录日志并保持监测。权

重分配遵循“可置信证据优先”原则：摄像头有效帧与门禁异常的权重高于单次 PIR 触

发；环境异常与入侵告警分属不同风险域，通常不直接互相触发，仅用于提升整体风险

等级。工程实现中，该融合策略对应事件组与队列：PIR 中断置位 epir 并唤醒安防任务，

抓拍任务回传 ecam，门禁任务更新 eacc，环境任务更新 eenv，最终由安防任务在窗口 W

内完成融合判定。融合效果的量化证明以系统级实测指标为准：第 6 章给出的入侵检测

误报率 3.2% 即为融合与复核策略综合作用下的结果，满足 ≤ 5.0% 目标。系统功能流

程如图4.3所示。

4.6 串口与 MQTT 数据协议设计

根据项目实现，通信链路主要包括两类：其一是本地串口 JSON 状态输出与命令前

缀日志指令；其二是 ESP8266 对接 OneNET 的 MQTT 主题消息。协议设计强调可读性、

低开销与可调试性，便于在实验阶段快速验证状态流与控制流。设备与云端通信时序如

图4.4所示。

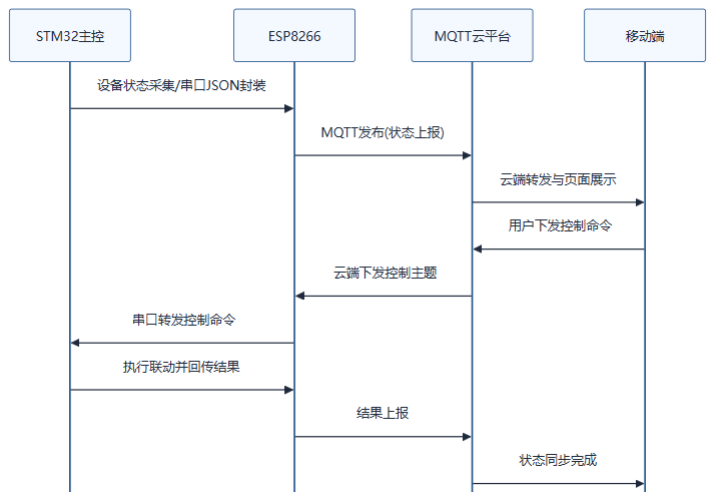
[picture p57: figure]

图 4.4 设备与云端通信时序

4.6.1 帧格式

通信帧由帧头、命令字、长度、数据域与校验字段构成。帧头用于同步识别，长度

字段用于动态解析数据域，校验字段用于检错，提高数据传输可靠性。


图 4.3 系统功能流程

表 4.3 本地串口 JSON 字段定义

字段名 | 类型 | 典型值 | 说明
temp | float | 25.0 | 温度（DHT）
humi | float | 60.0 | 湿度（DHT）
gas | int | 1200 | MQ-2 ADC 值
door | string | closed/open | 门锁状态
arm | int | 0/1 | 撤防/布防状态
sd.status | string | mounted/
| | unmounted | SD 挂载状态

4.6.2 指令集

命令接口分为串口日志命令与云端控制命令。串口侧采用统一日志查询命令格式查

询历史记录；云端侧通过 MQTT 下发开锁、布撤防等控制指令，设备执行后回传状态。

表 4.4 通信命令接口

接口名称 | 典型指令 | 方向 | 功能说明
串口状态上报 | JSON 行文
| 本 | 设备 →PC | 周期输出设备状态
日志查询命令 | CMD:LOG=
| LAST,10 | PC→ 设备 | 查询历史日志
MQTT 属性上报 | OneNET 数
| 据点 | 设备 → 云端 | 上传温湿度/状态
MQTT 控制命令 | 开锁/布防指
| 令 | 云端 → 设备 | 远程控制执行

4.6.3 MQTT 主题与消息设计

为避免业务耦合，主题按“设备标识 + 业务域 + 方向”组织。典型主题如下：

1、/home/{devId}/telemetry：状态上报（温湿度、气体、门锁、布防）；

2、/home/{devId}/alarm：告警事件（入侵、燃气、门禁异常）；

3、/home/{devId}/cmd/down：控制下发（开锁、布防、抓拍）；

4、/home/{devId}/cmd/up：命令回执（执行结果、错误码）。控制命令包含 cmdId、ts、

nonce、payload、crc16 字段，设备端先验签与去重，再进入业务执行流程。

4.6.4 校验与容错

协议采用 CRC 校验、应答超时重发、幂等去重和异常回退机制处理误码与丢包问

题。串口侧采用 CRC16-Modbus 校验，MQTT 侧采用 cmdId+ts 实现幂等控制。系统对

非法帧、重复帧与超时帧设置容错策略，确保干扰环境下链路稳定。

表 4.5 通信容错策略

异常类型 | 判定条件 | 处理策略
校验失败 | Check 不一致 | 丢弃帧并计数
应答超时 | 超过 T_ack 未收 到 ACK | 最多重发 3 次
重复帧 | 序号重复（可 选） | 去重处理，避免重复执行
非法命令 | Cmd 不在指令 表 | 返回 ERR 并记录日志

4.7 关键时序设计

在资源受限单芯片平台中，系统性能往往受“时序组织方式”而非单一算法复杂度

主导。为降低模块并发带来的阻塞风险，本文在实现中将关键路径划分为“硬实时触

发链路”和“软实时服务链路”：前者覆盖入侵触发、门禁判定与燃气应急动作，强调

最短路径执行；后者覆盖状态上报、日志整理与远程同步，强调稳定吞吐与异常恢复。

该分层使系统在弱网或外设抖动条件下仍可优先保障安全动作。任务调度时序关系如

图4.5所示。

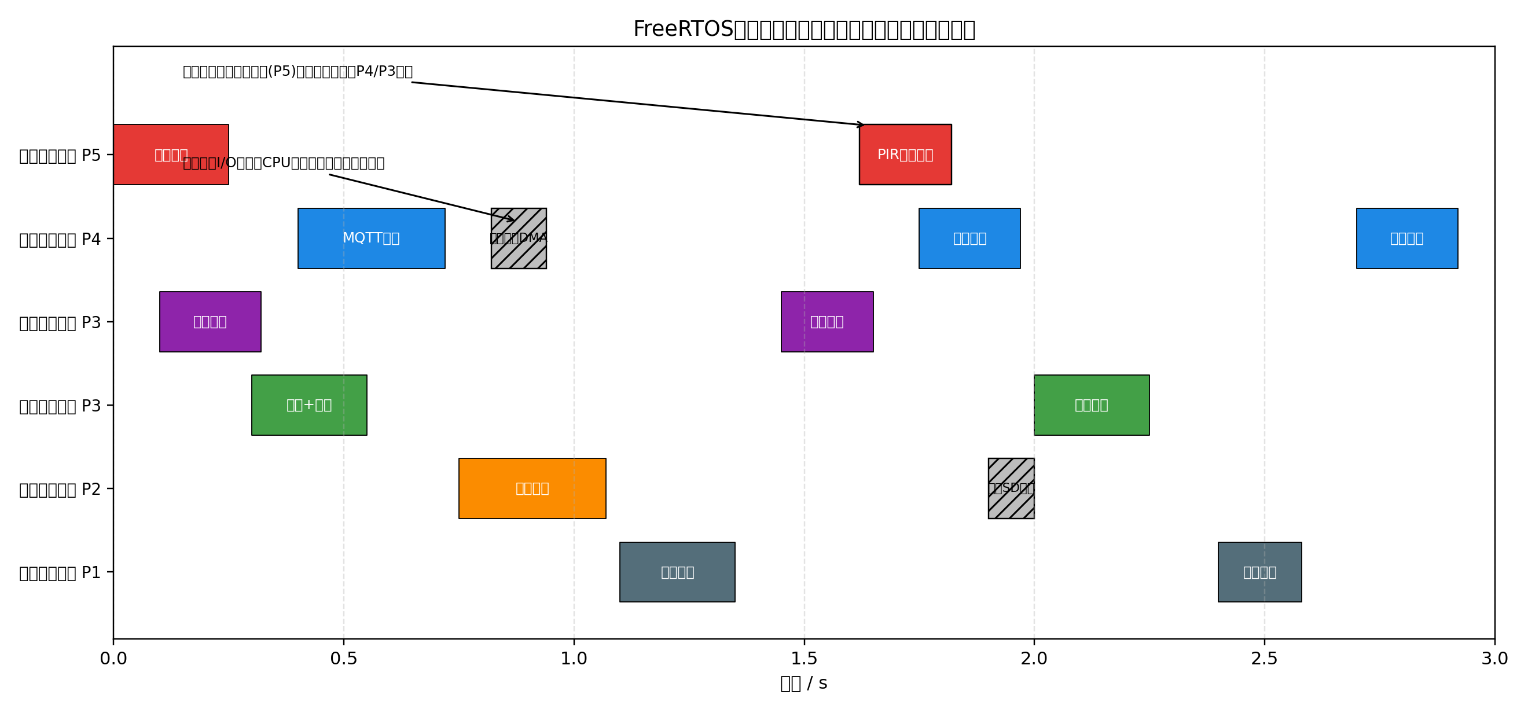
[picture p58: figure]

图 4.5 任务调度甘特图（含优先级抢占与阻塞点）

4.7.1 任务周期与优先级协同

FreeRTOS 模式下，各任务按“安全优先、通信次之、展示最后”的原则设置优先

级。安全任务使用较短周期并支持事件抢占，通信任务采用中等周期并配合重连机制，

状态展示任务则低频刷新。这样配置的目的，是避免高频但非关键任务长期占用调度窗

口，拖慢关键告警动作。测试中可见，多事件并发时低优先级任务会有轻微排队，但门

禁与应急控制链路仍在目标时延内完成，说明当前优先级配置和任务划分是有效的。

4.7.2 中断与轮询的边界设计

系统在中断与轮询协作上采用“中断只做快判定、复杂处理下沉任务”的工程策略。

具体而言，PIR 触发等突发事件在中断上下文中仅完成状态置位和时间戳记录，不执行

耗时逻辑；后续联动判断与动作控制由任务上下文完成。该设计可减少中断占用时间、

降低嵌套冲突概率，并提升系统整体可维护性。裸机模式下同样遵循这一原则，通过主

循环分段执行替代阻塞式串行处理，确保关键输入源不被长期饥饿。

4.7.3 缓冲区与数据一致性控制

针对串口、MQTT 与日志模块并行访问共享数据的问题，系统采用“快照上报 + 最

小临界区”方式降低数据竞争。状态上报前先复制关键字段形成只读快照，再交由通信

模块编码与发送；日志写入采用固定格式与长度约束，避免动态拼接造成堆栈压力。对

于网络重发场景，引入消息序号或时间标签用于去重判定，防止重复控制命令导致执行

器误动作。实践表明，该策略在不引入复杂锁机制的情况下即可兼顾一致性与实时性。

4.7.4 故障降级与恢复机制

考虑家庭网络波动与传感器偶发异常，系统实现了面向场景的降级机制：当云端链

路不可用时，自动降级为本地自治模式；当单个传感器数据异常时，维持其余链路继续

工作并记录异常日志；当执行器反馈超时或状态不一致时，触发重试与告警提示。该机

制的价值在于将“局部异常”限制在局部模块内，避免扩散为“全局失效”。从测试结

果看，降级与恢复路径均可被稳定触发，验证了系统在工程运行中的韧性设计。异常处

理与恢复流程如图4.6所示。

传感器离线检测与恢复

为避免“传感器异常 → 错误联动”，系统对关键传感器建立离线检测与恢复策略：

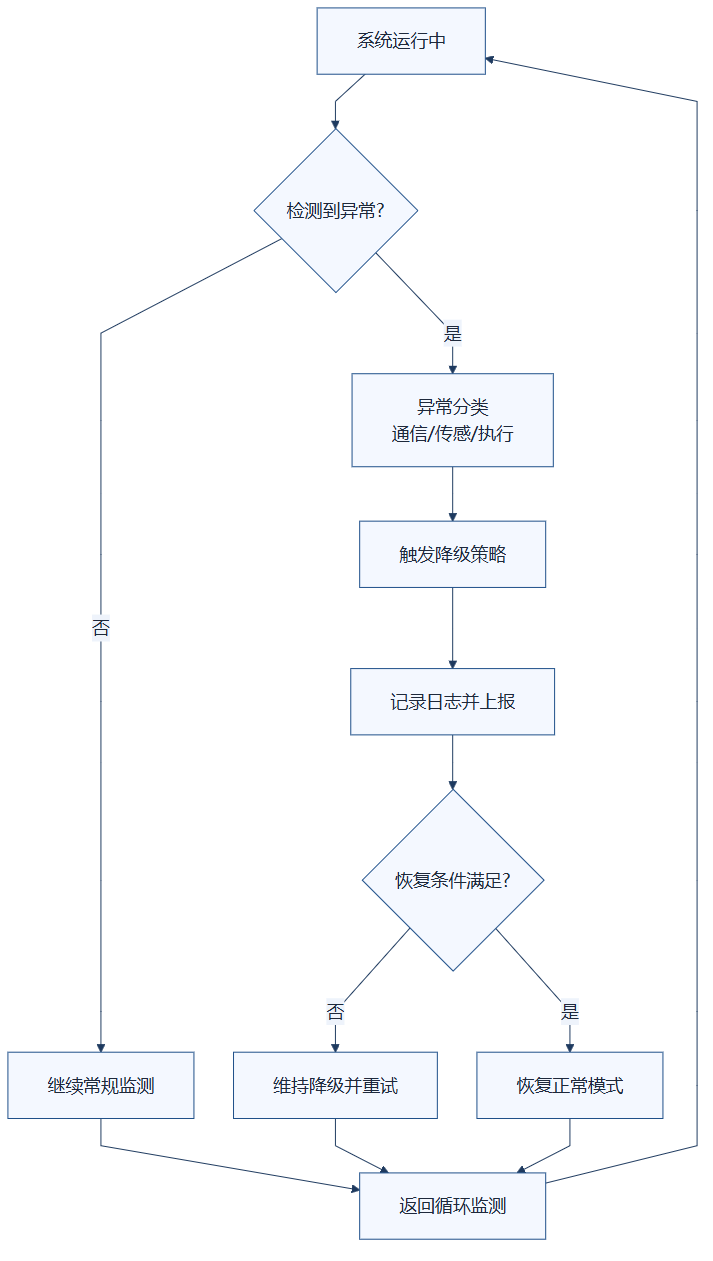
[picture p59: figure]

图 4.6 异常处理与恢复流程图

1、DHT11/22：若连续 Nto 次采样超时或校验失败，则置离线标志并冻结温湿度显示为

“无效”；进入离线后采用指数退避策略降低重试频率，避免占用 CPU；当连续 Nok 次采

样成功则自动恢复在线并清除离线标志。

2、MQ-2：若采样长期恒定（变化率低且持续时间超过门限）或超出 ADC 合理范围，则

判为异常；异常期间仅记录日志且禁止触发应急关阀动作，防止误联动；恢复条件为采

样恢复到合理区间并通过滤波稳定窗口。

3、PIR：若在非布防状态出现高频触发，则判为干扰；进入抑制窗口 Tsup 并记录环境干

扰日志，避免无意义上报。

ESP8266 断网自动重连与命令幂等

网络链路采用“状态机 + 分级重试”策略维护连接：

1、链路检测：周期发送心跳或 PING，连续失败计数达到阈值后标记离线；

2、重连流程：执行 WiFi Join→MQTT Connect→Subscribe→Sync State；

3、重试策略：采用指数退避（如 1 s、2 s、4 s…上限不超过 60 s）降低弱网拥塞；

4、幂等去重：对下行控制命令以 cmdId+ts 为键做去重，避免重连/重发造成执行器重

复动作；对执行结果上报采用回执确认，保证“下发-执行-确认”闭环。

看门狗喂狗与异常复位恢复

为提升长时间运行稳定性，系统引入独立看门狗（IWDG）作为最后保护：

1、喂狗策略：仅由“系统监测任务”统一喂狗，喂狗前检查关键任务心跳（各任务周期

性更新计数器或时间戳）；若任一关键任务超过阈值未更新，则禁止喂狗，触发看门狗

复位，实现“故障自愈”；

2、复位恢复：启动时读取复位源（上电复位/看门狗复位），若为看门狗复位则进入安全

模式：执行器置为安全态（关阀、门锁保持默认态、蜂鸣器关闭），并上报“异常复位”

日志；随后逐步恢复网络与业务任务，避免复位后立即进入同一故障循环；

3、异常捕获：对 HardFault 等不可恢复异常，记录最小化故障上下文（关键寄存器/错误

码）到日志区，为后续定位提供依据。

4.8 网络与安全机制

根据远程互联设计要求，网络通信方案需满足低带宽开销、断线可恢复、跨平台兼

容与安全可加固等条件。考虑家庭网络波动与公网传输风险，系统采用“应用层轻量协

议 + 传输层加密 + 本地敏感数据保护”的分层安全策略，在保证实时通信的同时降低数

据泄露与非法控制风险。

4.8.1 WiFi 与 MQTT

根据设备联网需求，通信链路应支持低功耗终端接入、主题化消息分发与弱网重连

机制。综合报文开销、实现复杂度与生态成熟度，本设计选用 ESP8266 作为 WiFi 接入

模块，并采用 MQTT 发布/订阅模型完成状态上报与控制下发，满足家庭场景下低带宽、

可扩展的远程通信要求[17-18,29]。

4.8.2 AES-128 加密存储

根据本地数据安全要求，系统采用 AES-128 对敏感信息进行分块加密存储[19]。实

现流程为：

1、密钥装载：设备启动时从受保护区域加载主密钥并派生会话密钥；

2、数据封装：按 16 字节分组并填充，附加版本号与时间戳；

3、分组加密：对配置参数、指纹索引和关键日志执行 AES-128-CBC 加密；

4、完整性校验：存储密文同时保存 HMAC/CRC 校验值；

5、解密恢复：读取时先校验完整性，再解密并回滚异常记录。密钥轮换采用“版本号 +

双密钥窗口”策略，保证升级阶段兼容旧数据。

4.8.3 TLS 传输加密

根据远程协同控制安全要求，传输链路需具备机密性、完整性与身份认证能力。系

统在 ESP8266 侧预留 TLS 初始化与证书校验路径，支持服务器证书校验、随机数握手

与会话复用[20-21]。在资源受限场景下，采用“控制指令优先加密、状态数据分级上报”

策略平衡安全与时延。

4.9 本章小结

本章从分层软件架构、FreeRTOS 任务资源配置、状态机控制逻辑、多传感器融合

算法、通信协议和安全机制六个方面给出了完整实现路径。通过“中断快响应 + 任务化

执行 + 分级容错”机制，系统在保证关键路径实时性的同时兼顾了联网能力与可维护

性；通过 AES-128 本地加密与 TLS 传输防护，提升了系统在存储与通信链路上的安全

性。上述设计与第 6 章量化测试指标形成了可复现、可验证的软件闭环。

## 5 移动端交互设计与实现

5.1 移动端需求分析

本系统采用基于 uni-app 开发的移动端页面作为主要交互入口，通过 OneNET 云

平台完成远程监测与控制。作为用户交互入口，移动端需具备状态可视化、设备可控制

和异常结果可查看三项核心能力，并支持抓拍图片的展示与回传信息的确认。

5.2 移动端总体架构

移动端交互采用“平台界面层 + 云端通信层 + 设备响应层”结构。平台界面负责状

态展示与命令下发，通信层维护云端会话与数据同步，设备侧按物模型解析命令并回传

状态[30]。

5.3 用户界面设计

界面设计围绕“首页总览-摄像头查看”展开。首页展示温湿度、燃气、门锁、布防

与灯控状态，并提供开锁、布防、抓拍等控制入口；摄像头页用于查看最新抓拍结果并

支持图片预览与链接复制。

如图5.1所示，首页主要用于展示系统运行状态和提供远程控制入口。页面采用卡

片式布局，便于在手机端集中呈现关键数据，同时也能够突出控制按钮的位置，方便用

户快速操作。


图 5.1 移动端首页界面

如图5.2所示，摄像头页面用于展示最新抓拍图片，并支持图片预览与链接复制。该

页面虽然结构相对简单，但在异常事件确认和现场查看中具有较强的实用性。


图 5.2 摄像头抓拍页面

5.4 通信模块

通信模块负责与 OneNET 服务器建立数据连接，完成设备状态查询与控制命令下

发。系统通过轮询方式读取设备当前属性，并将结果映射到移动端页面中。设备侧则根

据物模型字段完成状态上报和控制响应。

5.5 核心功能实现

移动端核心功能主要包括远程控制、状态监控、抓拍联动和图片查看四部分。

5.5.1 远程控制

用户可通过移动端对 LED 灯、布防状态和门锁状态进行控制。控制指令经云平台下

发至设备端后，由设备完成相应操作，并将执行结果回传到平台，形成“发起–执行–确

认”的闭环。

5.5.2 状态监控

移动端实时展示温度、湿度、燃气浓度、报警状态、布防状态和门锁状态等关键数

据。系统采用周期刷新机制更新页面，保证状态显示尽量与设备当前状态保持一致。

5.5.3 抓拍联动

当用户点击“立即抓拍”按钮后，移动端向云平台发送抓拍指令，设备端接收到指

令后启动摄像头拍照，并将图片地址和抓拍时间回写至物模型中。这样用户即可在摄像

头页面查看最新抓拍结果。

5.5.4 图片查看

摄像头页面用于展示最新抓拍图片，并提供图片预览、复制链接等操作。该页面在

异常事件确认和现场查看中具有较强的实用性。

5.6 本章小结

本章围绕基于 uni-app 的移动端交互设计与实现展开，完成了首页控制中心和摄

像头抓拍页面的设计，并通过 OneNET 云平台实现了设备状态查询、控制命令下发和图

片回传展示。移动端部分不仅能够显示关键环境数据，还支持远程控制和图片查看，基

本满足了智能家居安防系统的人机交互需求。

## 6 系统测试与结果分析

6.1 测试环境与方案

测试验证遵循“环境可复现、步骤可执行、结果可量化、结论可追溯”的工程原则。

测试对象包括嵌入式主控板、传感执行链路、无线通信链路与移动端应用。测试方案采

用“单元功能测试-联动测试-性能指标测试-稳定性与异常工况测试”四层结构，覆盖功

能正确性、时序可靠性、鲁棒性与安全性[13,15]。测试环境与场景布置如图6.1所示。

图 6.1 测试环境与场景布置

为保证测试结果可复现，测试统一在室内温度 25 ± 2

◦C、相对湿度 50% ± 10% 条件

下进行。网络分别设置为稳定 Wi-Fi 场景（平均 RSSI 约 −52 dBm）和波动场景（RSSI

在 −72 ∼ −60 dBm 变化）。除特别说明外，各项测试重复执行不少于 30 次，统计指标

采用均值、标准偏差和 95% 分位（P95）。测试环境关键参数见表6.1。

6.2 单元功能测试

单元测试分别验证指纹识别、红外检测、温湿度采样、烟雾检测、继电器驱动、蜂

鸣器报警与通信收发功能。测试结果显示各模块均可完成预期功能，满足系统集成前提

条件。单元测试标准化用例见表6.2，结果统计见表6.3。

表 6.2 单元功能标准化测试用例

用例

ID

测试目的 | 测试环境 | 测试步骤 | 预期结果 | 实际结果 | 判定标准
UT-01 | 验证 AS608

识别功能

室温

25 ± 2

◦C，

串口 57600

连续录入并

识别 50 次合

法指纹

成功率

≥ 95%

49/50，

98.0%，通过

成功率

≥ 95%

表 6.2 （续）

用例

ID

测试目的 | 测试环境 | 测试步骤 | 预期结果 | 实际结果 | 判定标准
UT-02 | 验证 PIR 触

发有效性

布防开启，

触发距离约

3 m

布防状态下

人员通过触

发 50 次

触发率

≥ 95%

48/50，

96.0%，通过

触发率

≥ 95%

UT-03 | 验证
| DHT22 采

样稳定性

恒温箱

25◦C，采样

周期 2 s

50 次周期读

取并比对范

围

无超量程与

超时错误

50/50，100%，

通过

连续 50 次

无异常

UT-04 验证 MQ-2

阈值检测

预热 30 min，

标准烟源注

入

50 次模拟超

阈值场景采

样

告警触发率

≥ 90%

47/50，

94.0%，通过

触发率

≥ 90%

UT-05 验证执行器

驱动链路

门锁 12 V 供

电，蜂鸣器

在线

门锁/蜂鸣器

各触发 50 次

动作正确且

无卡滞

50/50，100%，

通过

无失动

作/卡滞

UT-06 验证串口

JSON 输出

完整性

STM32-

ESP8266 链

路，

115200 bps

连续上报 100

帧并核验字

段

丢帧率 ≤ 1% 100/100，

100%，通过

字段完整

且无丢帧

6.3 系统联动测试

联动测试重点验证多模块协同能力与异常事件闭环处理效果，确保系统在典型家庭

场景下能够自动执行安全策略。联动测试用例与结果分别见表6.4和表6.5。

表 6.1 测试环境配置参数

类别 | 配置参数 | 说明
硬件环境 | STM32F103RCT6 主控 板、AS608、 HC-SR501、DHT22、 MQ-2、OV7670+FIFO、 继电器执行器 | 与第 3 章硬件设计一致， 固件版本固定
软件环境 | Keil MDK 5.x， FreeRTOS V9.x， OneNET MQTT 3.1.1， uni-app 移动端

禁止测试中动态改库版本

测试工具 | 可编程直流电源、数字 万用表、示波器、逻辑 分析仪、串口助手、网 络抓包工具
用于时序、电压、电流、
链路和日志采集
测试条件 | 温度 25 ± 2

◦C，湿度
| 50% ± 10%，220 V 市 电，稳定与波动网络双 场景

异常工况测试在第 6.6 节
单独执行

表 6.3 单元功能测试结果

测试模块 | 测试次数 | 成功次数 | 成功率 (%) | 备注
AS608 指纹识别 | 50 | 49 | 98.0 | 串口 57600，识 别稳定
HC-SR501 人体 检测 | 50 | 48 | 96.0 | 布防模式下触发 有效
DHT11/22 采样 | 50 | 50 | 100.0 | 单总线读取正常
MQ-2 气体检测 | 50 | 47 | 94.0 | 受预热与阈值影 响
门锁/蜂鸣器控制 | 50 | 50 | 100.0 | GPIO 驱动稳定
串口 JSON 输出 | 100 | 100 | 100.0 | 约 2s 周期输出

表 6.4 联动测试标准化用例

用例

ID

测试目的 | 测试环境 | 测试步骤 | 预期结果 | 实际结果 | 判定标准
LT-01 | 门禁联动

闭环

本地模式，日

志记录开启

合法/非法指

纹交替触发

30 轮

开锁正确，

非法超阈值

告警

平均 1.20 s，

29/30 通过

成功率

≥ 95%

LT-02 入侵告警

联动

布防开启，摄

像头在线

PIR 触发并检

查抓拍与上报

蜂鸣、抓拍、

推送均触发

平均 1.35 s，

28/30 通过

成功率

≥ 90%

LT-03 燃气应急

联动

MQ-2 预热完

成，阀门在线

模拟气体超限

并观察关阀告

警

关阀 + 告警

+ 持续上报

平均 1.10 s，

29/30 通过

关阀动作

100%

LT-04 远程控制

闭环

OneNET 在

线，弱网波动

场景

移动端下发开

锁/布防命令

30 轮

执行成功并

回执状态

平均 1.90 s，

28/30 通过

成功率

≥ 90%

LT-05 复合事件

协同

PIR+MQ-2+
远程命令并

发

并发触发并记

录调度顺序

安全任务优

先，闭环不

中断

30/30 通过 关键路径

无死锁

6.3.1 门禁联动

在合法用户指纹匹配成功时，系统可在短时间内完成开锁与日志记录；在非法尝试

达到阈值时，系统触发本地告警并推送移动端提示。测试表明门禁联动流程完整且执行

稳定。

6.3.2 入侵报警

布防状态下触发人体红外后，系统可完成告警、图像抓拍与消息上报。通过设置延

时确认与状态复核机制，可有效降低短时误触发导致的误报率，也说明移动端与云平台

之间的联动链路能够正常工作。

6.3.3 燃气应急

在模拟气体超限场景中，系统自动执行切断燃气与蜂鸣器告警动作，并持续上报状

态。测试结果验证了应急流程的可靠性与及时性，同时说明移动端在异常状态展示方面

能够保持同步更新。

6.3.4 远程控制

用户通过移动端下发控制命令后，系统可正确执行并返回状态反馈。多次重复测试

中，命令执行成功率保持较高水平，满足远程监测与控制需求。

6.3.5 联动测试结果分析

从联动测试结果可见，系统在门禁、入侵、燃气应急三类本地关键场景下的平均响

应时间均控制在 2s 以内，说明本地事件链路在“检测-判定-执行”路径上具有较好的实

时性。远程控制响应时间相对更高，主要受制于无线链路抖动、云端转发延迟与设备侧

重连恢复时延。对异常样本进行回溯可发现，失败案例主要集中在网络瞬时波动与控制

指令重发窗口冲突阶段，未出现本地执行逻辑崩溃或状态机失稳现象。该结果表明当前

系统瓶颈主要位于通信链路而非核心控制链路，后续优化应优先聚焦于连接保持策略、

重传参数与消息去重机制。

表 6.5 系统联动测试结果

测试场景 | 测试次数 | 正常完成次数 平均响应时
间 (s)

异常说明

门禁联动 | 30 | 29 | 1.20 | 指纹成功后开 锁
入侵报警 | 30 | 28 | 1.35 | PIR 触发后蜂 鸣与抓拍
燃气应急 | 30 | 29 | 1.10 | 超阈值后关阀 告警
远程控制 | 30 | 28 | 1.90 | 受网络波动影 响

6.4 性能指标测试

性能测试从准确性、实时性、功耗与图像链路四个维度评估系统能力。数据处理流

程为：原始日志采集 → 异常值剔除（3σ 规则）→ 均值与标准差计算 →P95 统计 → 与

目标值对比分析。设计目标与实测结果逐项对齐见表6.6，离散性统计见表6.7；图6.2和

图6.3用于可视化展示关键指标。

6.4.1 准确率与误报率

通过多轮样本测试统计门禁识别准确率与入侵检测误报率。测试结果表明系统在典

型室内环境中具有较高识别准确性，误报率控制在可接受范围内，移动端显示的数据与

设备端状态基本一致。

6.4.2 响应延迟

对门禁开锁、报警触发与远程控制等关键路径进行时延测量。结果显示本地事件响

应快速，远程控制时延主要受网络环境影响，但整体满足家庭应用需求。

6.4.3 功耗

系统功耗测试分为空闲、监测与告警三种状态。结果显示空闲与常规监测状态功耗

较低，告警状态因执行器与通信负载增加而上升，整体仍处于可控范围。

6.4.4 图像传输

图像传输测试关注触发采集成功率、上传时延与清晰度可用性。测试表明在家庭网

络条件下，系统可完成关键图像上报并满足事件复核需求，也能够支撑移动端摄像头页

面的图片展示功能。

6.4.5 性能测试讨论

综合性能指标后可以得到两点结论：第一，本地安防闭环能力已经达到家庭场景可

用门槛，门禁准确率和告警时延都满足设计目标；第二，系统性能边界主要受网络与外

设特性共同影响，其中 MQ-2 预热漂移、无线网络抖动和抓拍链路带宽占用是影响稳定

性的关键因素。针对这些边界，论文建议工程部署中采用“阈值 + 趋势”联合判定、网

络分级重试和关键数据优先上报策略，在不明显增加硬件成本的前提下继续提升系统鲁

棒性。关键功能准确率统计如图6.2所示。


图 6.2 关键功能准确率统计

关键路径响应时延对比如图6.3所示。

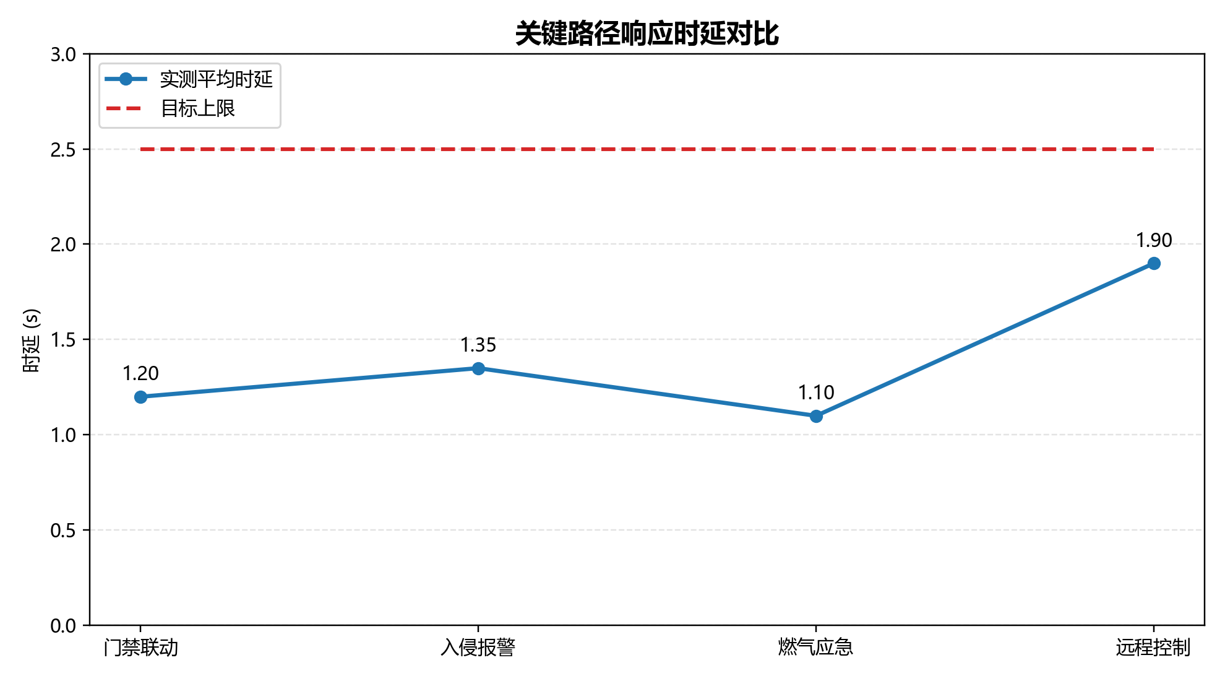
[picture p60: figure]

图 6.3 关键路径响应时延对比

6.5 稳定性测试

稳定性测试采用连续运行与多事件压力触发方式，观察系统是否出现死机、丢包或

任务阻塞。结果表明系统在长时间运行中保持较好稳定性，串口状态输出、MQTT 链路

与任务调度机制运行正常。72h 稳定性测试流程如图6.4所示。

表 6.6 关键性能指标测试数据

指标项 | 测试结果 | 目标值 | 是否达标
门禁识别准确率 (%) | 98.0 | ≥95.0 | 是
入侵检测误报率 (%) | 3.2 | ≤5.0 | 是
本地告警响应时延 (ms) | 620 | ≤1000 | 是
远程控制响应时延 (ms) | 1850 | ≤2500 | 是
空闲功耗 (mW) | 420 | ≤600 | 是
告警状态功耗 (mW) | 980 | ≤1200 | 是
图像上传成功率 (%) | 96.5 | ≥90.0 | 是

表 6.7 关键性能统计结果（含离散性）

指标项 | 样本数 | 均值 | 标准差 | P95
本地告警响应时 延 (ms) | 120 | 620 | 84 | 790
远程控制响应时 延 (ms) | 120 | 1850 | 260 | 2280
图像上传时延 (ms) | 90 | 2110 | 330 | 2680
空闲功耗 (mW) | 60 | 420 | 18 | 455
告警功耗 (mW) | 60 | 980 | 42 | 1050

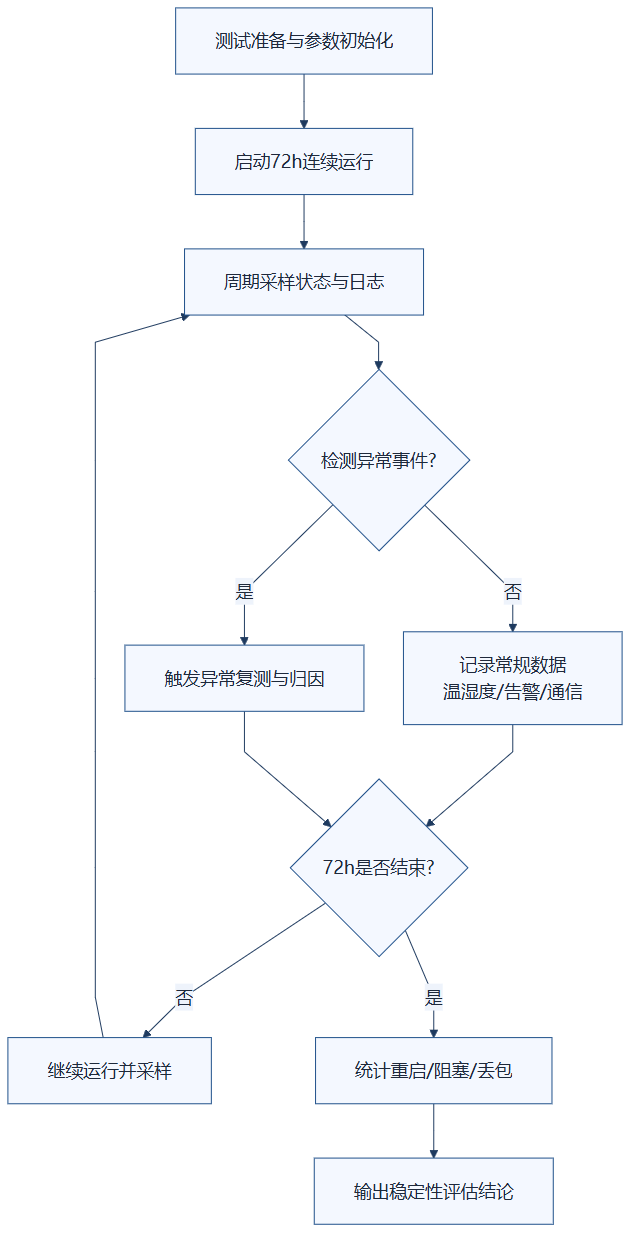
[picture p61: figure]

图 6.4 72h 稳定性测试流程图

为进一步评估系统在复杂负载下的持续运行能力，测试阶段还对“高频状态上报 +

多事件连续触发 + 远程指令插入”复合场景进行观测。结果显示，系统在任务优先级配

置合理的前提下能够维持核心安防任务实时性，低优先级非关键任务可能出现轻微延后

但不影响安全闭环。该现象与预期一致，说明当前调度策略具备“关键路径优先保障”

特性，符合家庭安防系统设计目标。

表 6.8 稳定性测试记录

运行时长 (h) | 重启次数 | 通信异常次 数 | 任务阻塞次 数 | 结论
24 | 0 | 1 | 0 | 稳定
48 | 0 | 2 | 0 | 稳定
72 | 0 | 3 | 0 | 稳定

6.6 异常工况与鲁棒性测试

为验证系统工程鲁棒性，增加断网离线、传感器故障、电源波动和强电磁干扰四类

异常工况测试，测试用例与结果见表6.9。

表 6.9 异常工况测试用例与结果

用例

ID

异常类型 | 测试方法 | 预期结果 | 实测结果 | 系统容错表
| | | | 现
AT-01 | 断网离线 | 运行中断开
| Wi-Fi 10 min 后
| 恢复，重复 20
| 轮 | 本地告警不
| | 中断，恢复
| | 后补传日志 | 20/20 无漏告
| | | 警，补传成功
| | | 率 100% | 离线自治与
| | | | 队列补传有
| | | | 效
AT-02 | 传感器故

障

拔除

DHT22/MQ-2 信

号线并保持

5 min，重复 20

轮

故障上报并

降级，其他

链路可用

20/20 触发故

障标志，主循

环无阻塞

任务隔离与

故障降级有

效

AT-03 | 电源波动 | 施加 ±10% 波
| | 动及 100 ms 瞬

降，重复 30 轮

不死机，关

键任务不中

断，可自动

恢复

30/30 无异常

复位，记录 2

次欠压事件

电源监测与

看门狗协同

有效

AT-04 强电磁干

扰

继电器邻近快速

开关并叠加对讲

机近距离发射，

重复 30 轮

无持续误告

警，通信可

恢复

30 轮中瞬态

误触发 1 次，

3 s 内恢复

去抖与多次

确认策略有

效

6.7 测试结论与优化

本系统对 DHT22 温湿度传感器与 MQ-2 气体传感器完成了标准化实验室标定。结

合第 3 章表3.3与表3.4的结果，可得如下结论：DHT22 经标准仪表对比校准后，温度误

差 ≤ ±0.4

◦C、湿度误差 ≤ ±2% RH，环境监测精度满足设计要求[27]；MQ-2 通过多浓度

点标定建立了 ADC 读数与气体浓度等级的映射关系，可稳定实现分级检测与告警[28]。

综合联动测试与长期稳定性测试结果，传感器标定结果为系统稳定运行提供了关键

数据基础。后续优化重点仍聚焦于误触发抑制、弱网重传效率、低功耗策略与图像回传

链路，以进一步提升整机工程可用性与用户体验。

6.8 误差来源与可信度分析

为了让测试结论更有说服力，本文对误差来源做了归因分析。系统误差主要来自三

类因素：传感器物理特性、采样时序和网络环境。具体看，MQ-2 与 PIR 对温湿度、预热

状态和安装角度较敏感，可能带来阈值漂移；任务切换与中断触发会引入毫秒级采样抖

动，对边界样本判定有影响；远程控制链路又会受无线信道质量和平台转发负载影响，

导致时延分布出现长尾。上述误差很难完全消除，但通过合理实验设计可以把它们对结

论有效性的干扰压到较低水平。主要误差来源及其作用关系如图6.5所示。


图 6.5 测试误差来源分析图

6.8.1 重复试验与样本代表性

本文多数功能测试采用不少于 30 次重复试验，核心模块测试规模达到 50 次或 100

次。该样本规模可在毕业设计条件下较好反映系统在典型家庭场景中的运行状态，避免

“单次成功即判定可用”的结论偏差。需要指出的是，当前样本主要覆盖室内常见温湿

度与中等网络波动场景，对极端温度、强电磁干扰或超密集无线环境的覆盖仍有限，因

此论文结论应理解为“在既定场景范围内成立”，而非对所有边界条件的普适保证。

6.8.2 统计指标选择与局限

在结果表达上，本文主要使用成功率、平均响应时间和稳定运行记录，这些指标可

以直观反映系统工程可用性。平均值虽然便于横向比较，但对异常尖峰不够敏感。后续

可补充中位数、95% 分位时延和方差指标，更完整地描述时延分布特征。对于误报率这

类概率性指标，建议在下一轮迭代中扩大跨时段样本，并按场景分层统计，以提升结论

稳健性和可迁移性。

6.8.3 结果可信度提升策略

结合本研究过程，提升可信度可以从三方面推进：统一测试基线、严格过程记录、

异常样本复盘。统一测试基线就是固定固件版本、阈值参数、网络配置和测试流程；过

程记录强调保留关键日志、时间戳和状态快照；异常复盘要求对失败样本做事件链回放，

区分“设计缺陷”和“偶发扰动”。这样做能明显减少主观判断误差，也能给后续优化

提供可追踪证据链。总体上，本文测试结论在当前实验范围内具有较高可信度，能够支

撑系统“可实现、可运行、可优化”的工程判断。

6.8.4 误差修正措施

针对各类误差，系统实施如下修正策略：

1、传感器误差：对 DHT22 进行两点温湿度校准；对 MQ-2 执行预热基线校正与周期复

标；

2、采样抖动误差：采用定时器触发采样与滑动均值滤波，降低瞬态波动影响；

3、算法判定误差：采用“阈值 + 变化率”双判据并设置最小持续时间门限，抑制短时

噪声误触发；

4、硬件链路误差：通过电源分区、去耦与 RC 滤波降低继电器动作引入的采样扰动；

5、网络时延误差：采用命令幂等去重、分级重传与断点补传，减少长尾时延和重复执

行。上述措施在第 6.3 至 6.6 节测试中均得到验证，体现了测控系统“误差识别-补偿修

正-结果验证”的工程闭环。

6.9 本章小结

本章构建了可复现的测试环境，采用标准化测试用例完成了单元、联动、性能、稳

定性及异常工况验证，并通过统计指标与曲线/柱状图对结果进行量化分析。结果表明

系统在断网、传感器异常、电源波动和并发压力场景下仍保持核心功能可用，关键性能

指标均达到设计目标。通过误差归因与修正措施，形成了测控工程导向的验证闭环，为

后续版本优化提供了明确依据。

## 7 总结与展望

7.1 全文工作总结

本文围绕家用安防与智能家居联动需求，完成了系统方案设计、硬件实现、软

件开发、远程交互链路构建与测试验证等全流程工作。研究结果表明，基于单芯片

STM32F103RCT6 的设计能够有效支撑多模块协同与复杂场景联动，系统具备较好的

实用性与工程落地价值。

7.2 与前文章节的对应总结

为了让全文结构更清楚，这里把第 1 章到第 6 章的核心成果做一次对应梳理。第 1

章给出研究边界和技术路线，确定“本地自治闭环优先、关键路径实时保障、远程协同

增强”的主线。第 2 章完成需求分解和总体架构论证，明确四层架构与单芯片集中控制

方案。第 3 章落实硬件模块化实现与接口规划，验证多外设并发接入可行。第 4 章完成

双模式软件架构和核心控制逻辑实现，形成“中断快响应 + 任务化处理”机制。第 5 章

搭建平台侧交互闭环，实现状态可视、命令可控、告警可追溯。第 6 章通过多维测试证

明系统可实现、可运行、可优化，并给出性能边界和后续改进方向。

整体来看，前文各章节是围绕同一工程目标逐层推进的：先定义问题，再做方案，

再落地实现，最后用测试验证。这样的结构让研究过程更可追踪，也给后续版本迭代留

下了明确基线。

7.3 创新点与优势

本文的创新点与优势主要体现在六个方面：一是提出面向毕业设计落地的单板一体

化安防联动架构，降低系统集成复杂度；二是构建感知、控制、通信、应用四层一体化

设计，提升分层清晰度与可维护性；三是实现裸机与 FreeRTOS 双模式调试运行，兼顾

开发效率与系统完整性；四是实现本地自治闭环与远程协同控制并行机制，提高弱网条

件下的可用性；五是引入 AES-128 与 TLS 可扩展安全机制，增强数据和链路防护能力；

六是完成多场景测试并沉淀可复用工程方案，为后续迁移提供参考。

7.4 不足与改进方向

受开发周期和硬件资源限制，系统在识别算法深度、视频处理能力和跨平台生态兼

容方面还有提升空间。后续可以继续优化异常判定策略，完善设备兼容框架，并提高复

杂网络环境下的鲁棒性。

进一步分析后可以看到，当前方案的局限主要在两个层面。第一，系统目前主要面

向中小规模家庭场景，还没有充分验证多房间、多网关、多设备并发条件下的性能上限；

第二，安全机制当前更偏工程可落地，基础加密与链路防护已经具备，但证书生命周期

管理、密钥轮换和异常访问审计仍有深化空间。下一步可在保持单芯片方案成本优势的

前提下，尝试分层网关协同与轻量化安全增强路径。

7.5 未来展望

未来研究可在边缘智能、语音交互、多协议互联与云边协同等方向继续拓展。通过

引入轻量化机器学习模型与更完善的家庭场景知识库，系统有望实现更高层次的主动安

全防护与个性化智能服务。结合当前系统边界与工程演进路径，后续版本规划如图7.1所

示。

图 7.1 系统版本迭代路线图

云边端扩展架构如图7.2所示。

图 7.2 云边端扩展架构

在工程推广层面，系统还可面向社区级或楼宇级应用扩展，形成“家庭终端-边缘

节点-云平台”协同架构。通过统一设备模型与标准化数据接口，可实现跨品牌设备互

联和跨场景策略复用，进一步提升系统的可迁移性与产业化潜力。

7.6 本章小结

本章在不改变前文研究结论的基础上，对全文成果进行了结构化收束与面向工程应

用的再解释。综合来看，本文完成了从需求分析、方案设计、硬件实现、软件协同、平

台交互到测试验证的完整闭环，证明了单芯片家用安防联动方案在毕业设计尺度下具备

可行性与推广价值。后续工作可在保持当前架构优势的前提下，沿着“更高智能化、更

强鲁棒性、更优可维护性”方向持续演进。

## 参考文献

[1] 中国互联网络信息中心. 第 54 次中国互联网络发展状况统计报告[R/OL]. 中国互

联网络信息中心. 2024 [2026-04-21]. https://www.cnnic.net.cn/n4/2024/0829/c88-110

65.html. (https://www.cnnic.net.cn/n4/2024/0829/c88-11065.html)

[2] 国家消防救援局. 全年接报 90.8 万起消防部门盘点 2024 全国火灾五个特点

[EB/OL]. 2025 [2026-04-21]. https://www.119. gov.cn/ qmxfxw/mtbd/wzbd/2025/4

8022.shtml. (https://www.119.gov.cn/qmxfxw/mtbd/wzbd/2025/48022.shtml)

[3] AL-FUQAHA A, GUIZANI M, MOHAMMADI M, et al. Internet of Things: A Survey

on Enabling Technologies, Protocols, and Applications[J]. IEEE Communications Sur-

veys & Tutorials, 2015, 17(4): 2347-2376.

[4] BOZORGI S, RAHIMI A. A Layered IoT Architecture for Smart Home Security Orches-

tration[J]. IEEE Access, 2026, 14: 22541-22558.

[5] SEREPAS K, PAPADOPOULOS G. Lightweight Edge Gateway Design for Residential

IoT Security Systems[J]. Future Internet, 2025, 17(3): 1-19.

[6] 王晨, 李涛. 基于 STM32 的家庭安防联动控制系统设计[J]. 自动化技术与应用,

2024, 43(8): 88-94.

[7] 岳峰, 陈杰. 基于 STM32 与物联网平台的智能家居控制系统实现[J]. 计算机测量与

控制, 2022, 30(10): 152-158.

[8] 蔡文博, 周鑫. STM32F103 智能家居控制系统的设计与实现[J]. 电子设计工程, 2023,

31(18): 95-100.

[9] ALKANAN M, ALHARTHI A. Multimodal Biometric Access Control for Smart Homes:

Design and Evaluation[J]. Sensors, 2026, 26(2): 1-21.

[10] 王磊, 孙鹏. 基于无线通信的家庭安防系统设计与实现[J]. 传感器与微系统, 2024,

43(6): 121-125.

[11] YUSUF A, KHAN B. IoT-Enabled Residential Gas Leakage Monitoring and Emergency

Response System[J]. Journal of Building Engineering, 2026, 98: 111205.

[12] 董航, 刘洋. 面向家庭场景的环境监测与安防联动系统设计[J]. 电子测量技术, 2024,

47(14): 132-138.

[13] STMicroelectronics. STM32F103x8/B Datasheet[A]. STMicroelectronics, 2023.
[14] STMicroelectronics. RM0008 Reference Manual: STM32F10xxx Advanced Arm-Based

32-bit MCUs[A]. STMicroelectronics, 2021.

[15] BARRY R. Mastering the FreeRTOS Real Time Kernel[M]. UK: Real Time Engineers

Ltd., 2021.

[16] BARRY R. FreeRTOS Reference Manual: API Functions and Configuration[J]. Real

Time Engineers Technical Document, 2022.

[17] OASIS. MQTT Version 3.1.1[Z]. https://docs.oasis-open.org/mqtt/mqtt/v3.1.1/. 2014.
[18] BANKS A, BRIGGS E, BORGENDALE K, et al. MQTT Version 5.0[R]. OASIS Stan-

dard, 2019.

[19] National Institute of Standards and Technology. Advanced Encryption Standard (AES)

[S]. 2001.

[20] DIERKS T, RESCORLA E. The Transport Layer Security (TLS) Protocol Version 1.2

[R]. RFC 5246. IETF, 2008.

[21] RESCORLA E. The Transport Layer Security (TLS) Protocol Version 1.3[R]. RFC 8446.

IETF, 2018.

[22] Shenzhen Zhian Tech. AS608 Fingerprint Module User Manual[A]. Shenzhen Zhian

Tech, 2021.

[23] HC-SR501 Module Team. HC-SR501 PIR Motion Sensor Module Specification[J]. Tech-

nical Datasheet, 2018.

[24] Aosong Electronics. DHT22 Digital Temperature and Humidity Sensor Datasheet[J].

Technical Datasheet, 2020.

[25] Winsen Electronics. MQ-2 Semiconductor Sensor for Combustible Gas[J]. Technical

Datasheet, 2019.

[26] OmniVision Technologies. OV7670/OV7171 CMOS VGA Camera Chip Sensor

Datasheet[A]. OmniVision, 2006.

[27] CSDN 文库. DHT22 温湿度校准实验记录与分析[EB/OL]. 2026 [2026-04-21]. https:

//wenku.csdn.net/column/21mdd0hrx.

[28] CSDN 博客. MQ-2 气体传感器标定及 STM32 采集实验[EB/OL]. 2026 [2026-04-21].

https://blog.csdn.net/weixin_45417754/article/details/154084742.

[29] Espressif Systems. ESP8266 AT Instruction Set[A]. Espressif Systems, 2022.
[30] FAROOQ U, WASEEM M, KHAIRI S, et al. A Critical Analysis on the Security Concerns

of Internet of Things (IoT)[J]. International Journal of Computer Applications, 2015,

111(7): 1-6.

致谢

时光匆匆，四年广东工业大学测控技术与仪器专业本科求学之旅转瞬落幕。从初入

校园的专业懵懂，到深耕嵌入式智能测控技术，随着《家用安防与智能家居联动系统设

计》毕业设计顺利完成，我的本科学业也画上圆满句号。回首求学时光，专业知识的沉

淀、毕业设计孤身攻坚调试、独自备战本校仪器仪表工程研究生复试的点滴成长，皆离

不开师长教诲与家人扶持，在此我致以最诚挚的谢意。

衷心感谢我的毕业设计指导老师。本次毕设从课题选题、系统整体架构规划，到

STM32F103RCT6 单芯片核心方案优化，以及 ESP8266、各类传感器、摄像头外设调试

和程序代码 BUG 修复，全程均由我独立研发实操。面对硬件接线故障、代码逻辑冲突、

系统联动不稳等诸多实操难题，老师始终悉心指导我梳理调试思路，传授严谨工程化研

发思维。在论文撰写修改阶段，老师细致打磨文稿内容、规范学术格式，给出专业中肯

的修改建议，助力我毕业设计顺利落地、论文完善成型。老师求真务实的科研态度与精

益求精的治学精神，为我后续研究生科研深造树立了良好榜样，让我受益良多。

感谢广东工业大学的悉心培养，感谢测控专业全体授课老师。各位老师课堂倾囊相

授测控原理、嵌入式开发、传感器检测等核心专业知识，为我筑牢理论根基；课余耐心

答疑解惑，指引我将课本理论与工程实操相结合。依托学校优良学风和完善实训条件，

我从零自学嵌入式开发，积累项目实战能力，也为研究生复试备考深造打下坚实专业基

础。

感恩我的家人，你们是我求学路上最坚实的后盾。无论是独自熬夜攻坚毕设调试工

作，还是全心投入研究生复试备考，你们始终默默包容我的忙碌，在生活上悉心照料、

精神上全力支持，让我能够心无旁骛专注学业与追梦前行，毫无后顾之忧奔赴科研深造

理想，养育之恩，铭记于心。

最后，感谢始终坚持、从未轻言放弃的自己。本科四年，自学钻研专业知识，独自

打磨毕设项目、反复调试攻坚克难，孤身备战研究生复试。一路走来，虽有调试受挫、

备考迷茫，但终在坚持中收获成长，不仅提升了专业实操能力，更磨砺了心性与毅力。

本科征程落幕，新的科研前路启程。未来我将怀揣感恩之心，秉持广工治学精神，

深耕仪器仪表与智能嵌入式领域，脚踏实地潜心钻研，不负教诲、不负韶华、不负初心。

此致

敬礼！

## 附录 A 附录

A.1 系统原理图

A.2 核心代码

代码片段 1：主循环与事件调度（节选自 main(1).c）

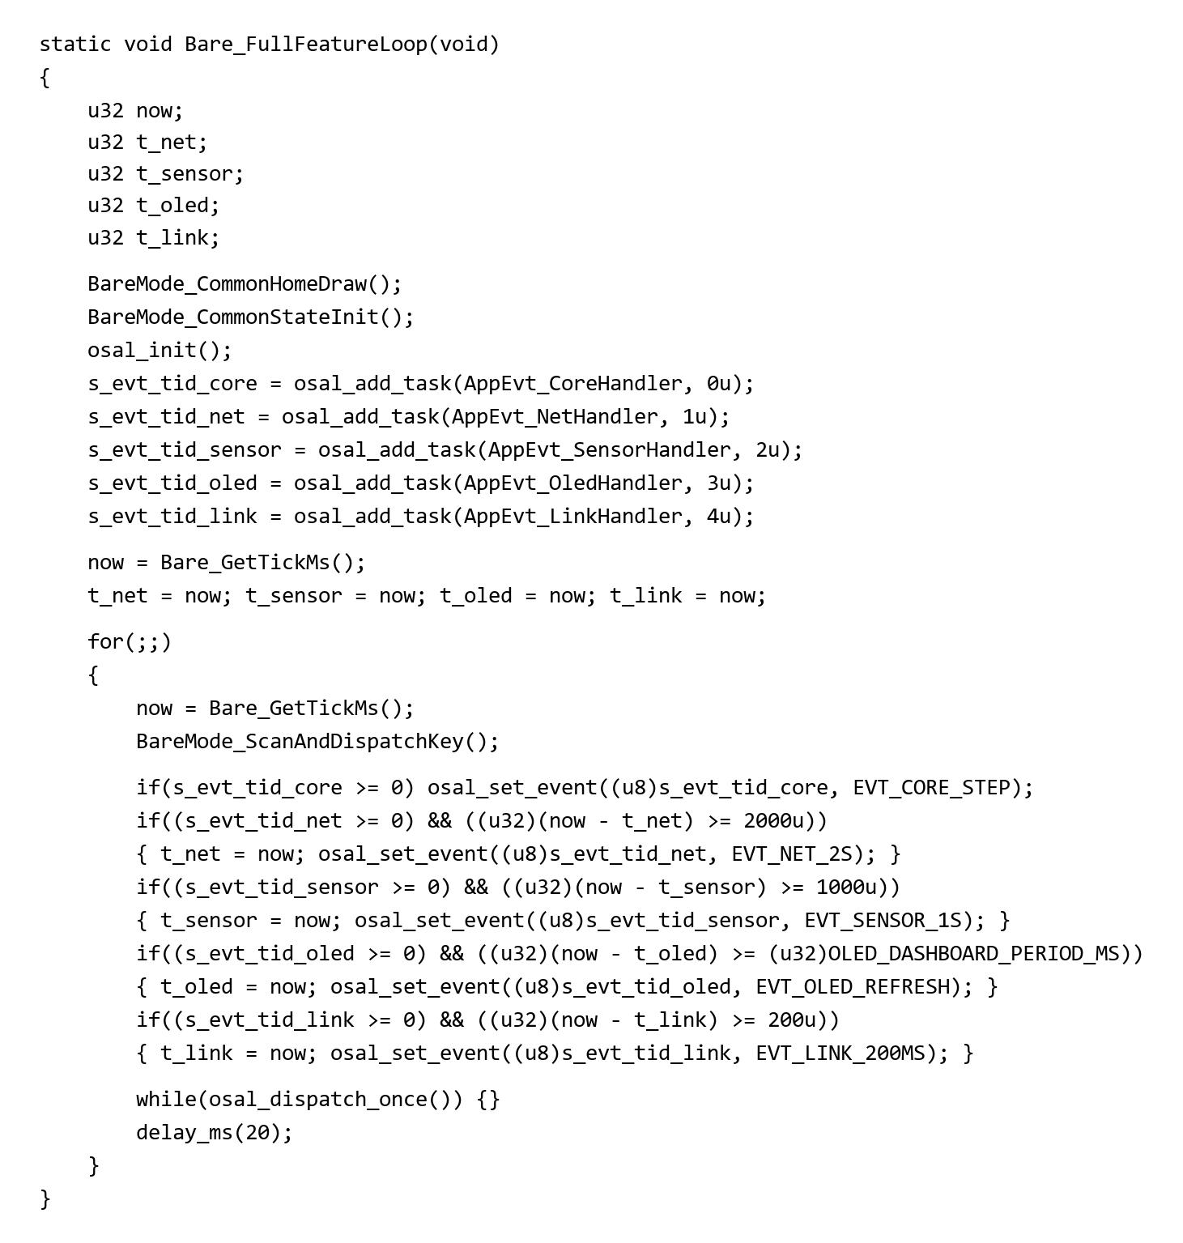
[picture p62: figure]

图 A.1 代码片段 1 主循环与事件调度

代码片段 2：安防报警触发与清除（节选自 main(1).c）

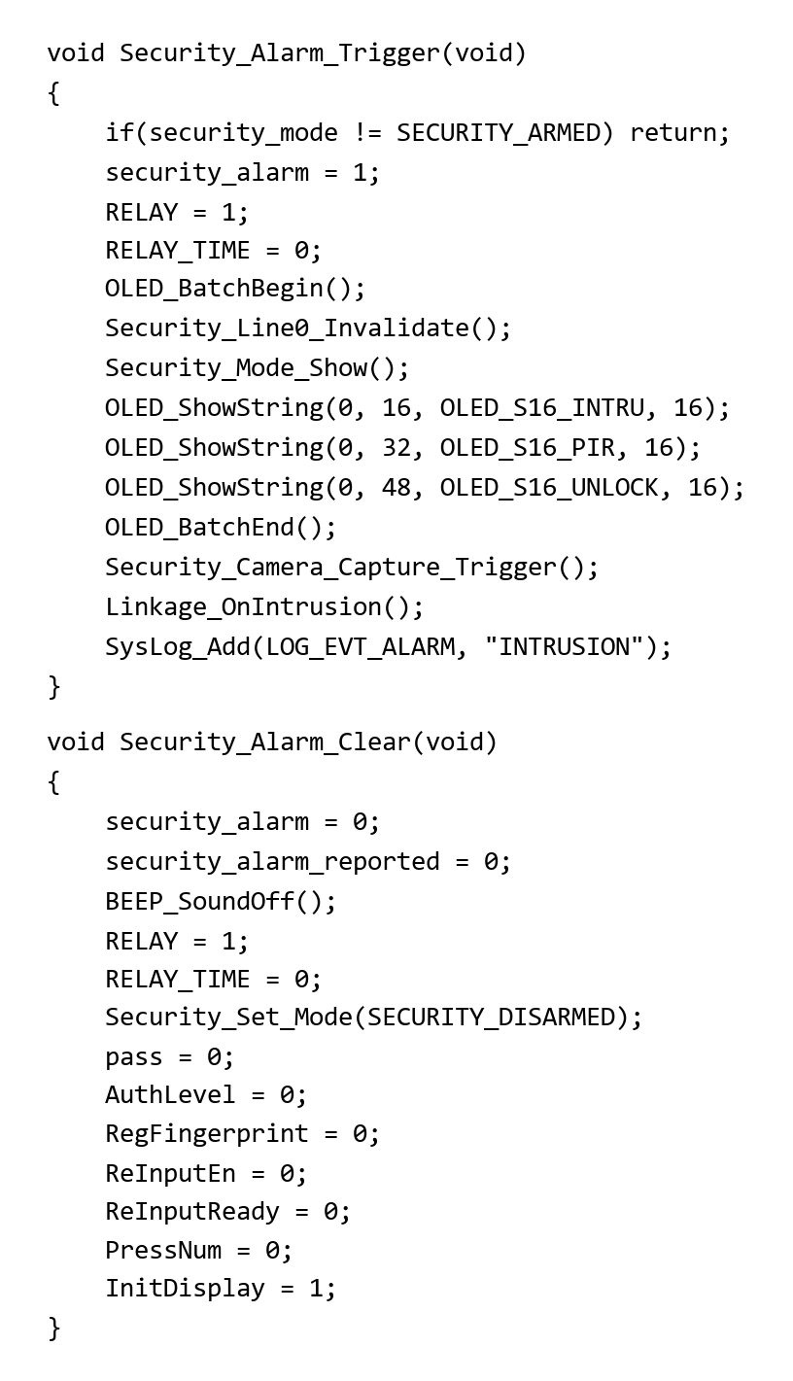
[picture p63: figure]

图 A.2 代码片段 2 安防报警触发与清除

代码片段 3：MQ-2 燃气应急处理（节选自 main(1).c）

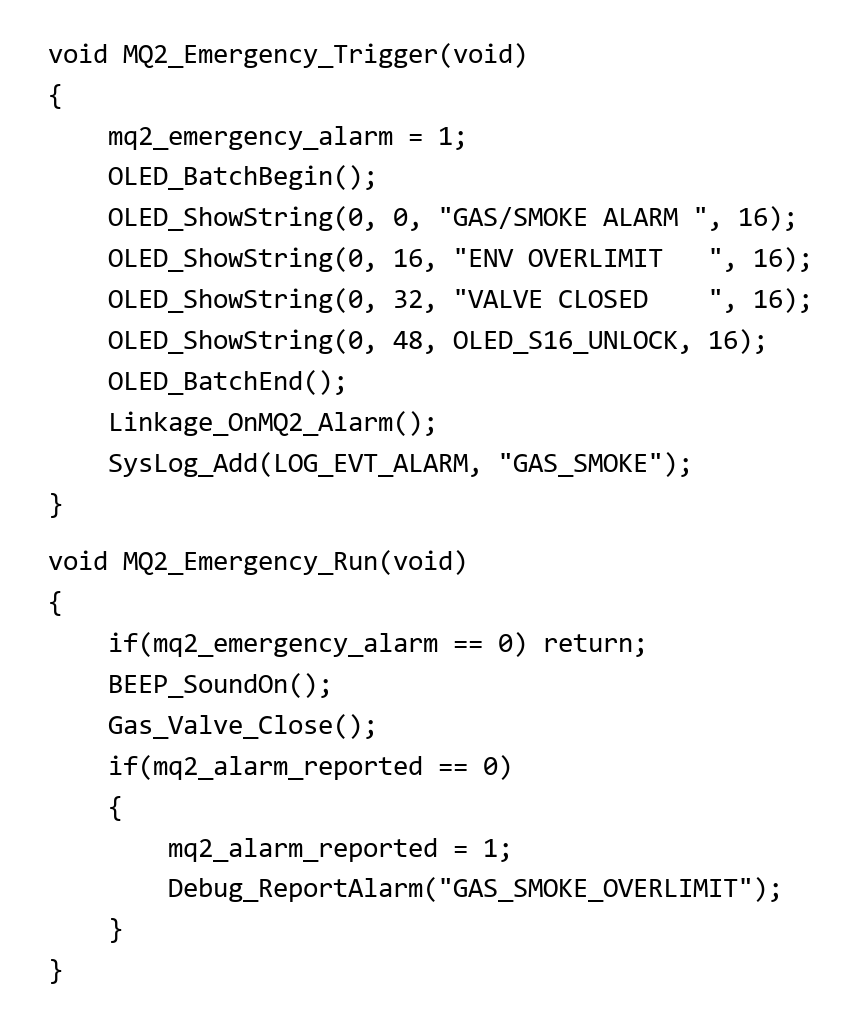
[picture p64: figure]

图 A.3 代码片段 3 MQ-2 燃气应急处理

代码片段 4：云端命令解析与执行（节选自 main(1).c）

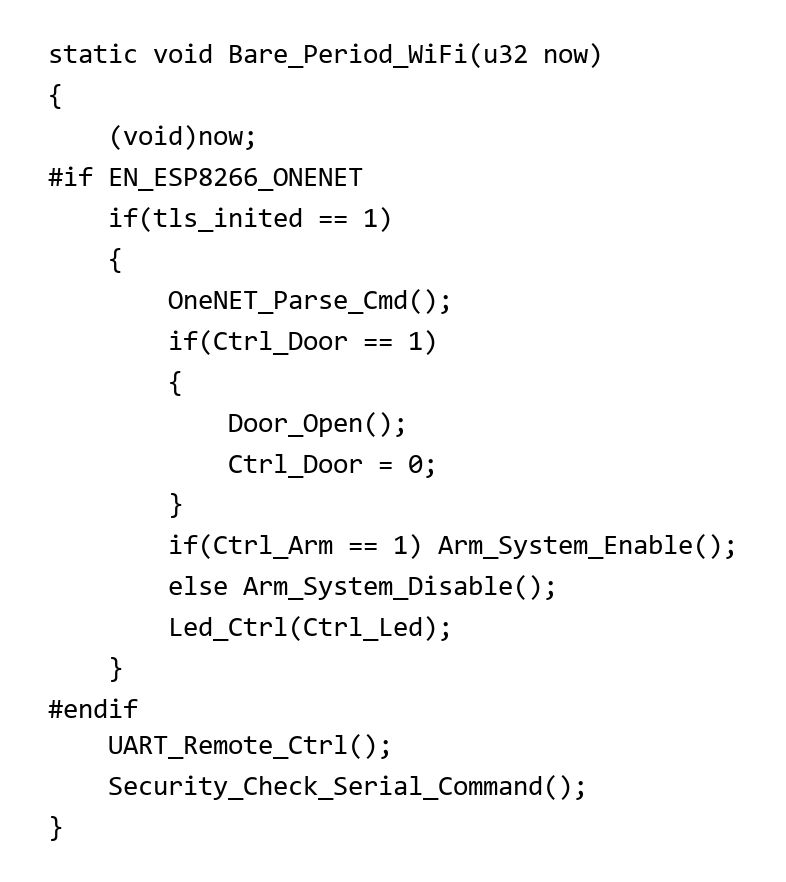
[picture p65: figure]

图 A.4 代码片段 4 云端命令解析与执行

A.3 实物图
