HJDSS/STM32-SmartHome-Security/论文格式整改说明.md

# 论文格式整改说明

以下内容基于当前已查看的 `论文.pdf`，整理为“可直接修改项”和“需你手动补齐项”。

## 一、可直接改的格式问题

### 1. 摘要页
- 中文摘要标题统一为“三号黑体加粗，居中”。
- 中文摘要正文统一为“小四号宋体，1.5 倍行距，首行缩进 2 字符”。
- 中文关键词改为：`关键词：智能家居，家庭安防，STM32F103RCT6，FreeRTOS，MQTT`
- 英文摘要标题统一为 `Abstract`，使用 Times New Roman 四号加粗。
- 英文关键词统一为 `Key words: smart home, home security, STM32F103RCT6, FreeRTOS, MQTT`。

### 2. 标题层级
建议将以下标题简化，去掉括号、斜杠、加号等符号：
- `2.2 系统总体架构（四层架构）` → `2.2 系统总体架构`
- `4.2 软件架构（裸机/FreeRTOS 双模式）` → `4.2 软件架构`
- `4.7 关键时序与工程实现细节` → `4.7 关键时序设计`
- `4.8.1 WiFi + MQTT` → `4.8.1 WiFi 与 MQTT`
- `5.3 UI 界面设计` → `5.3 用户界面设计` 或 `5.3 界面设计`
- `5.4 通信模块（MQTT）` → `5.4 通信模块 MQTT`
- `6.7 测试误差来源与统计可信度分析` → `6.7 误差来源与可信度分析`
- `7.6 终章小结` → `7.6 本章小结`

### 3. 页码与分节
- 封面、摘要、目录页不显示页码。
- 正文从绪论开始使用阿拉伯数字连续页码。
- 页码统一放在页脚右侧，Times New Roman，小五号。

### 4. 图表
- 图题统一放在图下，五号宋体。
- 表题统一放在表上，五号黑体加粗。
- 图表编号按章编号，例：`图 3.1`、`表 4.2`。
- 表格尽量不要跨页。
- 表格无左右边线，表头无斜线。

### 5. 正文统一字体与段落
- 正文统一为小四号宋体。
- 数字、字母、英文缩写统一 Times New Roman。
- 全文行距统一为 1.5 倍。
- 正文首行缩进 2 字符。

### 6. 参考文献格式
- 统一按 GB/T 7714—2015 调整。
- 文内引用和文后条目逐条对应。
- 文献类型标记、大小写、标点和空格需统一。

## 二、需要你手动补齐或核对的内容

### 1. 前置材料缺失
当前 PDF 未见以下材料，需确认是否另附：
- 学术诚信承诺书
- 任务书
- 中期检查表
- 评阅表 / 答辩评议表
- 答辩记录

### 2. 摘要中的“课题来源”
中文摘要末尾需单独补充“课题来源”。

### 3. 参考文献引用对应关系
需逐条检查正文中所有引用是否都能在参考文献列表中找到对应文献。

### 4. 字数是否达标
需在 Word 中统计正文纯文本字数，确认是否满足学校要求。

### 5. 查重率
答辩前查重率不得超过 20%，学校仅提供 2 次免费检测机会。

## 三、建议的最终处理顺序
1. 先统一标题与摘要格式。
2. 再设置页码与分节。
3. 然后统一图表格式。
4. 最后核对参考文献与正文引用。

## 四、备注
如果你愿意，我可以下一步继续帮你把这份论文整理成：
- 一份“逐页修改清单”；或者
- 一份可直接套用的 Word 样式模板说明。
