HJDSS/STM32-SmartHome-Security/论文相关/答辩配套材料.md

# 家用安防与智能家居联动系统答辩配套材料

## 一、答辩PPT大纲（约15页）

> 主题建议：**《家用安防与智能家居联动系统设计与实现》**  
> 结构遵循“问题-方案-实现-验证-结论”答辩逻辑，适配测控类工程答辩。

### 1. 封面页
- 核心内容：题目、学院专业、姓名、学号、指导老师、答辩日期
- 配图建议：系统整体实物图（主控板+传感器+执行器）

### 2. 研究背景与意义
- 核心内容：家庭安防痛点（门禁、入侵、燃气泄漏、环境异常）、低成本可落地需求
- 配图建议：应用场景图+风险事件示意图（图标化）

### 3. 研究目标与技术指标
- 核心内容：功能目标+量化指标（识别准确率、误报率、响应时延、功耗、上传成功率）
- 配图建议：目标指标表格（目标值 vs 实测值预告）

### 4. 系统总体架构
- 核心内容：感知层-控制层-通信层-应用层四层架构；本地自治闭环+远程协同
- 配图建议：论文中的总体架构图（分层框图）

### 5. 硬件方案与接口分配
- 核心内容：STM32F103RCT6为核心；AS608、HC-SR501、DHT、MQ-2、OV7670+FIFO、ESP-01S、SD、执行器
- 配图建议：关键硬件接口分配表（引脚/电气特性/功能）

### 6. 关键硬件实现-I（感知与采样）
- 核心内容：DHT/MQ-2/PIR接入与调理；ADC采样、去耦、抗干扰设计
- 配图建议：DHT、MQ-2、PIR原理图+实物图对照

### 7. 关键硬件实现-II（执行与电源）
- 核心内容：门锁/燃气阀/蜂鸣器驱动（继电器+三极管）；DCP3512四路电源模块分配
- 配图建议：蜂鸣器驱动原理图、电源分配与最大电流预算表

### 8. 软件架构与运行模式
- 核心内容：裸机调试模式 + FreeRTOS运行模式；驱动层/服务层/业务层解耦
- 配图建议：软件架构图 + 任务划分表

### 9. 核心控制逻辑与状态机
- 核心内容：门禁、入侵、燃气应急状态机；异常降级与恢复机制
- 配图建议：状态机图+关键转移条件表

### 10. 通信与安全机制
- 核心内容：ESP8266(USART3) + MQTT上报/下发；AES-128本地保护与TLS扩展
- 配图建议：通信链路图+主题/报文示例

### 11. 传感器标定与数据处理
- 核心内容：DHT22标定结果、MQ-2分级标定与温漂/滤波处理、融合策略
- 配图建议：标定原始数据表（表3-4/3-5）+处理流程图

### 12. 测试方案与标准化用例
- 核心内容：测试环境、单元/联动/异常工况标准化模板（目的-环境-步骤-预期-实际-判定）
- 配图建议：标准化测试用例长表截图（简化展示）

### 13. 测试结果与统计分析
- 核心内容：关键结果：98.0%识别、3.2%误报、620ms本地时延、1850ms远程时延、72h稳定
- 配图建议：准确率柱状图、时延统计图（均值/标准差/P95）、误报率95%CI图

### 14. 创新点与工程价值
- 核心内容：
  - 单芯片多模块协同闭环
  - 本地自治+远程协同并行
  - 裸机/RTOS双路径调试与运行
  - 工程化测试闭环（含异常工况）
- 配图建议：创新点对比表（传统方案 vs 本文方案）

### 15. 总结与展望（答辩结束页）
- 核心内容：工作完成度、指标达成、局限与下一步（算法优化、多设备扩展、云边协同）
- 配图建议：版本迭代路线图 + “感谢聆听，敬请指正”

---

## 二、8-10分钟答辩稿（口语化版）

各位老师好，我是测控技术与仪器专业的XXX。我的毕业设计题目是《家用安防与智能家居联动系统设计与实现》。下面我从研究背景、系统设计、实现过程、测试结果和总结展望五个部分进行汇报。

首先是研究背景。家庭场景中，门禁失效、非法入侵、燃气泄漏和环境异常是最常见、也最实际的风险。很多现有系统要么功能单一，要么成本较高、部署复杂。我的目标是做一套在本科毕设条件下可实现、可复现、可验证的低成本联动安防系统，不仅能“检测”，还能“联动执行”和“远程协同”。

本课题的核心目标有三点：第一，构建完整的本地安防闭环；第二，支持云端远程查看和控制；第三，用量化测试证明系统性能。指标上，我设定了门禁准确率、误报率、响应时延、功耗和稳定性等关键参数，并在第六章逐项验证。

在总体方案上，系统采用感知层、控制层、通信层、应用层四层架构。硬件主控是STM32F103RCT6。感知层包括AS608指纹、HC-SR501人体红外、DHT温湿度和MQ-2气体传感器；执行层包括门锁、燃气阀和蜂鸣器；通信层采用ESP-01S通过MQTT接入云平台；应用层是移动端状态展示和远程控制。整个系统强调“本地自治优先，远程协同增强”，也就是网络异常时本地安全功能不能失效。

硬件实现方面，我重点做了三类工作。第一是接口规划和电气匹配，比如ESP8266走USART3，SD卡走SPI2，MQ-2走ADC采样。第二是驱动与保护电路设计，比如蜂鸣器和继电器采用三极管驱动并考虑瞬态抑制。第三是电源管理，我实际使用DCP3512四路电源模块，分别提供3.3V、5V、12V和可调电压，并做了电源分配和最大电流预算。这个预算后面和功耗测试做了直接对齐，保证前后章节逻辑一致。

软件实现上，我设计了裸机调试与FreeRTOS运行的双路径。裸机路径用于外设联调和时序定位，FreeRTOS路径用于完整业务并发。核心控制采用状态机：门禁状态机负责识别、开锁、失败锁定；入侵和燃气状态机负责告警、联动执行与恢复。通信上，设备通过MQTT上报状态和接收控制命令，安全上采用AES-128进行本地敏感数据保护，并预留TLS扩展能力。

关于传感器部分，我补充了标定与信号处理。DHT22在恒温恒湿条件下完成对比校准，误差控制在温度±0.4℃、湿度±2%RH。MQ-2通过多浓度点标定建立了ADC到浓度等级的映射，并结合滤波和阈值策略减少噪声误判。这部分为后续测试数据的可信性提供了基础。

测试验证是本课题的重点。我按照“单元测试、联动测试、性能测试、稳定性与异常工况测试”展开，且统一采用标准化模板记录。结果方面：门禁识别准确率达到98.0%，入侵误报率3.2%，本地告警平均时延620毫秒，远程控制平均时延1850毫秒，图像上传成功率96.5%，系统连续运行72小时无死机。统计分析上，我给出了均值、标准差、95%分位值，并对误报率给出95%置信区间，提升了数据说服力。异常工况中，我验证了断网离线、传感器故障、电源波动和强电磁干扰场景，系统都能维持核心功能并实现降级恢复。

本课题的创新点主要体现在四个方面：一是单芯片下多模块联动的工程化落地；二是本地自治与远程协同并行机制；三是裸机和RTOS双路径便于调试与部署；四是测试环节完整，形成“设计-实现-验证-优化”的闭环。

当然，本系统也有不足，比如远程控制长尾时延在弱网下仍偏高，视频与图像链路还有优化空间。后续我计划在三方面改进：优化重传和连接保持策略、引入更稳健的融合判定算法、探索多设备协同与云边协同架构。

我的汇报到这里结束，感谢各位老师聆听，请批评指正。

---

## 三、答辩问答预判（高频问题 + 标准答案）

### （一）基础概念类

**Q1：为什么选STM32F103RCT6，而不是更高性能芯片？**  
A：本课题目标是本科毕设尺度下的可实现与可复现。F103资源足够覆盖本系统的传感采集、联动控制、通信和存储需求，成本低、资料成熟、调试链完善，更符合工程性与教学目标。

**Q2：你的系统核心控制思想是什么？**  
A：核心是“本地自治闭环优先，远程协同增强”。即使断网，本地门禁、入侵告警、燃气应急仍能执行，远程功能作为增强而非依赖项。

**Q3：测控专业视角下，你的“测”与“控”分别体现在哪？**  
A：“测”体现在多传感器采集、标定、滤波和统计分析；“控”体现在状态机决策、执行器联动、异常降级与恢复机制。

**Q4：为什么要做标准化测试用例？**  
A：为了保证结果可追溯、可复现实验条件一致，也便于答辩时证明“不是偶然成功”，而是按统一判定标准达标。

### （二）硬件设计类

**Q5：ESP-01S为什么用USART3并单独EN控制？**  
A：按板级资源分配，USART3的PB10/PB11不与关键并口冲突；EN(PC9)可实现模块硬复位和上电控制，提升联网调试成功率和故障恢复能力。

**Q6：SD卡为什么采用SPI2？**  
A：SPI2走PB13/14/15，CS为PB12，布线和资源占用更合理；配合FatFs实现抓拍BMP落盘与容量统计，满足存储需求且开发复杂度可控。

**Q7：蜂鸣器驱动为何用三极管方案？**  
A：MCU GPIO驱动能力有限，直接驱动蜂鸣器/执行器存在风险。三极管驱动可提供足够电流并保护IO口，电路更稳定。

**Q8：电源模块与功耗测试如何对齐？**  
A：已建立电源分配与电流预算表，并用第6章功耗实测（420mW/980mW）按P=UI换算输入等效电流，验证预算有余量，前后逻辑一致。

### （三）软件实现类

**Q9：你为什么同时保留裸机和FreeRTOS两种路径？**  
A：裸机适合快速联调和故障定位；RTOS适合完整并发业务。双路径降低开发风险，也便于在不同阶段切换重点。

**Q10：任务优先级是如何确定的？**  
A：以安全关键路径优先：告警/应急任务高于网络与日志任务。原则是“影响人身与财产安全的动作优先执行”。

**Q11：如何避免并发下共享资源冲突？**  
A：采用队列、事件组、互斥锁，ISR只做事件置位，复杂处理下沉到任务，减少死锁和优先级反转风险。

**Q12：联网不稳定时怎么保证可用性？**  
A：本地链路独立运行；网络侧采用重连、重传、状态回执与幂等策略，断网恢复后可补传关键状态。

### （四）测试验证类

**Q13：你的测试数据可信度怎么保证？**  
A：统一测试环境、固定固件版本、重复试验（30/50/100次级别）、记录原始日志，并给出均值、标准差、P95和置信区间。

**Q14：为什么要做异常工况测试？**  
A：安防系统必须验证边界条件。断网、故障、电源扰动、EMI场景比“正常场景”更能说明工程可靠性。

**Q15：误报率3.2%是否足够好？**  
A：对本科毕设级系统已达到目标（≤5%）。同时我给出了置信区间和优化路径，说明结果不仅“达标”，还具备改进方向。

**Q16：远程时延1850ms偏大，怎么解释？**  
A：主要受无线链路波动和云端转发影响。本地闭环时延更低（620ms），证明核心控制瓶颈不在本地算法，而在网络链路。

### （五）创新与拓展类

**Q17：与常见智能家居方案相比，你的创新点在哪？**  
A：不是单点功能展示，而是多传感+多执行器+通信+测试的完整闭环；并且强调本地自治，弱网下仍可运行。

**Q18：如果继续做，你最优先改哪块？**  
A：优先优化通信长尾时延（连接保持+分级重传+消息队列优先级），其次做融合算法升级降低误报。

**Q19：系统可扩展性如何？**  
A：分层架构和接口抽象已建立，新增传感器或替换通信模块只需在驱动层和映射层扩展，上层业务改动小。

**Q20：工程落地价值是什么？**  
A：该方案成本可控、模块通用、测试流程可复用，适合作为低成本家庭安防原型和后续课程/项目迭代基线。

---

## 四、一键转PPT分栏版（15页可直接复制）

> 用法建议：每页保留“标题 + 3~5条”，图放右侧或下方；文字不超过6行，口头补充细节。

### 第1页 封面
- 家用安防与智能家居联动系统设计与实现
- 学生姓名 / 学号 / 专业班级
- 指导教师
- 广东工业大学 本科毕业设计答辩

### 第2页 研究背景与问题定义
- 家庭场景风险：门禁失效、入侵、燃气泄漏、环境异常
- 现有方案痛点：成本高、部署复杂、联动不足
- 研究目标：低成本、可实现、可复现、可验证

### 第3页 研究目标与指标
- 功能目标：检测-判定-执行-反馈闭环
- 指标目标：准确率、误报率、时延、功耗、稳定性
- 结果导向：全部指标与测试章节逐项对齐

### 第4页 系统总体架构
- 四层架构：感知层/控制层/通信层/应用层
- 本地自治优先，远程协同增强
- 单芯片集中控制，降低系统复杂度

### 第5页 硬件总体方案
- 主控：STM32F103RCT6
- 传感：AS608、PIR、DHT、MQ-2、OV7670+FIFO
- 执行：门锁、燃气阀、蜂鸣器；存储：SD；通信：ESP-01S

### 第6页 关键硬件实现（感知链路）
- DHT/MQ-2/PIR接入与信号调理
- MQ-2 ADC采样与滤波，DHT单总线采集
- 抗干扰设计：分区布线、局部去耦、RC抑噪

### 第7页 关键硬件实现（执行与电源）
- 继电器+三极管驱动门锁/阀体/蜂鸣器
- DCP3512四路供电：3.3V/5V/12V/可调路
- 电源预算与第6章功耗测试对齐

### 第8页 软件架构与运行模式
- 双模式：裸机调试 + FreeRTOS运行
- 分层组织：驱动层/服务层/业务层/应用交互层
- 任务划分明确，关键任务优先级更高

### 第9页 核心控制逻辑与状态机
- 门禁状态机：采集、匹配、开锁、锁定
- 入侵与燃气应急状态机：触发、联动、恢复
- 异常处理：超时重试、降级运行、恢复机制

### 第10页 通信与安全机制
- ESP-01S经USART3接入OneNET，MQTT收发
- 设备状态上报与远程控制闭环
- AES-128本地保护，TLS链路扩展能力

### 第11页 传感器标定与数据处理
- DHT22实验室标定：温度/湿度误差收敛
- MQ-2分级标定：ADC到浓度等级映射
- 融合与滤波：降低噪声干扰与误判

### 第12页 测试方法与标准化用例
- 测试层次：单元、联动、性能、稳定性、异常工况
- 用例模板：目的/环境/步骤/预期/实际/判定标准
- 测试环境固定，重复试验保证可比性

### 第13页 测试结果与统计分析
- 识别准确率98.0%，误报率3.2%
- 本地告警时延620ms，远程控制1850ms
- 统计指标：均值、标准差、P95、95%置信区间

### 第14页 创新点与工程价值
- 单芯片多模块联动闭环工程化实现
- 本地自治 + 远程协同并行机制
- 裸机/RTOS双路径提升调试与部署效率
- 标准化测试流程可复用、可迁移

### 第15页 总结与展望
- 已完成从方案到实现到验证的完整闭环
- 指标总体达标，系统具备工程可用性
- 后续方向：弱网时延优化、融合算法升级、多设备协同
- 感谢各位老师，请批评指正
