HJDSS/STM32-SmartHome-Security/论文相关/规范与封面/论文封面.pdf

## 本科毕业设计（论文）

## 家用安防与智能家居联动系统设计

学 | 院： | 机电工程学院
专 | 业： | 测控技术与仪器
年级班别： | 2022 级（2）班
学 | 号： | 3122000256
学生姓名： | 何俊达
指导教师： | 张巧芬

2026 年 4 月

家 用 安 防 与 智 能 家 居 联 动 系 统 设 计 何俊达机电工程学院
