HJDSS/STM32-SmartHome-Security/assets/gdut-name.png

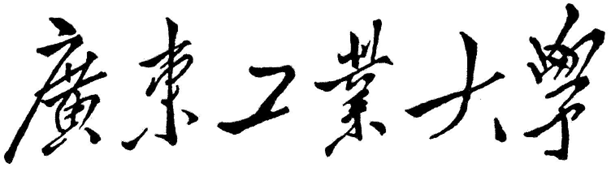
assets/gdut-name.png
