HJDSS/STM32-SmartHome-Security/论文相关/源文件/images/fig4_3_comm_timing.png

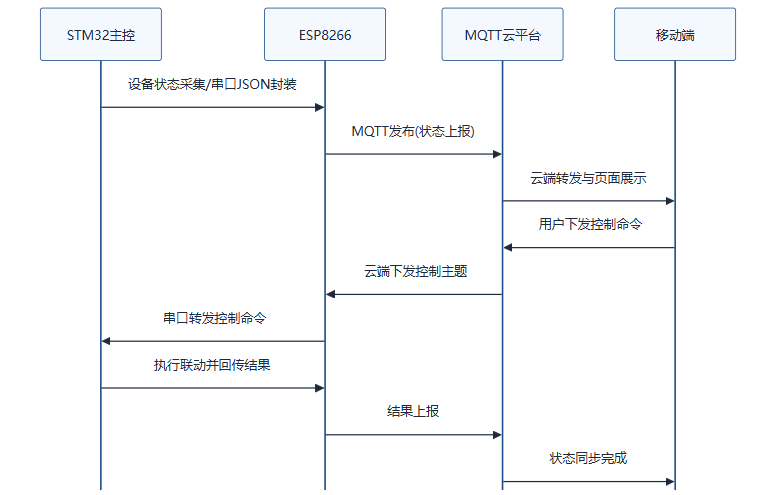
论文相关/源文件/images/fig4_3_comm_timing.png
