HJDSS/STM32-SmartHome-Security/论文相关/源文件/images/fig4_5_task_gantt.png

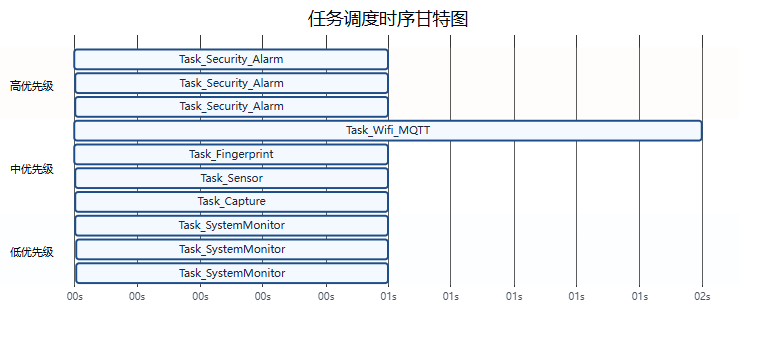
论文相关/源文件/images/fig4_5_task_gantt.png
