HJDSS/STM32-SmartHome-Security/论文相关/源文件/images/fig5_5_remote_control_flow.png

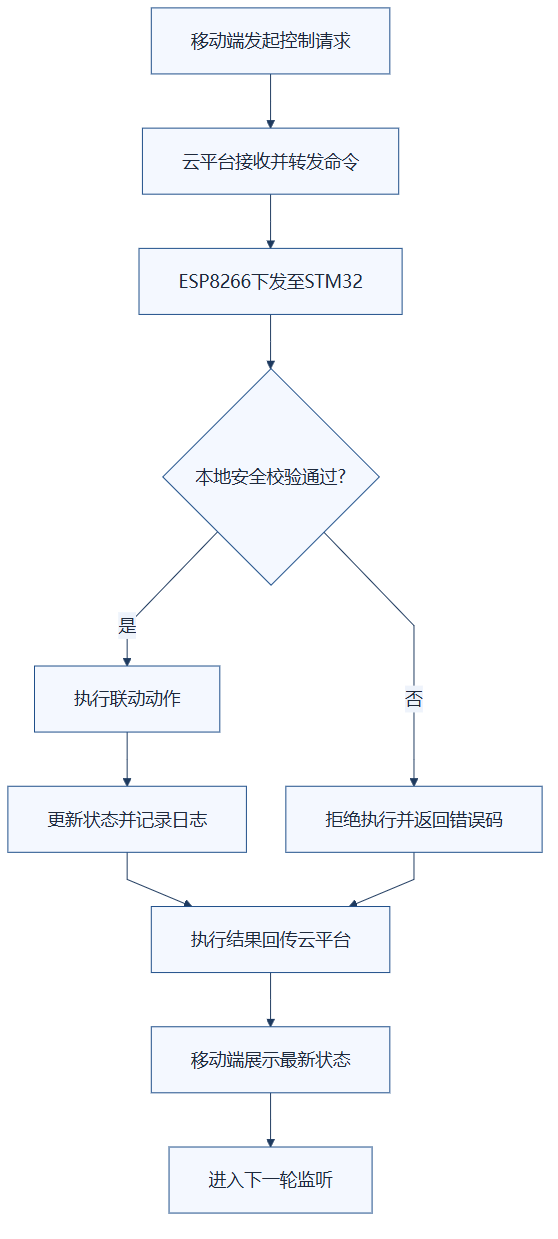
论文相关/源文件/images/fig5_5_remote_control_flow.png
