HJDSS/STM32-SmartHome-Security/论文相关/源文件/images/原理图/sch_as608_arch.png

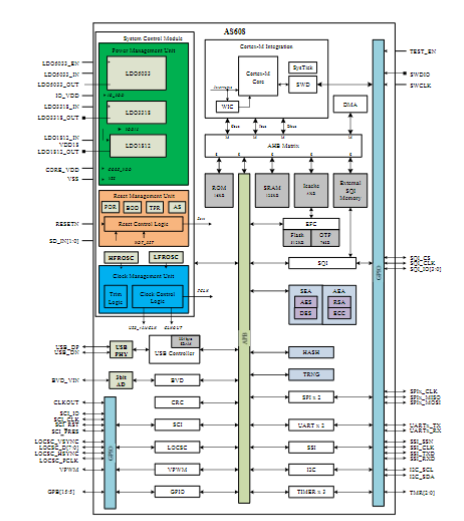
论文相关/源文件/images/原理图/sch_as608_arch.png
