HJDSS/STM32-SmartHome-Security/论文相关/源文件/images/原理图/sch_ov7670_fifo.png

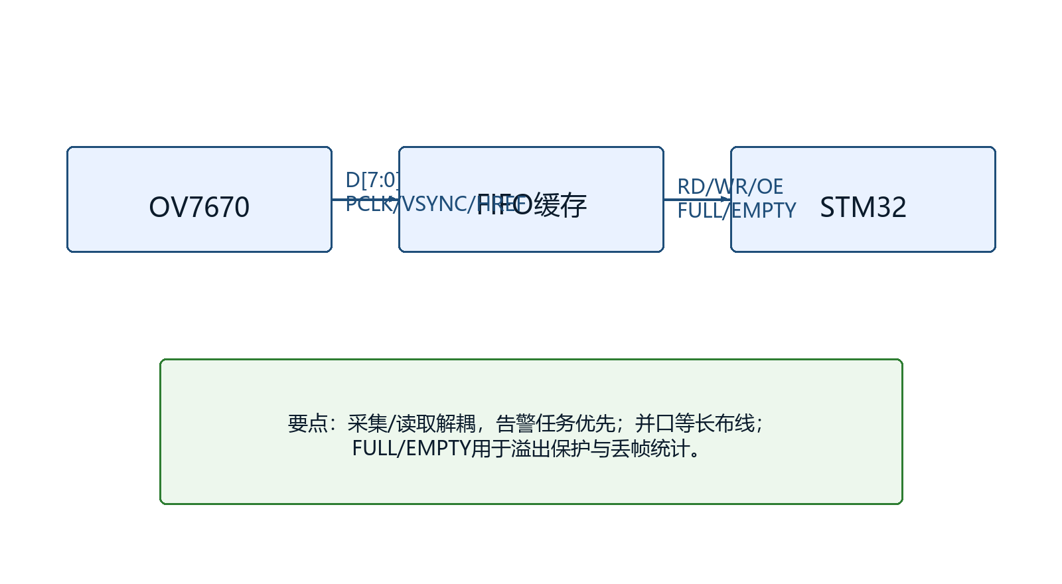
论文相关/源文件/images/原理图/sch_ov7670_fifo.png
