HJDSS/STM32-SmartHome-Security/论文相关/源文件/images/实物图/photo_as608.png

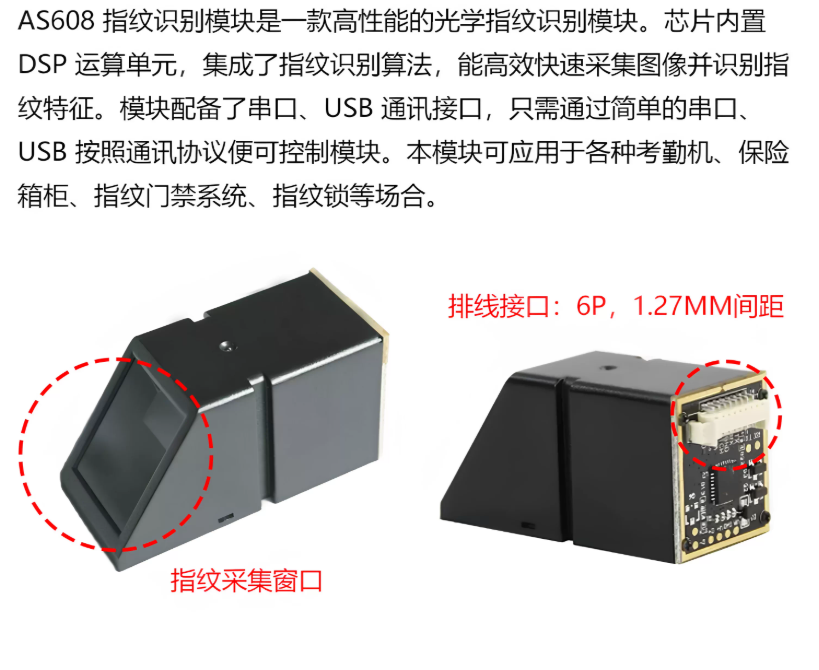
论文相关/源文件/images/实物图/photo_as608.png
