HJDSS/STM32-SmartHome-Security/论文相关/源文件/抓拍.jpg

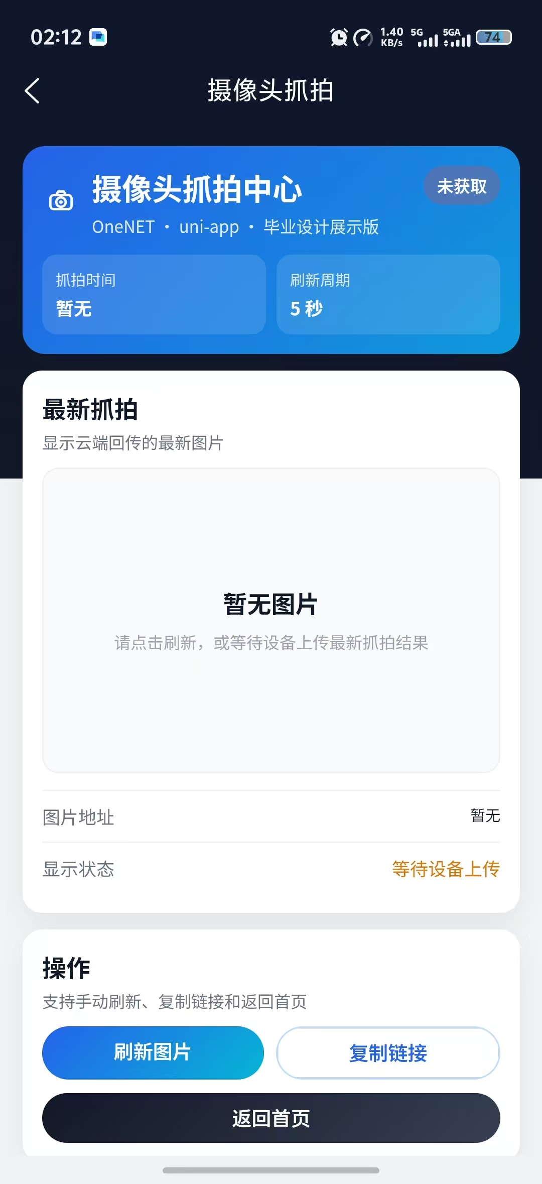
论文相关/源文件/抓拍.jpg
