HJDSS/STM32-SmartHome-Security/论文相关/源文件/首页.jpg

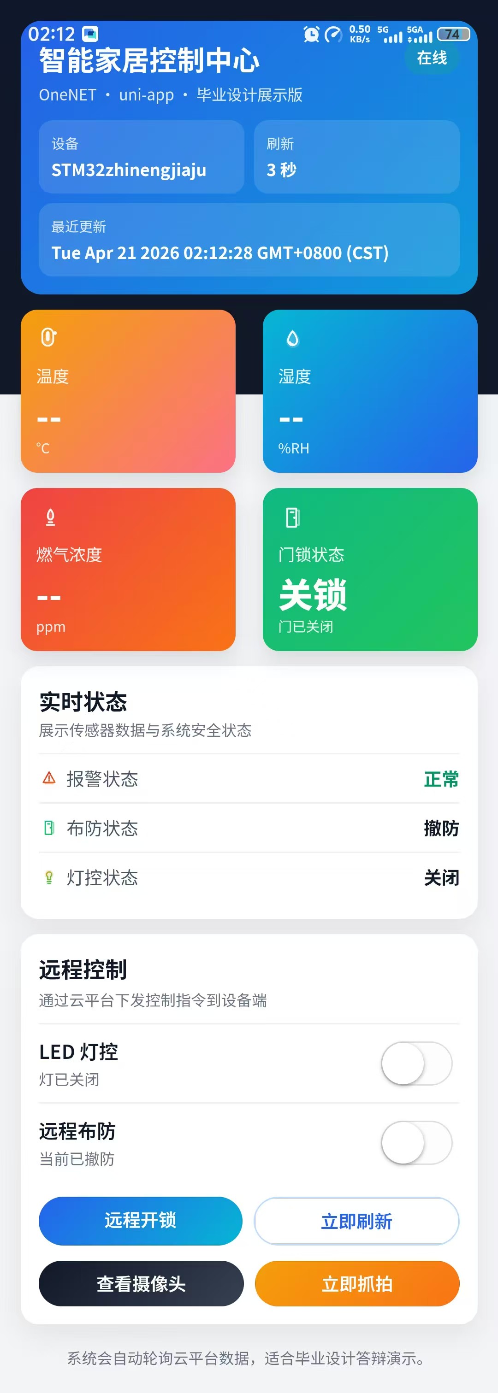
论文相关/源文件/首页.jpg
