HJDSS/STM32-SmartHome-Security/biye/硬件/单芯片STM32F103RCT6智能安防系统_硬件调试Checklist.md

# 单芯片 STM32F103RCT6 智能安防系统 · 硬件调试 Checklist

> **依据**：`代码/User/board_config.h`；与《单芯片STM32F103RCT6智能安防工程重构规范》《工程真实硬件连接表》对照使用。  
> **说明**：勾选框供实机调试时逐项打勾。**SCCB 为 PD2/PB7**，与 OV **OE(PB6)** 无同脚复用；键盘行 **X1~X4=PC0/PC1/PC2/PC3**（**X4 勿用 PC10**，该脚为蜂鸣器，见 **`BOARD_BEEP_ACTIVE_HIGH`**）；列 **Y1/Y2=PC11/PC12**；Y3/Y4 **默认 PB1/PB2**（固件 **`EN_OV7670_LOCAL=1`**）；无摄像头调试时改宏为 **0** 且列改 **PA5/PA6**；**PA13/PA14 仅 SWD**；**蜂鸣器为 PC10**（见《硬件连接方案》§3.7、`BOARD_BEEP_ACTIVE_HIGH`）。

---

## 一、上电前检查（必做）

| 序号 | 检查项 | 要点 | 通过 |
|---|---|---|:----:|
| 1 | 电源极性 / 短路 | 万用表蜂鸣档：3.3V 与 GND 无短路；稳压输出 ≈3.3V | [ ] |
| 2 | 共地 | 外设模块 GND 与 MCU 板 GND 可靠共地 | [ ] |
| 3 | OLED（软件 I2C） | **PB8** = SCL，**PB9** = SDA；多数模块为 3.3V 逻辑 | [ ] |
| 4 | ESP8266 串口 | **PB10** = USART3_TX → 模块 RX；**PB11** = USART3_RX ← 模块 TX；**3.3V TTL**（与 **PA0~PA7** 摄像头并口无共脚） | [ ] |
| 5 | ESP8266 EN | **PC9** 接模块 EN/CH_PD（以 `board_config.h` 为准） | [ ] |
| 6 | AS608 指纹 | **PA9/PA10** = USART1；波特率与固件一致（见下节） | [ ] |
| 7 | PC10 蜂鸣器 | **PC10**；仍无声时试改 **`BOARD_BEEP_ACTIVE_HIGH`** 为 1；键盘 **X4=PC3**；勿与 **PB10**（USART3 TX）混淆 | [ ] |

---

## 二、最小系统 + 烧录 + 串口日志

| 序号 | 检查项 | 要点 | 通过 |
|---|---|---|:----:|
| 1 | SWD | **PA13** SWDIO、**PA14** SWCLK；工程关 JTAG、保留 SWD | [ ] |
| 2 | 电源轨 | 3.3V 稳定，电流余量足够（ESP8266 峰值较大） | [ ] |
| 3 | FreeRTOS | 上电后系统不 HardFault；任务调度正常 | [ ] |
| 4 | USART1 | **57600 8N1**（`main.c` 中 `uart1_Init(57600)`）；接 AS608 时核对模块波特率 | [ ] |
| 5 | 调试输出 | 串口助手可见启动/任务日志；若使用 JSON 调试协议，与上位机约定一致 | [ ] |

---

## 三、外设分步验证

### 3.1 OLED

| 检查项 | 通过 |
|---|:----:|
| 上电后屏能初始化（I2C 地址常见 0x3C/0x3D，以模块丝印为准） | [ ] |
| 能显示菜单/状态，无花屏、全黑（先排除供电与杜邦接触） | [ ] |

### 3.2 矩阵键盘与 SWJ

| 检查项 | 通过 |
|---|:----:|
| 行 **X1~X4=PC0/PC1/PC2/PC3**；列 Y1/Y2=**PC11/PC12**；Y3/Y4=**PB1/PB2**（默认开 OV）；**勿**把键盘接到 PA13/14；**勿**把行线接到 **PC10**（蜂鸣器） | [ ] |
| **关闭 JTAG、保留 SWD**；行列扫描正常 | [ ] |
| 默认启用 OV7670：键盘 **Y3/Y4** 须 **PB1/PB2**（勿用 PA5/6 作列）；SCCB **PD2/PB7** | [ ] |

### 3.3 SD 卡（SPI2）

| 检查项 | 通过 |
|---|:----:|
| **PB12(CS)，PB13/PB14/PB15**；SD_CS 与 OV 控制脚按表分开布线 | [ ] |
| FatFs 挂载、读写小文件成功 | [ ] |

---

## 四、云平台（ESP8266 + OneNET）

| 序号 | 检查项 | 要点 | 通过 |
|---|---|---|:----:|
| 1 | 物理接线 | **USART3** PB10/PB11、**115200**（`USART2_Init_Config(115200)` 内初始化 USART3）；TX/RX 未交叉错接 | [ ] |
| 2 | WiFi | 连接目标热点（如 **`vivo S50`**，以实际 SSID/密码为准） | [ ] |
| 3 | OneNET | AT+MQTT 路径下注册成功、能周期上报物模型（以 `esp8266_onenet_mqtt` / `esp8266_tls` 实际宏为准） | [ ] |

---

## 五、摄像头（OV7670 + FIFO）

| 序号 | 检查项 | 要点 | 通过 |
|---|---|---|:----:|
| 1 | SCCB | 软件 I2C **PD2(SCL)/PB7(SDA)**；PB6 仅 FIFO **OE**；能 **读取传感器 ID** | [ ] |
| 2 | 并行口 | **PA0~PA7** 整组接 OV **D0~D7**（勿将 ESP 接到 PA2/3/4）；**PA11/PA12** 等与 FIFO 控制按《硬件连接方案》接线 | [ ] |
| 3 | 抓拍存 SD | `Task_Capture` 写 BMP 到卡；文件可拷贝到 PC 查看 | [ ] |
| 4 | 图像质量 | 色彩/分辨率正常；异常时先查供电、线长、FIFO 与 RCK | [ ] |

---

## 六、快速排障索引

| 现象 | 建议先查 |
|---|---|
| 下载失败 | SWD 线序、复位脚、BOOT0、驱动 |
| 串口无打印 | USART1 波特率 57600、USB-TTL 地线、是否被 AS608 占用 TX/RX |
| WiFi 不通 | PB10/11、3.3V、EN(PC9)、波特率 115200、天线与供电；勿占用 **PA0~PA7** 作串口 |
| OLED 不亮 | PB8/9、上拉、I2C 地址、3.3V |
| 键盘失灵 | 四行是否 **PC0/1/2/3**（**R4→PC3**）、Y1/Y2 **PC11/12**、Y3/Y4 **PB1/2**（默认）或关 OV 时 PA5/6；是否误接 **PC10**（蜂鸣器）；AFIO/SWJ、行列是否短路 |
| 摄像头异常 | SCCB ID、分时复用、与 SD/OV 脚冲突 |

---

*文档版本：与当前 `board_config.h`、`硬件连接方案.md`（2026-04：键盘 X4=PC3、ESP8266 USART3+PC9、蜂鸣器 PC10）同步；若改脚位请先改源码再更新本清单。*
