HJDSS/STM32-SmartHome-Security/(list of files, drawings)

Other design files:
biye/硬件/Project Backups/新工程 [20260301, 18-22-14].pdsprj
biye/硬件/Project Backups/新工程 [20260408, 02-15-24].pdsprj
biye/硬件/Project Backups/新工程 [20260408, 03-51-16].pdsprj
biye/硬件/新工程.pdsprj
