HJDSS/STM32-SmartHome-Security/biye/代码/Driver/ov7670cfg_qvga_rgb565.c

#include "ov7670cfg_qvga_rgb565.h"

const u8 ov7670_init_reg_tbl[][2]=
{
	/* === 基础时序（原有 20 条，勿改） === */
	{0x3a, 0x04},
	{0x40, 0xd0},
	{0x12, 0x14},
	{0x32, 0x80},
	{0x17, 0x16},
	{0x18, 0x04},
	{0x19, 0x02},
	{0x1a, 0x7b},
	{0x03, 0x06},
	{0x0c, 0x00},
	{0x15, 0x00},
	{0x3e, 0x00},
	{0x70, 0x3a},
	{0x71, 0x35},
	{0x72, 0x11},
	{0x73, 0x00},
	{0xa2, 0x02},
	{0x11, 0x00},
	{0x6b, 0x60},
	{0x13, 0xe7},

	/* === AEC 自动曝光微调 === */
	{0x14, 0x18},   /* COM9: AGC上限16x，不冻结 */
	{0x24, 0x95},   /* AEC低限 */
	{0x25, 0x33},   /* AEC高限 */
	{0x26, 0xe3},   /* AEC 50Hz消隐滤波 */
	{0xa5, 0x05},   /* 50Hz消隐步长 */
	{0xab, 0x07},   /* 60Hz消隐步长 */
	{0x2a, 0x00},   /* EXHCH: 曝光高字节 */
	{0x2b, 0x00},   /* EXHCL: 曝光低字节 */

	/* === AGC 自动增益微调 === */
	{0x69, 0x00},   /* GFIX: 关闭固定增益 */
	{0x6a, 0x40},   /* GGAIN: 全局增益默认 */

	/* === AWB 自动白平衡微调 === */
	{0x43, 0x0a},   /* COM17: AWB增益使能 */
	{0x6c, 0x0a},   /* AWBC1: AWB低限 */
	{0x6d, 0x55},   /* AWBC2: AWB高限 */
	{0x6e, 0x11},   /* AWBC3: AWB速度 */
	{0x6f, 0x9f},   /* AWBC4: AWB阈值 */

	/* === 色彩矩阵 RGB565 色彩校正 === */
	{0x4f, 0x80},   /* MTX1: R中R分量 */
	{0x50, 0x80},   /* MTX2: R中G分量 */
	{0x51, 0x00},   /* MTX3: R中B分量 */
	{0x52, 0x22},   /* MTX4: G中R分量 */
	{0x53, 0x5e},   /* MTX5: G中G分量 */
	{0x54, 0x80},   /* MTX6: G中B分量 */
	{0x58, 0x9e},   /* MTXS: 矩阵符号 */

	/* === 亮度/对比度 === */
	{0x55, 0x00},   /* BRIGHT: 亮度 (0x00=默认) */
	{0x56, 0x40},   /* CONTRAS: 对比度 (0x40=默认) */
	{0x57, 0x00},   /* CONTRAS_CENTER */

	/* === 伽马曲线 16 点（改善对比度与暗部细节） === */
	{0x7a, 0x20},   /* SLOP: 伽马斜率 */
	{0x7b, 0x10},   /* GAM1 */
	{0x7c, 0x1e},   /* GAM2 */
	{0x7d, 0x35},   /* GAM3 */
	{0x7e, 0x5a},   /* GAM4 */
	{0x7f, 0x69},   /* GAM5 */
	{0x80, 0x76},   /* GAM6 */
	{0x81, 0x80},   /* GAM7 */
	{0x82, 0x88},   /* GAM8 */
	{0x83, 0x8f},   /* GAM9 */
	{0x84, 0x96},   /* GAM10 */
	{0x85, 0xa3},   /* GAM11 */
	{0x86, 0xaf},   /* GAM12 */
	{0x87, 0xc4},   /* GAM13 */
	{0x88, 0xd7},   /* GAM14 */
	{0x89, 0xe8},   /* GAM15 */

	/* === DSP 控制: 启用伽马+矩阵+去噪+边缘增强 === */
	{0x3d, 0xc0},   /* COM13: gamma+matrix使能, UV自动调整 */
	{0x3f, 0x00},   /* EDGE: 边缘增强系数 */
	{0x75, 0x05},   /* DNSTH: 去噪阈值 */
	{0x76, 0xe1},   /* 矩阵系数符号+调整 */

	/* === 镜像/翻转 方向校正 === */
	{0x1e, 0x07},   /* MVFP: 水平镜像+垂直翻转(bottom-up BMP) */

	/* === 镜头阴影校正（减轻暗角） === */
	{0x77, 0x01},   /* LCC1: 镜头校正使能 */
	{0x78, 0x80},   /* LCC2 */
	{0x79, 0x80},   /* LCC3 */
	{0x90, 0x00},   /* LCC4 */
	{0x91, 0x00},   /* LCC5 */

	/* === 噪声抑制 === */
	{0x92, 0x00},   /* DM_LNL: 行噪声下限 */
	{0x93, 0x00},   /* DM_LNH: 行噪声上限 */
	{0x94, 0x88},   /* LCC6 */
	{0x95, 0x88},   /* LCC7 */

	/* === COM4-6 保留配置 === */
	{0x0d, 0x08},   /* COM4 */
	{0x0e, 0x61},   /* COM5 */
	{0x0f, 0x4b},   /* COM6: HREF选项 */

	/* === 模拟处理链 推荐保留值 === */
	{0x30, 0x00},   /* Reserved */
	{0x31, 0x00},   /* Reserved */
	{0x33, 0x0b},   /* CHLF: 电流/亮度 */
	{0x34, 0x0f},   /* ARBLM: 阵列偏置 */
	{0x35, 0x0b},   /* RSVD */
	{0x36, 0x0b},   /* RSVD */
	{0x37, 0x19},   /* ADC: ADC控制 */
	{0x38, 0x07},   /* ACOM: ADC共模 */
	{0x39, 0x0a},   /* OFON: ADC偏移 */
	{0x3c, 0x00},   /* COM12 */
	{0x42, 0x0f},   /* COM16: 关彩条 */
	{0x44, 0x11},   /* RSVD */
	{0x45, 0x00},   /* RSVD */
	{0x46, 0x00},   /* RSVD */
	{0x47, 0x00},   /* RSVD */
	{0x48, 0x00},   /* RSVD */
	{0x49, 0x00},   /* RSVD */
	{0x4a, 0x00},   /* RSVD */
	{0x4b, 0x09},   /* NDLG: 噪声 */
	{0x4c, 0x0f},   /* RSVD */
	{0x4d, 0x40},   /* RSVD */
	{0x4e, 0x20},   /* RSVD */
	{0x59, 0x88},   /* RSVD */
	{0x5a, 0x88},   /* RSVD */
	{0x5b, 0x44},   /* RSVD */
	{0x5c, 0x67},   /* RSVD */
	{0x5d, 0x49},   /* RSVD */
	{0x5e, 0x0e},   /* RSVD */
	{0x9a, 0x00},   /* RSVD */
	{0x9b, 0x00},   /* RSVD */
	{0x9c, 0x00},   /* RSVD */
	{0x9d, 0x40},   /* RSVD */
	{0x9e, 0x30},   /* RSVD */
	{0xa6, 0x02},   /* RSVD */
	{0xb0, 0x84},   /* RSVD */
};
