HJDSS/STM32-SmartHome-Security/biye/代码/Driver/hc_sr501.c

#include "hc_sr501.h"
#include "delay.h"
#include "app_params.h"
/* EXTI 结构体/宏定义来自 stm32f10x_exti.h（Keil C89/老版库需显式 include） */
#include "stm32f10x_exti.h"

#if USE_FREERTOS
#include "FreeRTOS.h"
#include "task.h"
#include "app_rtos.h"
#endif

volatile u8 g_hc_sr501_irq_flag = 0;
volatile u8 g_pir_debounce_ms = APP_PIR_DEBOUNCE_DEFAULT;  /* 🟡13: 运行时可调 */

/* 🟡11: 三段式误触发抑制状态 */
static uint32_t s_pir_glitch_since_ms = 0u;
static uint32_t s_pir_lockout_until_ms = 0u;
static u8 s_pir_in_glitch = 0u;

void HC_SR501_Init(void)
{
    GPIO_InitTypeDef GPIO_InitStructure;

    RCC_APB2PeriphClockCmd(HC_SR501_GPIO_CLK | RCC_APB2Periph_AFIO, ENABLE);

    GPIO_InitStructure.GPIO_Pin = HC_SR501_GPIO_PIN;
    GPIO_InitStructure.GPIO_Mode = GPIO_Mode_IPD;
    GPIO_InitStructure.GPIO_Speed = GPIO_Speed_50MHz;
    GPIO_Init(HC_SR501_GPIO_PORT, &GPIO_InitStructure);
}

void HC_SR501_EXTI_Init(void)
{
    EXTI_InitTypeDef EXTI_InitStructure;
    NVIC_InitTypeDef NVIC_InitStructure;

    GPIO_EXTILineConfig(HC_SR501_GPIO_PORT_SOURCE, HC_SR501_GPIO_PIN_SOURCE);

    EXTI_InitStructure.EXTI_Line = HC_SR501_EXTI_LINE;
    EXTI_InitStructure.EXTI_LineCmd = ENABLE;
    EXTI_InitStructure.EXTI_Mode = EXTI_Mode_Interrupt;
    if(HC_SR501_TRIGGER_LEVEL)
    {
        EXTI_InitStructure.EXTI_Trigger = EXTI_Trigger_Rising;
    }
    else
    {
        EXTI_InitStructure.EXTI_Trigger = EXTI_Trigger_Falling;
    }
    EXTI_Init(&EXTI_InitStructure);

    NVIC_InitStructure.NVIC_IRQChannel = HC_SR501_EXTI_IRQ;
    NVIC_InitStructure.NVIC_IRQChannelPreemptionPriority = HC_SR501_EXTI_PREEMPT_PRIO;
    NVIC_InitStructure.NVIC_IRQChannelSubPriority = HC_SR501_EXTI_SUB_PRIO;
    NVIC_InitStructure.NVIC_IRQChannelCmd = ENABLE;
    NVIC_Init(&NVIC_InitStructure);
}

u8 HC_SR501_Read_Level(void)
{
    return GPIO_ReadInputDataBit(HC_SR501_GPIO_PORT, HC_SR501_GPIO_PIN);
}

u8 HC_SR501_Poll_Triggered(void)
{
    static uint32_t s_pir_high_start_ms = 0u;
    u8 level = HC_SR501_Read_Level();

    if(level == HC_SR501_TRIGGER_LEVEL)
    {
        if(s_pir_high_start_ms == 0u)
        {
            s_pir_high_start_ms = Bare_GetTickMs();
        }
        if((u32)(Bare_GetTickMs() - s_pir_high_start_ms) >= (u32)g_pir_debounce_ms)
        {
            return 1;
        }
    }
    else
    {
        s_pir_high_start_ms = 0u;
    }
    return 0;
}

/* 🟡11: 三段式误触发抑制 — 论文 §4.2 */
u8 HC_SR501_IsValidTrigger(uint32_t now_ms)
{
    u8 level = HC_SR501_Poll_Triggered();

    /* Stage 3: 冷却锁定期内忽略所有触发 */
    if (s_pir_lockout_until_ms != 0u)
    {
        if (now_ms < s_pir_lockout_until_ms)
            return 0u;
        s_pir_lockout_until_ms = 0u;
    }

    if (level)
    {
        if (!s_pir_in_glitch)
        {
            s_pir_in_glitch = 1u;
            s_pir_glitch_since_ms = now_ms;
        }
        /* Stage 1+2: 毛刺抑制+最小有效脉宽 — 高电平需持续≥60+200ms */
        if ((now_ms - s_pir_glitch_since_ms) >= (APP_PIR_GLITCH_REJECT_MS + APP_PIR_MIN_ACTIVE_MS))
        {
            s_pir_in_glitch = 0u;
            s_pir_lockout_until_ms = now_ms + APP_PIR_LOCKOUT_MS;
            return 1u;  /* 有效触发 */
        }
    }
    else
    {
        s_pir_in_glitch = 0u;
    }

    return 0u;
}

u8 HC_SR501_IRQHandler_GetFlag(void)
{
    return g_hc_sr501_irq_flag;
}

void HC_SR501_IRQHandler_ClearFlag(void)
{
    g_hc_sr501_irq_flag = 0;
}

/* 中断入口：本工程 PIR 固定使用 PC4 -> EXTI4 */
void EXTI4_IRQHandler(void)
{
    if(EXTI_GetITStatus(HC_SR501_EXTI_LINE) != RESET)
    {
        g_hc_sr501_irq_flag = 1;
#if USE_FREERTOS
        {
            BaseType_t xHigherPriorityTaskWoken = pdFALSE;
            IPC_NotifyPIR_FromISR(&xHigherPriorityTaskWoken);
            portYIELD_FROM_ISR(xHigherPriorityTaskWoken);
        }
#endif
        EXTI_ClearITPendingBit(HC_SR501_EXTI_LINE);
    }
}
