HJDSS/STM32-SmartHome-Security/biye/代码/Driver/spi.c

#include "spi.h"

u8 SPI_WriteByte(SPI_TypeDef* SPIx,u8 Byte)
{
	while((SPIx->SR&SPI_I2S_FLAG_TXE)==RESET);
	SPIx->DR=Byte;
	while((SPIx->SR&SPI_I2S_FLAG_RXNE)==RESET);
	return SPIx->DR;
}

/* SpeedSet: 0=APB1/32 1=APB1/2 2=APB1/128（仅 SD 初始化前几步，最保守） */
void SPI_SetSpeed(SPI_TypeDef* SPIx,u8 SpeedSet)
{
	SPIx->CR1&=0XFFC7;
	if(SpeedSet==1)
	{
		SPIx->CR1|=SPI_BaudRatePrescaler_2;
	}
	else if(SpeedSet==2)
	{
		SPIx->CR1|=SPI_BaudRatePrescaler_128;
	}
	else
	{
		SPIx->CR1|=SPI_BaudRatePrescaler_32;
	}
	SPIx->CR1|=1<<6;
}

void SPI2_Init(void)
{
	SPI_InitTypeDef  SPI_InitStructure;
	GPIO_InitTypeDef GPIO_InitStructure;

	RCC_APB2PeriphClockCmd(RCC_APB2Periph_AFIO|RCC_APB2Periph_GPIOB, ENABLE);
	GPIO_InitStructure.GPIO_Pin = GPIO_Pin_13 | GPIO_Pin_15;
	GPIO_InitStructure.GPIO_Speed = GPIO_Speed_50MHz;
	GPIO_InitStructure.GPIO_Mode = GPIO_Mode_AF_PP;
	GPIO_Init(GPIOB, &GPIO_InitStructure);

	GPIO_InitStructure.GPIO_Pin =  GPIO_Pin_14;
	GPIO_InitStructure.GPIO_Mode = GPIO_Mode_IPU;
	GPIO_InitStructure.GPIO_Speed = GPIO_Speed_50MHz;
	GPIO_Init(GPIOB, &GPIO_InitStructure);

	RCC_APB1PeriphClockCmd(RCC_APB1Periph_SPI2 ,ENABLE);

	SPI_InitStructure.SPI_Direction = SPI_Direction_2Lines_FullDuplex;
	SPI_InitStructure.SPI_Mode = SPI_Mode_Master;
	SPI_InitStructure.SPI_DataSize = SPI_DataSize_8b;
	SPI_InitStructure.SPI_CPOL = SPI_CPOL_Low;
	SPI_InitStructure.SPI_CPHA = SPI_CPHA_1Edge;
	SPI_InitStructure.SPI_NSS = SPI_NSS_Soft;
	SPI_InitStructure.SPI_BaudRatePrescaler = SPI_BaudRatePrescaler_32;
	SPI_InitStructure.SPI_FirstBit = SPI_FirstBit_MSB;
	SPI_InitStructure.SPI_CRCPolynomial = 7;
	SPI_Init(SPI2, &SPI_InitStructure);

	SPI_Cmd(SPI2, ENABLE);
}
