HJDSS/STM32-SmartHome-Security/biye/代码/Driver/usart2.h

#ifndef __USART_H
#define __USART_H

#include "stm32f10x.h"

#define USART1_REC_MAXLEN 200


/* Uart2_Buf 由 USART3_IRQHandler 写入（ESP 使用 USART3 PB10/11） */
extern char Uart2_Buf[];
void CLR_Buf2(void);
u8 Find2(char *a);

void USART2_Init_Config(u32 bound);
void UART2_SendString(char* s);

void UART2_SendLR(void);
void UART2_Send_Command(char* s);
u8 UART2_Send_AT_Command(char *b,char *a,u8 wait_time,u32 interval_time);
void UART2_Send_Command_END(char* s); 
u8 UART2_Send_AT_Command_End(char *b,char *a,u8 wait_time,u32 interval_time);



#define UART2_SendLR() UART2_SendString("\r\n")
//											

/* ====== 兼容别名：实际硬件为 USART3（PB10/PB11），历史命名为 UART2_* ====== */
#define USART3_Init_Config      USART2_Init_Config
#define UART3_SendString        UART2_SendString
#define UART3_Send_Command      UART2_Send_Command
#define UART3_Send_AT_Command   UART2_Send_AT_Command
#define UART3_Send_Command_END  UART2_Send_Command_END
#define UART3_Send_AT_Command_End UART2_Send_AT_Command_End
/* 新代码请使用 USART3_* / UART3_* 命名，旧 UART2_* 名称保留以兼容现有调用方 */
#endif
