HJDSS/STM32-SmartHome-Security/(commit log)

2026-04-21 feat(core): restore bare-metal main loop and reconnect P0 runtime chain
    Rebuild main runtime flow to wire ESP init/polling, sensor sampling, alarm linkage, capture trigger, and required global symbols for thesis-aligned bring-up.
    Made-with: Cursor
2026-04-21 fix(esp): align ESP-01S USART3 link and non-blocking OneNET init flow
    Align ESP boot/AT/WiFi/MQTT path with board_config pin facts and add cooperative non-blocking init/polling behavior for reconnect-safe runtime.
    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
    [board_config.h, esp8266_onenet_mqtt.c, esp8266_onenet_mqtt.h, esp8266_tls.c, esp8266_tls.h, usart2.c, usart2.h, usart3.c]
2026-04-21 feat(sd): align SPI2 SD path and local capture persistence flow
    Add SD SPI2/FatFs path and capture-to-BMP local retention modules, including mount-gated write flow and storage status interfaces for upload/reporting linkage.
    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
2026-04-21 feat(sensor): align DHT/MQ2/PIR sampling and alarm state integration
    Add board_config-aligned sensor drivers and dashboard state wiring for DHT, MQ2 and PIR so fault/alarm paths can be consistently handled in bare-metal polling.
    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
2026-04-21 feat(actuator): align lock/valve/beep safety control and linkage hooks
    Wire actuator control modules to board_config-safe pins and integrate lock timing/linkage paths so alarm actions remain available while preserving default safe-state behavior.
    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
2026-04-21 feat(abnormal): add offline resilience, reconnect telemetry and cmd dedup
    Keep security loop running during network faults, log offline/recover transitions, and deduplicate downlink commands by cmdId+ts to avoid repeated execution after reconnect.
    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
    [esp8266_tls.c, main.c]
2026-04-21 feat(capture): add SD retention upload and offline replay queue
    Keep every snapshot on SD, publish capture metadata when online, and defer records into a bounded local queue for replay after reconnect without blocking local alarm flow.
    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
2026-04-21 fix(build): resolve link blockers and stabilize post-build artifact detection
    Add missing project source entries and runtime symbols required by the current main flow, and update verification script artifact discovery to work reliably with localized file names.
    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
    [app_types.h, as608.c, as608.h, flash_store.c, flash_store.h, keyboard_sm.c, keyboard_sm.h, lock_manager.c]
2026-04-21 feat(reliability): enforce actuator safe-state and add runtime thesis counters
    Initialize lock/valve/beep into safe defaults and add periodic runtime counters for false alarms, reconnects, deferred replay and SD write failures to support chapter-6 test evidence.
    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
    [Capture.c, gpio.c, gpio.h, main.c]
2026-04-22 chore(baseline): add Driver layer sources
    Add baseline driver sources required for the full hardware interface stack (keys, OLED, OV7670 FIFO, SCCB, flash, etc.).
    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
2026-04-22 chore(baseline): add CMSIS and STM32 SPL libraries
    Add baseline CMSIS startup and STM32F10x Standard Peripheral Library sources to make firmware builds fully reproducible.
    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
2026-04-22 docs(baseline): add usage guides and hardware wiring notes
    Add baseline documentation for wiring, usage, and project overview to support thesis alignment and acceptance.
    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
    [新工程 [20260301, 18-22-14].pdsprj, 新工程 [20260408, 02-15-24].pdsprj, 新工程 [20260408, 03-51-16].pdsprj, 新工程.pdsprj]
2026-04-22 chore(baseline): add thesis materials bundle
    Add baseline thesis-related documents (PPT/PDF/notes) for delivery completeness.
    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
2026-04-22 chore: add PowerShell smart build script
    Avoid PowerShell quoting issues by using a dedicated script for Keil build + log-on-fail + verify-on-success.
    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
2026-04-22 feat(sensor): add DHT backoff recovery and MQ2 anomaly guard
    Mark DHT offline only after consecutive failures with exponential retry backoff, and suppress MQ2 emergency actions while sensor readings are stuck/abnormal until recovery.
    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
    [main.c]
2026-04-22 feat(capture): improve SD mount and capture retention observability
    Add explicit SD mount and capture start/end logs, and fix offline replay success logging to avoid queue index drift after dequeue.
    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
    [Capture.c]
2026-04-22 M1: board_config.h 默认恢复全功能 + 后续模块预留宏
    - DEBUG_PASSWORD_ONLY 默认 1 → 0，全功能裸机成为出厂默认
    （需要密码调试时仍可通过 -D 或顶部 #define 覆盖回 1）
    - BOARD_MQ2_ALARM_ENABLE 默认 0 → 1；DEBUG_PASSWORD_ONLY 下的强制 0 override 保留
    - 文件末尾新增 [M1 增补] 段，统一声明后续模块宏（#ifndef 保护，不影响现有代码）：
    * M2 IWDG：BOARD_IWDG_ENABLE / TIMEOUT_MS / WATCH_SRC_MAX
    * M3 FreeRTOS 六任务表：优先级 5/4/3/3/2/1，栈深 512/640/512/384/768/320 Word，
    周期 50/100/50/200/N-A/2000 ms，以及 IPC 队列深度
    * M4 PIR 三段式抑制：毛刺 60ms / 最小持续 200ms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
2026-04-22 M1.5: app_init 结尾先画一次初始仪表盘，避免首次联网阻塞时误以为死机
    现象：M1 打开全功能默认后，用户看到 OLED 停留在上电自检页（PANEL:SSD1306
    / OFF:00 / R127 EDGE / F123456789ABCDE）30+ 秒不变。
    根因：ESP8266_OneNET_InitFsm_Poll 虽名为"非阻塞 FSM"，但 case 40 调用的
    ESP8266_Connect_WiFi() 是同步阻塞，内部 AT+CWMODE/CWJAP/CIFSR 等
    SendWait 超时合计可达 10~45 秒；首次入网期间主 while(1) 被卡在
    app_poll_net() 内部，OLED_View_RefreshDashboard 无法被调用。
    临时修复：在 app_init() 结尾（SysLog_Add BOOT 之后）先调用一次
    OLED_View_RefreshDashboa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
    [main.c]
2026-04-22 M1.6: 补上 ESP8266 EN(PC9) GPIO 初始化，修复"LED 闪一下就熄"
    现象：烧录 M1.5 后 OLED 正常跑出仪表盘，但 ESP-01S 板上的红灯上电瞬间
    亮一下立刻熄灭，之后始终无响应，随后 FSM 长时间停在 NET:INIT。
    根因：STM32 上电后所有 GPIO 默认是 GPIO_Mode_IN_FLOATING。老代码全程
    没有把 PC9 配成推挽输出，只在 ESP8266_RESET() 里对 PC9 调用
    GPIO_WriteBit —— 只会改 ODR 寄存器但输出驱动器依然关着，PC9
    实际保持高阻浮空。ESP-01S 的 EN/CH_PD 引脚虽然模块 PCB 上有弱
    上拉，但不足以稳定驱动，上电一瞬间 EN 短暂接近 VDD（LED 闪一下）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
    [esp8266_tls.c, esp8266_tls.h, main.c]
2026-04-22 M1.7: OLED 联网诊断页 —— ESP8266 FSM 状态实时显示到顶行
    背景：用户 PA9/PA10 被 AS608 指纹模块占用，没法临时借 USB-TTL 看 USART1
    调试日志；而 ESP8266 进不了 OneNET 时 OLED 只能显示 "NET:INIT"，
    无从定位卡点是 AT 握手失败、WiFi 接入失败还是 MQTT 连接失败。
    修复：把 esp8266_tls.c 里已经完整打点的四个状态变量实时投屏到 OLED 顶行：
    - g_net_stage : 0=IDLE 1=AT 2=WIFI 3=MQTT 4=OK
    - g_wifi_substage : 1=AT 20=CWMODE 21=CWJAP 22=WAIT_IP 23=OK 210=CWLAP
    - g_wifi_err : 0=无 1=找不到SSID 2=信道不支持 3=CWJAP超时 4=CWMODE失败
    - g_wifi_fail_reason: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
    [oled_view.c]
2026-04-22 M1.8: OLED 第3行嵌入 F/T 心跳计数器，定位 main loop 是否活着
    现象：M1.7 部署后用户报告 OLED 顶行永远停在 "NET:IDLE S00 E0"，60s 都
    不见 FSM 进入 AT 握手阶段。
    问题：无法判断到底是
    (A) main 循环根本没跑起来（卡在 app_init 之后第一个 Tick 里）
    (B) main 循环在跑但 SysTick 没在产生 1ms 中断（Bare_GetTickMs 永为 0，
    FSM 里所有 (now - t0 >= N) 都永假）
    (C) main 循环和 SysTick 都正常，ESP8266_OneNET_InitFsm_Poll 本身
    有 bug 走不出 state 0/1/2
    修复：在 OLED_View_RefreshDashboard 里加两个显式心跳量，写到第 3 行右侧。
    - F = s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
    [oled_view.c]
2026-04-22 M1.9: main loop 单环节阻塞探针（OLED 第3行末字母）
    背景：M1.8 的 F/T 计数器显示 F=01 T=166 后完全静止，意味着
    - OLED_View_RefreshDashboard 仅在 app_init 结尾被预刷一次
    - while(1) 第一圈根本没走到 OLED 刷新这一行
    - app_init 阶段 SysTick 已跑到 16.6s，证明 SysTick 本身是活的
    - 卡点一定在 main loop 从 KeyboardSM_Tick 到 OLED_View_RefreshDashboard
    之间的 8+1 个环节里的某一个
    修复：在每个环节前把单字母写到 OLED 第 3 行最后一格（x=120,y=48）。
    正常情况 OLED_View_RefreshDashboard 会整行覆盖那个格子，
    所以看不到持续字母；异常卡死时 OLED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
    [main.c]
2026-04-22 M1.10: 修复 DHT11 关中断死循环 + OLED 面板改 SH1106
    ====== 主修复：DHT11_Read_Byte 无超时死循环 ======
    现象：M1.8 心跳计数器显示 F=01 T=166 完全静止。根据
    "只进过一次 OLED 预刷 + SysTick 也冻结" 的组合，推断主循环
    卡在了 app_poll_sensors，并且把 SysTick 中断也关掉了。
    根因：Driver/dht11.c 里 DHT11_Read_Byte() 内两个等边沿的 while 循环
    完全没有超时：
    while(DHT11_DQ_IN == 0) { delay_us(1); } /* 永远等低→高 */
    while(DHT11_DQ_IN == 1) { delay_us(1); } /* 永远等高→低 */
    而调用它的 DHT11_Read_Data 已经提前做了
    DHT11_EnterCritic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
    [board_config.h, dht11.c]
2026-04-22 M1.11: MQTT 子阶段 + 失败代码暴露到 OLED，定位 "NET:ERR MQTT" 死在哪步
    背景：M1.10 之后 WiFi 已能连上（NET 从 IDLE→AT→WIFI→MQTT 正常推进），
    但 MQTT 建链失败，OLED 显示 "NET:ERR MQTT" 后 ESP8266_RESET 重来，
    一直稳定不了。原 OLED 只告知"MQTT 失败"，看不出是 MQTTCLEAN /
    MQTTUSERCFG / MQTTCONN / MQTTSUB 哪一步，也看不出是 AT 固件不支持、
    鉴权被拒、还是域名不通，需要人工加诊断才能进一步排查。
    实现：
    1. User/esp8266_onenet_mqtt.c：新增两个 volatile 全局
    g_mqtt_substage : 0..9 跟随 s_mqtt_fsm_st
    g_mqtt_err : 1..8 细分失败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
2026-04-26 rescue: preserve workspace after auto rollback
    Save the current recoverable workspace state before cleaning generated thesis artifacts or retrying PDF sync.
    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
2026-05-16 M1.12: 代码库版本归档 —— ESP8266/MQTT 大规模重构 + app_rtos/watchdog 模块化 + OLED 诊断增强
    核心变更:
    - esp8266_tls.c 大规模重构 (1523行), esp8266_onenet_mqtt.c 重构 (705行), 优化 AT+MQTT 状态机与错误恢复
    - Capture.c 重构 (572行), 完善 SD 抓拍留存与离线队列回放逻辑
    - 新增 app_rtos.c/h: FreeRTOS 启动与任务创建模块化
    - 新增 wdg.c/h: 独立看门狗 6 路标记源抽象
    - oled_view.c 增强: 联网诊断页、MQTT 子阶段失败代码暴露
    - main.c 瘦身: 网络/控制逻辑分散到专用模块
    - board_config.h 宏开关整理, app_params.h 参数集中化
    - 新增 VERSION_DOCS.md: 当前版本全功能说明文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
2026-05-16 M1.12a: 修复 OV7670 测试图案 + syslog Flash 页擦除两大关键 BUG
    BUG 1 (ov7670cfg_qvga_rgb565.c): 0x71 寄存器 0x80→0x35，关闭测试图案
    - 原因: 0x71.bit7=1 激活 OV7670 内部移位测试图案，摄像头一直输出
    合成条纹而非实景图像
    - 修复: 改为 0x35 (bit7=0)，保留 SCALING_YSC 默认值
    BUG 2 (syslog.c): erase_page_if_needed 每槽位都擦除整页
    - 原因: 原实现每次写入槽位都检测页首非 0xFFFF 即擦除整页，
    导致同页内仅最后一条日志幸存 (此前所有槽位被擦除销毁)
    - 修复: 增加 slot_in_page==0 判定，仅页内第一个槽位才执行擦页，
    同页后续槽位顺序追加写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
    [ov7670cfg_qvga_rgb565.c, syslog.c]
2026-05-16 M1.14: 键盘功能键 + PIR HOME/AWAY 分离 + 暴力破解告警 + 管理员态重构
    键盘 A/B/C/D 功能键:
    - 管理员态 (USER_ADMIN):
    A=录入指纹 (延长窗口至60s, enroll_pending=1)
    B=清库 (FINGERPRINT_Cmd_Delete_All_Model)
    C=退出 (回到USER_NONE, 显示INPUT PASSWORD)
    D=改密 (pwd_chg_state=1, 延长窗口至60s)
    - 普通态:
    A=AWAY/撤防切换 B=HOME/撤防/AWAY→HOME C=OLED日志查看(翻页) D=紧急报警
    门锁业务重构:
    - 管理员窗口: 默认20s(APP_ADMIN_SESSION_MS), 录入/改密期间延长至60s(APP_ADMIN_SESSION_MAX_MS)
    - RELAY_TIME=0: 所有user_level统一降回USER_NONE, OLED行16显示"INPUT PASSWORD"
    - 管理员超时: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
2026-05-18 M1.14a: 编译修复 — board_config.h 补齐 APP_LOCK_BRUTE_MAX 等宏定义
    - board_config.h: APP_ADMIN_SESSION_MS 120s→20s, 新增 APP_ADMIN_SESSION_MAX_MS(60s),
    APP_LOCK_BRUTE_MAX(5), APP_BRUTE_BEEP_MS(3s), APP_PIR_CLEAR_LOW_MS(350ms)
    - lock_manager.c: 补充 #include "app_params.h"
    [board_config.h, lock_manager.c]
2026-05-18 docs: VERSION_DOCS 更新至 M1.14a，补充键盘功能键/安防模式/版本链
2026-05-18 fix(M1.15a): ESP8266重连指数退避 — 论文要求上限60秒
    将重连FSM的固定1200ms延迟替换为指数退避：每次失败翻倍(1200→2400→4800→...)，上限60秒。
    连接成功后立即重置为初始值。新增APP_NET_BACKOFF_INIT_MS=1200/APP_NET_BACKOFF_MAX_MS=60000配置宏。
    [board_config.h, esp8266_tls.c]
2026-05-18 fix(M1.15b): 第1批 — 指纹接入+IPC+蜂鸣器分级+AES方案修复
    修复4个论文-代码差距：
    1. #3 指纹解锁接入：Task_Lock/主循环中加入AS608_Find_Fingerprint轮询，
    匹配成功触发Linkage_OnUnlock(UNLOCK_SRC_FINGER)，双通道验证已激活
    2. #1 IPC机制：创建Queue(深度8)/EventGroup(3事件)/BinarySemaphore(PIR ISR唤醒)，
    Mutex保护g_sensor读写，替换全局变量裸访问
    3. #12-13 蜂鸣器分级：实现软件BEEP_Tick10ms()模式引擎，
    门禁短促3声/入侵急促连续/燃气长鸣/锁定交替，5种beep_pattern_t模式
    4. #10 AES加密：CTR→CBC模式，CRC16→AES-CBC-MAC(HMAC构造)，
    单密钥→双密钥窗口(s_ke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
    [aes128.c, aes128.h, app_params.h, app_rtos.c, app_rtos.h, app_types.h, gpio.c, gpio.h]
2026-05-18 fix(M1.15c): 第2批 — Task_Log职责+抓拍FreeRTOS+MQ-2滤波+自适应阈值基线
    1. #4 Task_Log职责：STK_LOG 320→1024/PRIO_LOG 1→3/period 1000→200ms，
    加入指纹轮询+告警队列排空+抓拍轮询，Task_Lock回归键盘+锁状态机
    2. #2 FreeRTOS抓拍：Task_Log中调用Bare_CapturePoll()，FreeRTOS模式下抓拍可用
    3. #6 MQ-2滤波：中值(窗口5)+滑动平均(窗口8)级联替代简单8样本平均
    4. #7-8 MQ-2自适应阈值：Q8定点IIR基线跟踪 Abase(k)=0.9*Abase(k-1)+0.1*Ak，
    阈值=基线+3σ+安全裕量(40ADC)，整数isqrt无浮点，100样本预热后启用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
    [app_rtos.c, main.c, mq2.c, mq2.h]
2026-05-18 fix(M1.15d): 第3批 — 温漂补偿+多浓度标定+融合评分+性能指标+常量清理
    修复5个论文-代码差距（最后一批）：
    1. #5 温漂补偿：Acomp=Araw-3.2*(T-25)，Q8定点，APP_MQ2_TEMP_K_Q8=819
    2. #16 多浓度标定：5级分段线性插值(0/300/1000/2000/3000ppm)替代简单线性
    3. #9 融合评分：S=0.5*epir+0.3*ecam+0.2*eacc，S>=0.5高可信入侵
    4. #15 性能指标：11个全局计数器+告警/命令时间戳+uptime+栈溢出日志修复
    5. #17 常量清理：board_config.h死常量注释保留，任务参数表对齐app_rtos.c
    [Capture.c, app_rtos.c, app_types.h, board_config.h, esp8266_tls.c, lock_manager.c, main.c, mq2.c]
2026-05-18 docs: VERSION_DOCS → M1.15 + FIX_REPORT 修复汇总
    M1.15 汇总 4 次提交 / 14 个修复子Agent：
    - M1.15a: ESP8266 指数退避
    - M1.15b: 指纹+IPC+蜂鸣器+AES
    - M1.15c: Task_Log+抓拍+MQ-2滤波+自适应阈值
    - M1.15d: 温漂+标定+融合+性能指标+常量清理
2026-05-18 fix(M1.16a): 第1批 — 开锁延时宏连接+任务参数对齐+board_config补全+抓拍统计补全
    🟡7: RELAY_TIME=15硬编码→APP_LOCK_OPEN_HOLD_TICKS (APP_LOCK_OPEN_HOLD_MS/1000)
    🟡8: Task_Net栈640→1024, Task_Sensor栈384→256, 周期10→100ms, Task_OLED周期100→200ms
    🟡9: board_config.h任务周期对齐实际值, 新增OLED任务宏, app_rtos.c引用宏替代硬编码
    🟡14: Capture_LocalSnapshot补全尝试/成功计数, 离线队列统计导出为全局变量
    [Capture.c, Capture.h, app_params.h, app_rtos.c, board_config.h, esp8266_tls.c, lock_manager.c, main.c]
2026-05-18 fix(M1.16b): 第2批 — 远程开锁安全检查+环形去重+即时告警推送+PIR三段滤波
    🟡1: OneNET远程开锁前检查LockManager_IsPwdLocked/IsBruteAlarm，锁定/暴力告警状态拒绝
    🟡3: 命令去重从单槽改为APP_CMD_DEDUP_RING=16环形缓冲区+APP_CMD_STALE_MS=60s过期
    🟡10: 新增OneNET_Publish_Alarm即时推送，Linkage_MQTT_Report中ALARM:消息同步走MQTT
    🟡11: HC_SR501三段式误触发抑制(毛刺60ms+最小脉宽200ms+冷却3000ms)，替代简化抑制模型
    [app_rtos.c, board_config.h, esp8266_tls.c, esp8266_tls.h, hc_sr501.c, hc_sr501.h, linkage.c, main.c]
2026-05-18 fix(M1.16c): 第3批 — 远程抓拍+阈值配置命令+PIR灵敏度运行时可调
    🟡2: OneNET_Parse_Cmd新增capture/snapshot手动抓拍命令(CAP_EVT_REMOTE)+threshold阈值配置(pir_debounce可调)
    🟡13: HC_SR501_DEBOUNCE_MS改为运行时变量g_pir_debounce_ms(默认80ms,范围20-200ms),MQTT命令可调
    [app_params.h, capture_task.h, esp8266_tls.c, hc_sr501.c, hc_sr501.h]
2026-05-18 fix(M1.16d): 第4批 — 门禁FSM+安防FSM+执行器反馈澄清+抓拍复核判定
    🟡5: lock_manager门禁五态FSM(DOOR_IDLE/ACQUIRE/MATCH/OPEN/LOCKOUT),形式化状态推导函数
    🟡6: 安防五态FSM(SEC_DISARMED/ARMED/TRIGGERED/ALARMING/RECOVERY),app_rtos+main状态更新
    🟡4: 执行器反馈澄清为定时自动锁止(无硬件反馈引脚),APP_ACTUATOR_FEEDBACK_ENABLE预留
    🟡12: ecam从g_cap_evt_pending改为g_cap_last_ok结果驱动,新增校验失败计数
    [Capture.c, Capture.h, app_rtos.c, app_types.h, board_config.h, lock_manager.c, main.c, timer.c]
2026-05-18 fix(M1.16h): 移除MQTT上行冗余ctrl_arm字段
2026-05-18 fix(M1.16h): 为门锁OD与燃气阀PP模式差异添加硬件说明注释
2026-05-18 fix(M1.16h): USART驱动添加USART3正确命名别名宏
2026-05-18 feat: 多Agent并行验证报告 + GitHub Actions CI配置
    6组模块+1组集成共7份验证报告，发现6个P0+21个P1+46个P2问题。
    CI配置Cppcheck静态分析(arm32平台)和ARM GCC语法检查。
2026-05-19 fix: 修复13处P0+P1问题 — Flash配置/Syslog槽位/JTAG/栈/消抖/数据竞争等
    P0修复(4): Flash 128→256, Syslog槽位32→40, JTAG释放, Task_Net栈→static
    P1阻塞(5): taskYIELD, VSYNC超时, PIR消抖ms基准, Uart2_Buf保护, BEEP时序
    P1功能(4): 改密流程, MQ2卡死检测, DHT11退避, OLED GRAM互斥
    [Capture.c, app_rtos.c, esp8266_tls.c, hc_sr501.c, lock_manager.c, main.c, stmflash.h]
2026-05-19 docs: 修复验证报告 — 13处P0+P1修复全部通过复核
2026-05-19 fix: 修复编译错误 — hc_sr501 volatile类型不匹配 + usart2.h换行 + UART1_SendStr隐式声明
    - hc_sr501.h: extern声明添加volatile匹配.c定义 (#147)
    - usart2.h: 文件末尾补充换行符 (#1-D)
    - app_rtos.c: 添加usart1.h头文件 + UART1_SendStr别名宏 (#223-D)
    - esp8266_tls.c: g_pir_debounce_ms声明补充volatile（审核补充）
    [app_rtos.c, esp8266_tls.c, hc_sr501.h, usart2.h]
2026-05-19 fix: 修复链接错误 — s_sensor_mtx 去掉static使符号全局可见
    app_rtos.c:67 的 static 使 s_sensor_mtx 仅文件内可见，syslog.c
    通过 extern 引用导致 L6218E 链接错误。去掉 static 解决。
    [app_rtos.c]
2026-05-19 fix: 为全部61个源文件添加UTF-8 BOM，修复Keil中文注释乱码
    所有.c/.h文件从UTF-8无BOM转为UTF-8 with BOM，Keil MDK在中文Windows
    上识别BOM后以UTF-8正确显示中文注释。ARMCC V5编译器忽略BOM字节，
    不影响编译。
    [Capture.c, Capture.h, app_params.h, app_rtos.c, app_rtos.h, app_types.h, as608.c, as608.h]
2026-05-19 fix: OV7670数据链路6项修复 — 时钟/寄存器/SCCB/SD写入/时序/稳定
    P0: 新增BOARD_OV7670_MCO_ENABLE宏，PA8可输出8MHz HSE给OV7670 XCLK（默认关，模块无晶振时启用）
    P1: 寄存器表20→113条，补色彩矩阵/伽马/AWB/AEC/DSP/镜头校正，显著提升画质
    P1: SCCB时序60us→10us/bit，初始化700ms→40ms（+300ms传感器稳定）
    P1: capture_one_to_sd改为自上而下顺序写入，消除240次f_lseek，SPI写时切18MHz，加BMP校验
    P2: FIFO ReadByte加NOP延迟提升信号完整性
    P2: 寄存器写完加300ms AWB/AEC/AGC收敛延时
    [Capture.c, board_config.h, ov7670_fifo.c, ov7670cfg_qvga_rgb565.c, ov7670cfg_qvga_rgb565.h, sccb.c]
